Ixox/preenfm3/README.md

# preenfm3

Here are the sources for the preenfm3 bootloader and firmware.

Binaries can be found in the [Release section](https://github.com/Ixox/preenfm3/releases).

For the documentation, go to [the Wiki](https://github.com/Ixox/preenfm3/wiki).

Xavier
