Ixox/preenfm3/hardware/3DCase/pfm3Bottom.stl

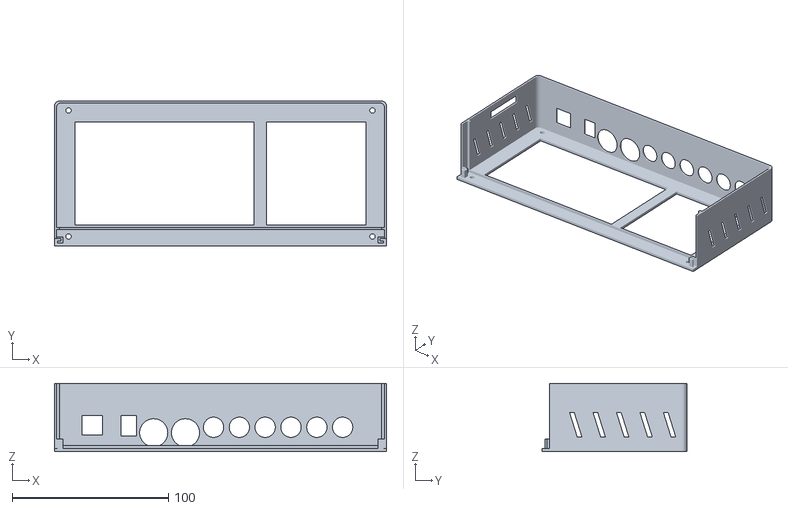
[picture p9: CAD file, 2020-09-30]
hardware/3DCase/pfm3Bottom.stl
212.3 x 92.6 x 43.5
