Ixox/preenfm3/hardware/3DCaseB/front_slim.stl

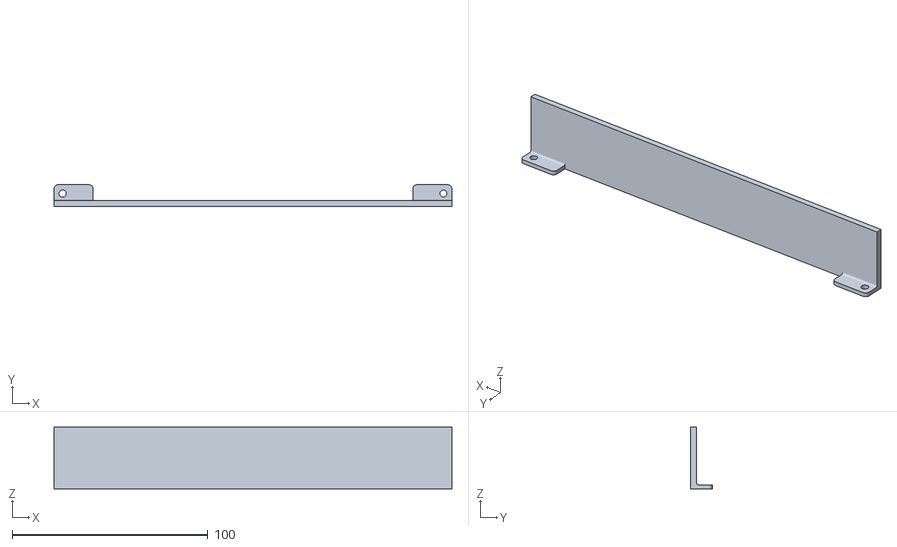
[picture p10: CAD file, 2021-01-17]
hardware/3DCaseB/front_slim.stl
203.1 x 11.0 x 31.4
