Ixox/preenfm3/hardware/3DCasePCB/3DPrint-Rear.stl

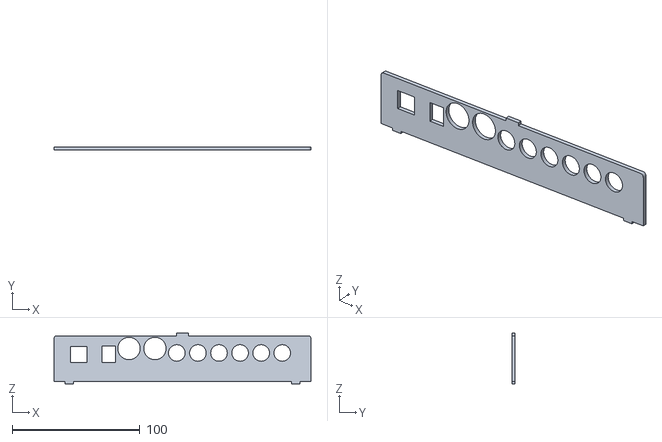
[picture p11: CAD file, 2021-04-17]
hardware/3DCasePCB/3DPrint-Rear.stl
201.2 x 2.70 x 39.6
