Ixox/preenfm3/hardware/3DCase/pfm3Top.stl

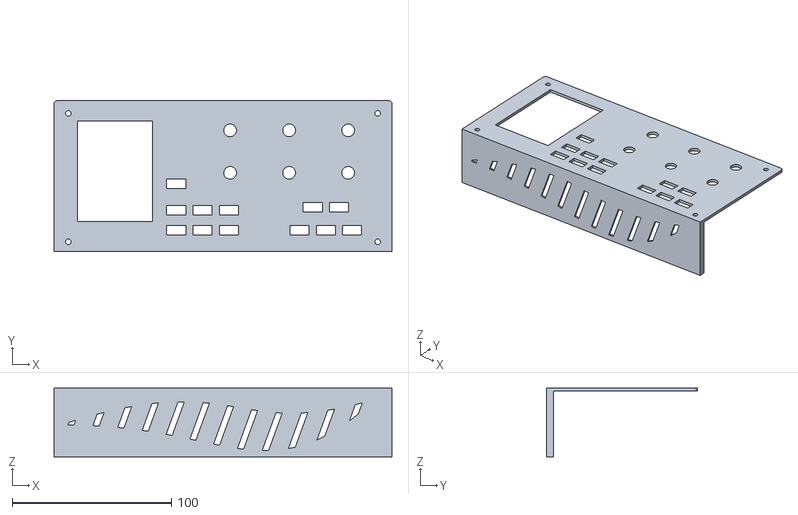
[picture p12: CAD file, 2020-09-30]
hardware/3DCase/pfm3Top.stl
212.3 x 94.6 x 43.3
