Ixox/preenfm3/hardware/3DCaseB/Rear_slim.stl

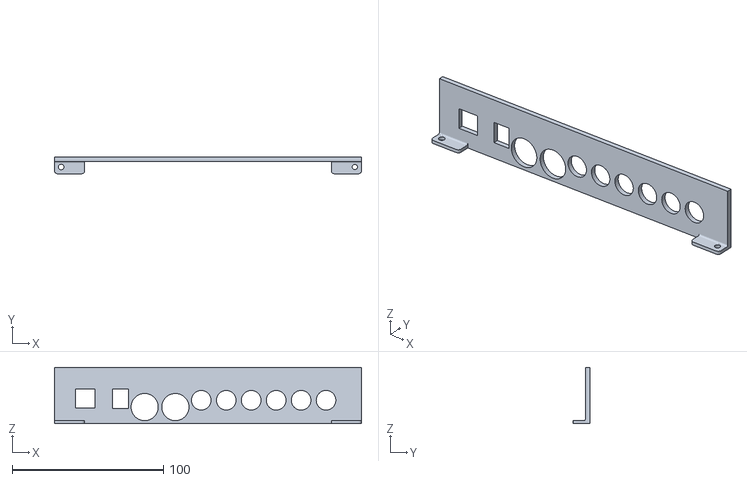
[picture p13: CAD file, 2021-01-17]
hardware/3DCaseB/Rear_slim.stl
203.1 x 11.0 x 37.3
