Ixox/preenfm3/hardware/3DCasePCB/3DPrint-Case.stl

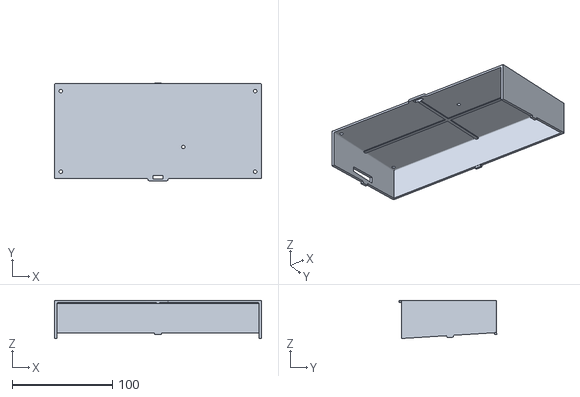
[picture p14: CAD file, 2021-04-17]
hardware/3DCasePCB/3DPrint-Case.stl
207.0 x 97.6 x 38.0
