Ixox/preenfm3/hardware/3DCaseB/bottom.stl

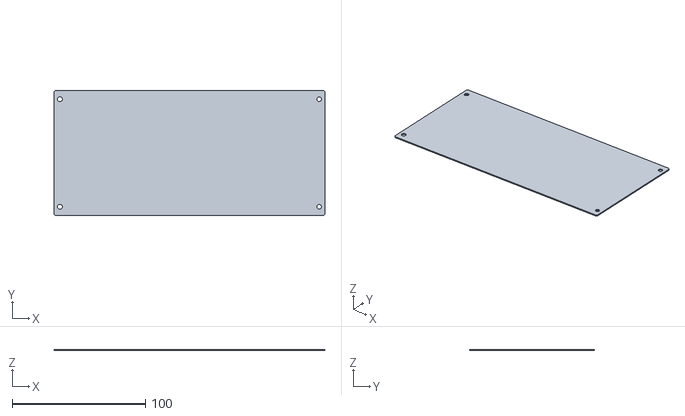
[picture p15: CAD file, 2020-10-13]
hardware/3DCaseB/bottom.stl
203.1 x 93.6 x 0.9
