Ixox/preenfm3/hardware/3DCaseB/front.stl

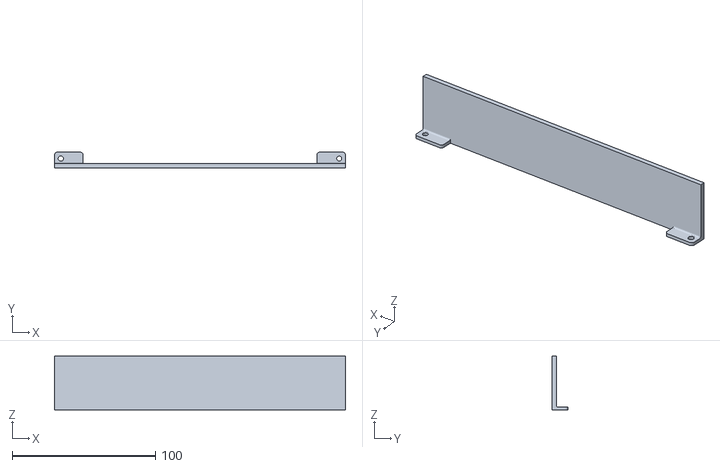
[picture p16: CAD file, 2020-10-13]
hardware/3DCaseB/front.stl
203.1 x 11.0 x 37.4
