Ixox/preenfm3/hardware/3DCaseB/Top.stl

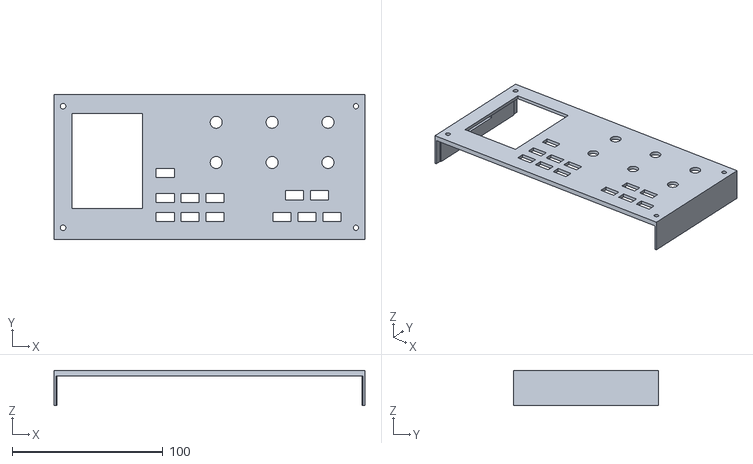
[picture p17: CAD file, 2020-10-13]
hardware/3DCaseB/Top.stl
206.3 x 96.1 x 23.4
