Ixox/preenfm3/hardware/3DCaseB/Rear.stl

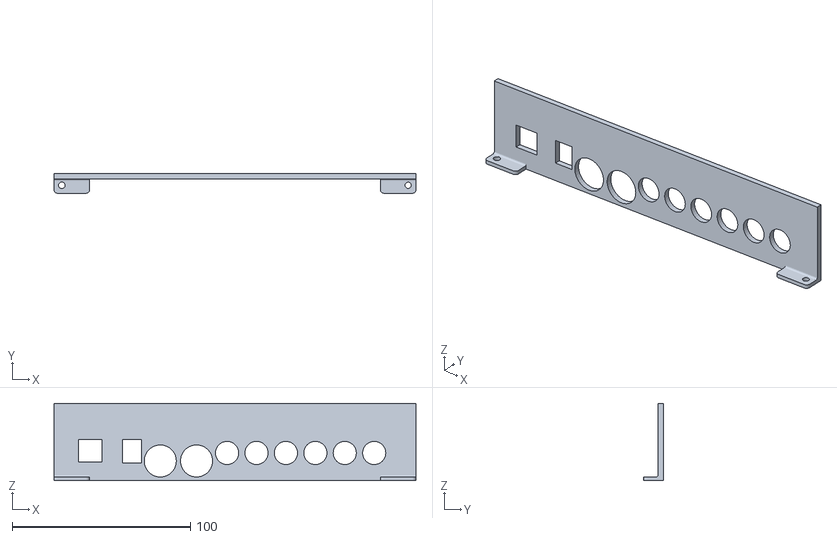
[picture p18: CAD file, 2020-10-13]
hardware/3DCaseB/Rear.stl
203.1 x 11.0 x 43.3
