Ixox/preenfm3/(list of files, cad)

Other CAD files:
hardware/3DCase/pfm3FrontPanel.f3d
hardware/3DCaseB/pfm3EnclosureV2.f3d
