Ixox/preenfm3/(threads)

Thread 3 (2020-10-16):

After flashin to 0.91 SD-Card is not readable

gritd, 2020-10-16:
I flash via dfuse, when I go back to 0.9 it all works again, but if i put .91 on it I get no read from the card. Also bootloader menu does not show valid filenames.

Ixox, 2020-10-26:
0.91 use DMA to send and receive data from the SD Card.
I don't know what it does not work with your SDCard.
What sdcard do you use ?

Ixox, 2021-01-03:
I assume it's working now.

gritd, 2021-01-03:
Not really 😬 I decided to wait in using the PreenFM3 until the enclosure
arrives - if I have problems with the SDcard later on I’ll post it, thanks!

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

Closed 2021-01-03.

Thread 4 (2020-11-05):

avoid wiki docs

axd1967, 2020-11-05:
This is a good step forward and please continue this way.

There is one issue that I would urge to change: avoid the wiki. Wikis look attractive (especially their menu system) but they have a major problem: they cannot be kept in sync with branches/code changes, because they are separate repositories. (And I'm more and more inclined to think that this is a fundamental issue with wikis on GitHub.)

Wiki-like pages can just as well be created in (e.g.) a `wiki/` folder under https://github.com/Ixox/preenfm3. this will allow to keep "wiki" pages and code in sync, because changes in firmware will sometimes impose changes in wiki pages, but because the commit/release cycles are different, there will be a need to keep wiki and code somehow in line during such transitions. branches are the natural way to deal with this: in a branch, code and wiki pages are updated at the same time, and this tight linking provides an additional bit of documentaiton. Also, this allows anyone that tracks the code to also detect changes in the wiki, and it bundles really all project information in one single repository that can easily be cloned.

Admitted, the wiki provides nice menus, that a normal page won't (but you can also benefit from markup in normal pages, e.g. by using `.rst` an an example).

See also https://github.com/Ixox/preenfm2/issues/1

Ixox, 2020-11-09:
Thanks that's interesting.
Will think about that.

axd1967, 2020-11-09:
If you think of it, `preenfm3` is just an evolution of `preenfm2` which is an evolution of `preenfm`. This is VCS parlance for "versions".

This can all be managed from a single repo.

Every new model starts off the latest branch of a previous model as a development branch (eg `model/3/idea`, `model/3/dev`) and is finally merged to a "master" (`model/3/maintenance`) and tagged (eg `v/2/2.08`, `v/2/2.20.b2`, `v/3/0.1`, `v/3/0.94`, ...)

Note the use of slashes to further increase the organisation of the tag namespace and avoid all tags ending up in a single tag namespace "soup" .  This can then also be admired from the CLI:

```
alex@xray:/tmp/preenfm3$ tree .git

.git
├── branches
├── config
├── description
├── FETCH_HEAD
├── gitk.cache
├── HEAD
├── hooks
│   ├── applypatch-msg.sample
│   ├── commit-msg.sample
│   ├── fsmonitor-watchman.sample
│   ├── post-update.sample
│   ├── pre-applypatch.sample
│   ├── pre-commit.sample
│   ├── pre-merge-commit.sample
│   ├── prepare-commit-msg.sample
│   ├── pre-push.sample
│   ├── pre-rebase.sample
│   ├── pre-receive.sample
│   └── update.sample
├── index
├── info
│   └── exclude
├── logs
│   ├── HEAD
│   └── refs
│       ├── heads
│       │   ├── master
│       │   └── model
│       │       ├── 3
│       │       │   └── maintenance
│       │       └── 4
│       │           └── dev
│       └── remotes
│           └── lxox
│               ├── Fdbk
│               ├── HEAD
│               ├── master
│               └── v094
├── objects

...
│   ├── info
│   └── pack
│       ├── pack-1fc59af7d14e7bfbe09e81c3f220f8514c556913.idx
│       └── pack-1fc59af7d14e7bfbe09e81c3f220f8514c556913.pack
├── ORIG_HEAD
├── packed-refs
└── refs
    ├── heads
    │   ├── master
    │   └── model
    │       ├── 3
    │       │   └── maintenance
    │       └── 4
    │           └── dev
    ├── remotes
    │   ├── lxox
    │   │   ├── Fdbk
    │   │   ├── HEAD
    │   │   ├── master
    │   │   └── v094
    │   └── origin
    └── tags
        └── v
            └── 3
                ├── 0.90
                ├── 0.93
                ├── 0.94
                ├── 1.0
                └── 1.0.1

55 directories, 73 files

```

`master` can become the development branch of the latest model but I would ditch `master` and use `model/N/dev` and `model/N/maintenance`; earlier, released models just receive maintenance branches (`model/N/maintenance`) to fix issues.

```
* c31668a (HEAD -> master, model/4/dev) release model 4
* 6356042 prepare for release
* e13683b continue R&D
*   4563fcf Merge branch 'model/3/dev'
|\
| * 382dbea more work
| * 273eb86 more work
| * 6a155e5 test
| | * 884ae7d (tag: v/3/1.0.1, model/3/maintenance) bugfix for model 3
| |/
|/|
* | 0fcdbf0 (tag: v/3/1.0) final!
* | c78e67f bugfix
* | f15655d (tag: v0.94, tag: v/3/0.94, lxox/master, lxox/HEAD) Remove Debug info from Release
* | af9ff15 Merge pull request #5 from Ixox/v094
|\|
| * ac59d07 (lxox/v094) Fix buton state bug (Crash)
| * c5db765 Multiple edition show up in green
| * 86f4438 Multiple param edition : EDIT + encoder turn
| * 49b342b v0.94 first commit
| * 2df6b30 Modification to use last lib
| * dff063d Small display optimization and stability
| * 4233930 Control board v1.1
|/
* c086304 (tag: v0.93, tag: v/3/0.93) Bootlader 1.03 TFT fixed
* 0621950 Slower and much more stable UI with some TFTs
* c496182 Fix quick start doc
* 7cb2100 doc/README added
* 1405230 Add quick start pdf doc
* 04bc544 (tag: v0.92) Tiny type fix
* 26a9d33 Limit SD SPI to 12.5Mhz (will use actually 7.5Mhz)
* c815cb4 Bootloader 1.02 : use button 1,2,3
* c0ab974 Create object use _ in bin names
* bb52e92 No more DEBUG preprocessing in Release
* 9d41875 Better Seq presentation
* 412e46b Fix seq cursor refresh bug
* 251d024 Sequencer has its own default file
* dc86de4 Sequence V2 bug fix
* 5276057 Sequencer V2 + many small fixes
* 8a0f6af update version.h
* eb0416d Add colors after reinit TFT
* b9349bf Faster encoder polling
* dce21d6 3DCaseB added
* eaef23f (tag: v0.91) Allow -O3 on preenfm3_lib
* 6850231 Bootloader fixed : SD access don't use DMA
*   4510205 Merge pull request #2 from Ixox/Fdbk

```

a bit simplified:

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

As you can see, I use `gitk`... The power of Git is in the concepts.

Some Git clients can represent tags and branches in a nice tree (which then allows to collapse unneeded sections), that's an additional reason to use slashes in those names.

Consider this approach for version 4 onwards? This will unify all future work of all preenFM knowledge in a single repo.

Ixox, 2020-11-21:
Thanks a lot for the detailed message.
If one day i have more free time, i'll change many things (better git management is one of those ;) ).

axd1967, 2020-11-21:
Don't worry - this is a slow but steady process, you are on the right track.

Thread 48 (2024-05-07):

Sequencer insert note after clearing

WouterSpekkink, 2024-05-07:
I was exploring the sequencer and I noticed one weird behavior. If you insert an empty space (button 1), then it is no longer possible to dial in a note in that space. You can only insert notes in the space again after clearing the whole pattern.

pvig, 2024-05-15:
I cannot reproduce the issue.
Do you have any clue about it ?

WouterSpekkink, 2024-05-16:
To be clear, the problem only occurs when I try to dial in notes (without the midi controller). Inserting notes with a midi controller still works after inserting a blank space.

I was trying to see if the sequencer could work as a standalone (without midi controller), but I have noticed that notes also don't play unless at least one of them was inserted with a midi controller.

pvig, 2024-05-16:
ok, i could reproduce the issue :
you can't edit notes with the "Note" key pressed and encoder B, on a cleared spaces ,
a workaround is to fill a whole row with one note, and then you can edit smaller notes inside it,
but yes, it would be nice to be able to add notes with this method.

I face another issue : new notes seems to be retriggered on each ticks for some reason.
Old sequences loaded at synth startup works well.

Thread 50 (2024-05-10):

Program Change reverts to preen presets even if dx7 preset is loaded.

abelnation, 2024-05-10:
(This is my current understanding) When I load a dx7 sysex file, I would expect program change messages to select patches from the same dx7 file; however, it appears that PC messages only select patches from whatever the current/last preen bank is currently selected.

Thread 57 (2025-09-03):

DX7 import loads saw instead of sin

gresade, 2025-09-03:
When importing patches, e.g. "PIANO 32" form "PIANO_01.SYX" using algo 18,
Operator 3 loads the saw waveform, which should be sin.
Changing the Operator to 3 adjusts the sound in the right direction, sounding more piano-ish.
It looks like many sounds are sounding different (modulated too much) than in the DX7 due to the saw loaded in Hexter.cpp into Oscs if fb>4.
As there is now a feedback setting available, this saw code fix is not needed anymore, I guess?

I think in any case sin should be loaded in all operators for DX7 patches?
