Ixox/preenfm3/(list of files, drawings)

Other design files:
hardware/controlboard_SMD/v1.x_for_v2.x/pfm3_ctrl.dsn
