Ixox/preenfm3/hardware/controlboard_SMD/v1.x_for_v2.x/pfm3_ctrl.kicad_pcb

## KiCad design hardware/controlboard_SMD/v1.x_for_v2.x/pfm3_ctrl.kicad_pcb (2023-05-15)

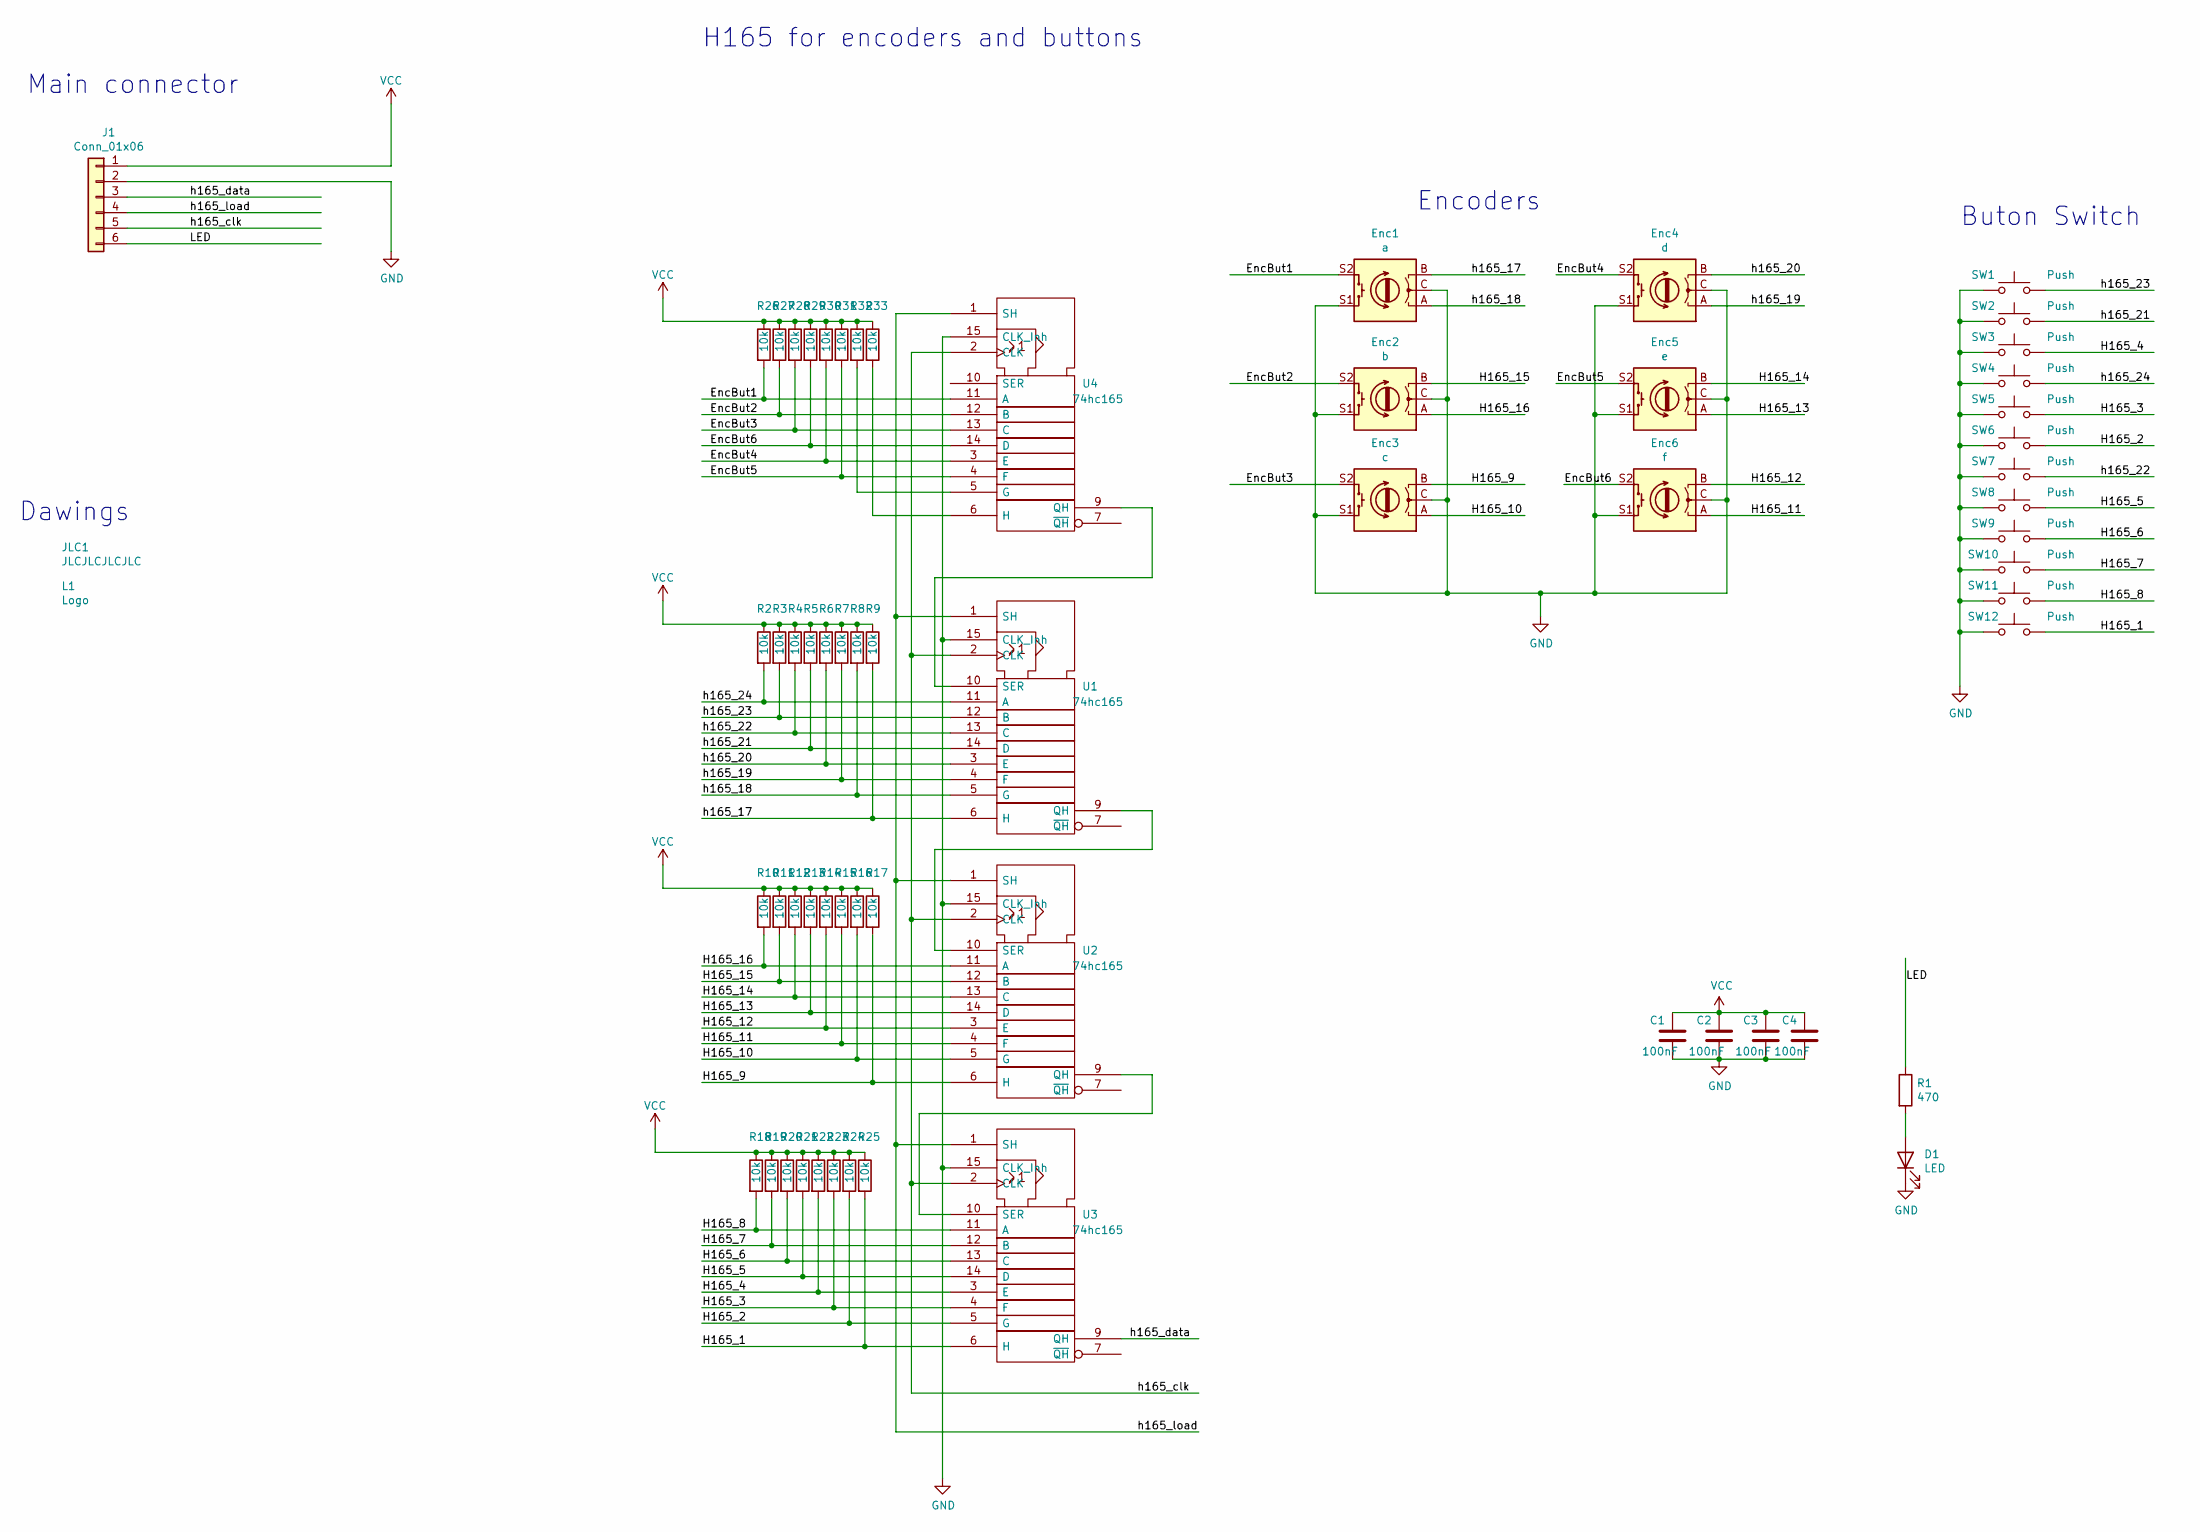
[picture p19: schematic pfm3_ctrl.sch, preenfm3]

Parts:
C1, C2, C3, C4: 100nF; C_0402_1005Metric
D1: LED; LED_0603_1608Metric
Enc1: a; FMEncoder2_pfm3
Enc2: b; FMEncoder2_pfm3
Enc3: c; FMEncoder2_pfm3
Enc4: d; FMEncoder2_pfm3
Enc5: e; FMEncoder2_pfm3
Enc6: f; FMEncoder2_pfm3
J1: Conn_01x06; ControlBoard_2
JLC1: JLCJLCJLCJLC; JLCJLC
L1: Logo; pfm2_logo
R1: 470; R_0603_1608Metric
R2, R3, R4, R5, R6, R7, R8, R9, R10, R11, R12, R13, R14, R15, R16, R17, R18, R19, R20, R21, R22, R23, R24, R25, R26, R27, R28, R29, R30, R31, R32, R33: 10k; R_0402_1005Metric
SW1, SW2, SW3, SW4, SW5, SW6, SW7, SW8, SW9, SW10, SW11, SW12: Push; FMButton2
U1, U2, U3, U4: 74hc165; SOIC-16_3.9x9.9mm_P1.27mm

Connections:
/EncBut1: Enc1.S2, R26.2, U4.11 (A)
/EncBut2: Enc2.S2, R27.2, U4.12 (B)
/EncBut3: Enc3.S2, R28.2, U4.13 (C)
/EncBut4: Enc4.S2, R30.2, U4.3 (E)
/EncBut5: Enc5.S2, R31.2, U4.4 (F)
/EncBut6: Enc6.S2, R29.2, U4.14 (D)
/H165_1: R25.2, SW12.2, U3.6 (H)
/H165_2: R24.2, SW6.2, U3.5 (G)
/H165_3: R23.2, SW5.2, U3.4 (F)
/H165_4: R22.2, SW3.2, U3.3 (E)
/H165_5: R21.2, SW8.2, U3.14 (D)
/H165_6: R20.2, SW9.2, U3.13 (C)
/H165_7: R19.2, SW10.2, U3.12 (B)
/H165_8: R18.2, SW11.2, U3.11 (A)
/H165_9: Enc3.B, R17.2, U2.6 (H)
/H165_10: Enc3.A, R16.2, U2.5 (G)
/H165_11: Enc6.A, R15.2, U2.4 (F)
/H165_12: Enc6.B, R14.2, U2.3 (E)
/H165_13: Enc5.A, R13.2, U2.14 (D)
/H165_14: Enc5.B, R12.2, U2.13 (C)
/H165_15: Enc2.B, R11.2, U2.12 (B)
/H165_16: Enc2.A, R10.2, U2.11 (A)
/LED: J1.6, R1.1
/h165_17: Enc1.B, R9.2, U1.6 (H)
/h165_18: Enc1.A, R8.2, U1.5 (G)
/h165_19: Enc4.A, R7.2, U1.4 (F)
/h165_20: Enc4.B, R6.2, U1.3 (E)
/h165_21: R5.2, SW2.2, U1.14 (D)
/h165_22: R4.2, SW7.2, U1.13 (C)
/h165_23: R3.2, SW1.2, U1.12 (B)
/h165_24: R2.2, SW4.2, U1.11 (A)
/h165_clk: J1.5, U1.2 (CLK), U2.2 (CLK), U3.2 (CLK), U4.2 (CLK)
/h165_data: J1.3, U3.9 (QH)
/h165_load: J1.4, U1.1 (SH), U2.1 (SH), U3.1 (SH), U4.1 (SH)
GND: C1.2, C2.2, C3.2, C4.2, D1.1 (K), Enc1.C, Enc1.S1, Enc2.C, Enc2.S1, Enc3.C, Enc3.S1, Enc4.C, Enc4.S1, Enc5.C, Enc5.S1, Enc6.C, Enc6.S1, J1.2, SW1.1, SW2.1, SW3.1, SW4.1, SW5.1, SW6.1, SW7.1, SW8.1, SW9.1, SW10.1, SW11.1, SW12.1, U1.8 (GND), U1.15 (CLK_Inh), U2.8 (GND), U2.15 (CLK_Inh), U3.8 (GND), U3.15 (CLK_Inh), U4.8 (GND), U4.15 (CLK_Inh)
unnamed: D1.2 (A), R1.2
unnamed: R32.2, U4.5 (G)
unnamed: R33.2, U4.6 (H)
unnamed: U1.9 (QH), U2.10 (SER)
unnamed: U1.10 (SER), U4.9 (QH)
unnamed: U2.9 (QH), U3.10 (SER)
VCC: C1.1, C2.1, C3.1, C4.1, J1.1, R2.1, R3.1, R4.1, R5.1, R6.1, R7.1, R8.1, R9.1, R10.1, R11.1, R12.1, R13.1, R14.1, R15.1, R16.1, R17.1, R18.1, R19.1, R20.1, R21.1, R22.1, R23.1, R24.1, R25.1, R26.1, R27.1, R28.1, R29.1, R30.1, R31.1, R32.1, R33.1, U1.16 (VCC), U2.16 (VCC), U3.16 (VCC), U4.16 (VCC)

Notes on the sheet:
Buton Switch
Encoders
H165 for encoders and buttons
Main connector
Dawings

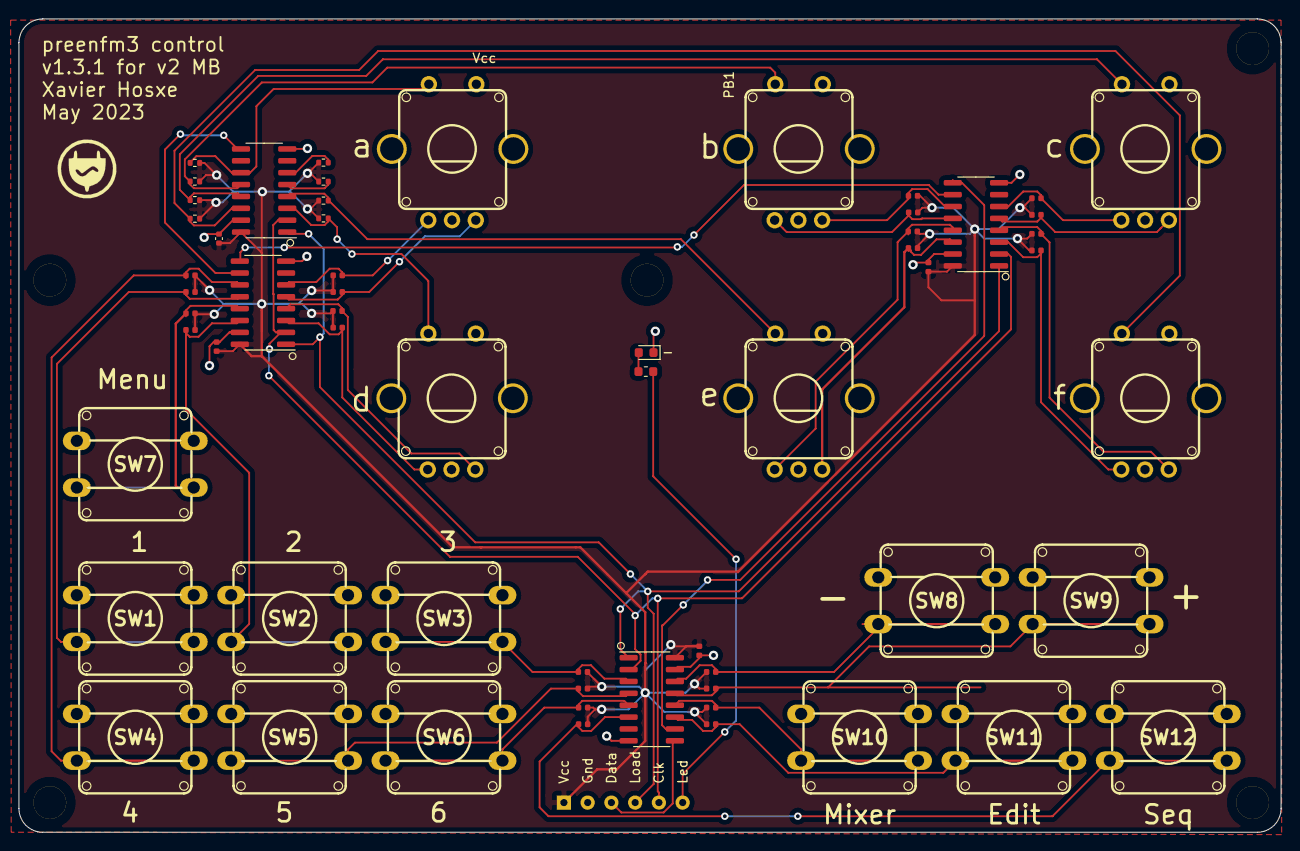
[picture p20: board hardware/controlboard_SMD/v1.x_for_v2.x/pfm3_ctrl.kicad_pcb from above]

Board: 2 copper layers, 135.0 x 87.0 mm, 63 parts (1 on the bottom side), 42 nets.
