Ixox/preenfm3/hardware/controlboard/pfm3_ctrl.kicad_pcb

## KiCad design hardware/controlboard/pfm3_ctrl.kicad_pcb (2020-09-22, an earlier design)

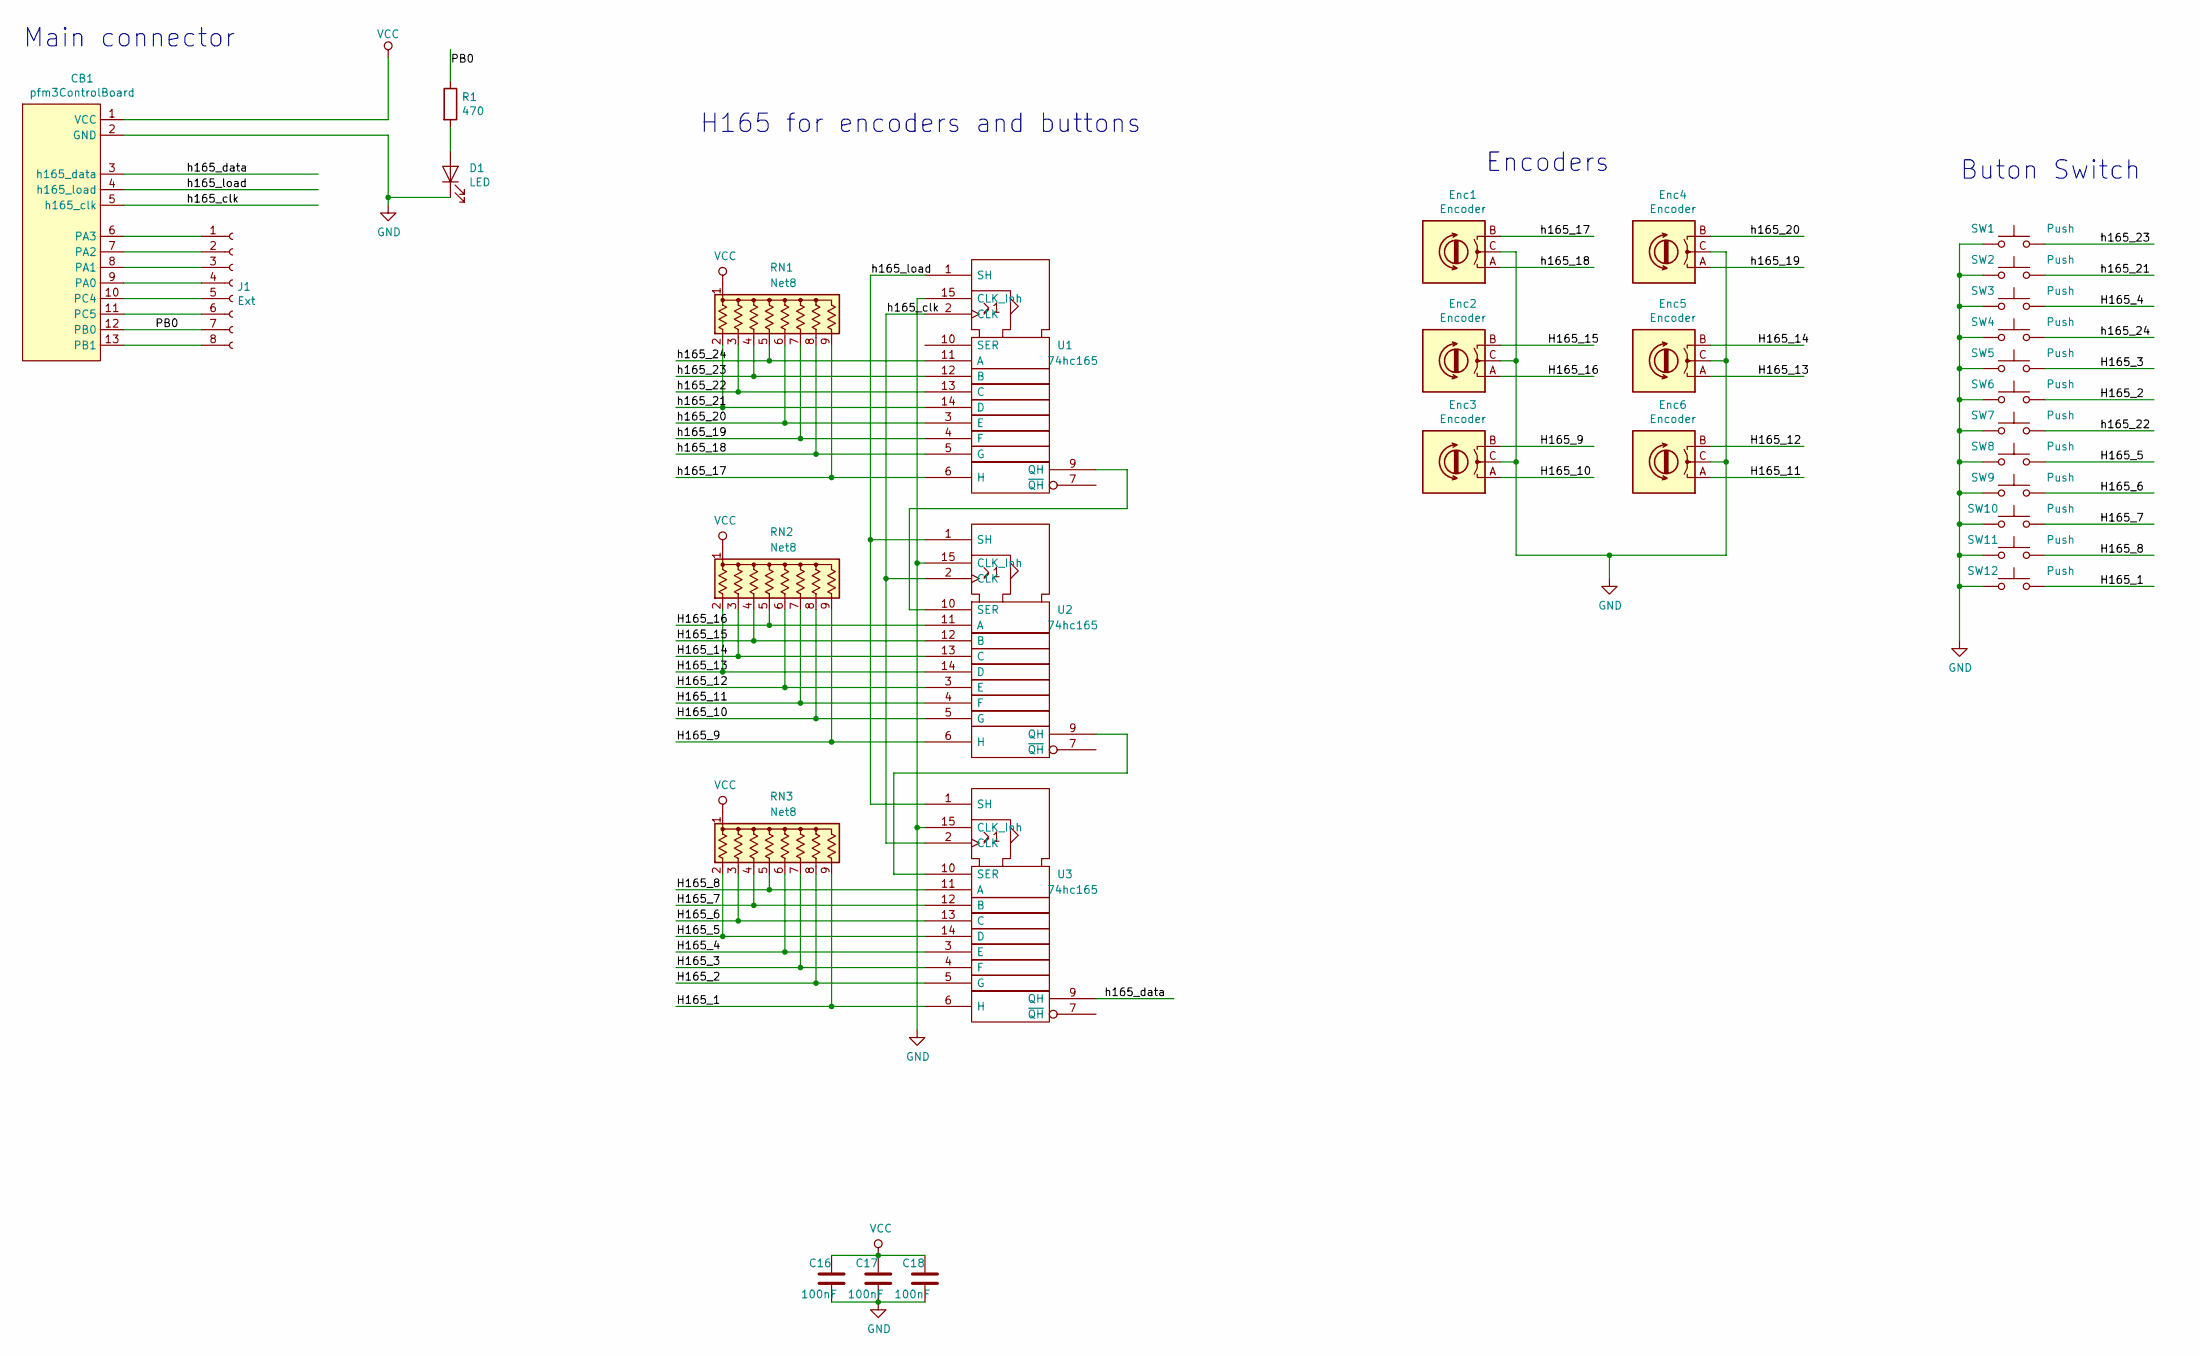
[picture p21: schematic pfm3_ctrl.sch, preenfm3]

Parts:
C16, C17, C18: 100nF; C_Disc_D3.0mm_W1.6mm_P2.50mm
CB1: pfm3ControlBoard; ControlBoard
D1: LED; FMLed_pfm3
Enc1, Enc2, Enc3, Enc4, Enc5, Enc6: Encoder; FMEncoder2_pfm3
J1: Ext; PinHeader_1x08_P2.54mm_Vertical
R1: 470; R_Axial_DIN0207_L6.3mm_D2.5mm_P7.62mm_Horizontal
RN1, RN2, RN3: Net8; R_Array_SIP9
SW1, SW2, SW3, SW4, SW5, SW6, SW7, SW8, SW9, SW10, SW11, SW12: Push; FMButton2
U1, U2, U3: 74hc165; 74HC165

Connections:
/H165_1: RN3.9 (R8), SW12.2, U3.6 (H)
/H165_2: RN3.8 (R7), SW6.2, U3.5 (G)
/H165_3: RN3.7 (R6), SW5.2, U3.4 (F)
/H165_4: RN3.6 (R5), SW3.2, U3.3 (E)
/H165_5: RN3.2 (R1), SW8.2, U3.14 (D)
/H165_6: RN3.3 (R2), SW9.2, U3.13 (C)
/H165_7: RN3.4 (R3), SW10.2, U3.12 (B)
/H165_8: RN3.5 (R4), SW11.2, U3.11 (A)
/H165_9: Enc3.B, RN2.9 (R8), U2.6 (H)
/H165_10: Enc3.A, RN2.8 (R7), U2.5 (G)
/H165_11: Enc6.A, RN2.7 (R6), U2.4 (F)
/H165_12: Enc6.B, RN2.6 (R5), U2.3 (E)
/H165_13: Enc5.A, RN2.2 (R1), U2.14 (D)
/H165_14: Enc5.B, RN2.3 (R2), U2.13 (C)
/H165_15: Enc2.B, RN2.4 (R3), U2.12 (B)
/H165_16: Enc2.A, RN2.5 (R4), U2.11 (A)
/PB0: CB1.12 (PB0), J1.7, R1.1
/h165_17: Enc1.B, RN1.9 (R8), U1.6 (H)
/h165_18: Enc1.A, RN1.8 (R7), U1.5 (G)
/h165_19: Enc4.A, RN1.7 (R6), U1.4 (F)
/h165_20: Enc4.B, RN1.6 (R5), U1.3 (E)
/h165_21: RN1.2 (R1), SW2.2, U1.14 (D)
/h165_22: RN1.3 (R2), SW7.2, U1.13 (C)
/h165_23: RN1.4 (R3), SW1.2, U1.12 (B)
/h165_24: RN1.5 (R4), SW4.2, U1.11 (A)
/h165_clk: CB1.5 (h165_clk), U1.2 (CLK), U2.2 (CLK), U3.2 (CLK)
/h165_data: CB1.3 (h165_data), U3.9 (QH)
/h165_load: CB1.4 (h165_load), U1.1 (SH), U2.1 (SH), U3.1 (SH)
GND: C16.2, C17.2, C18.2, CB1.2 (GND), D1.1 (K), Enc1.C, Enc2.C, Enc3.C, Enc4.C, Enc5.C, Enc6.C, SW1.1, SW2.1, SW3.1, SW4.1, SW5.1, SW6.1, SW7.1, SW8.1, SW9.1, SW10.1, SW11.1, SW12.1, U1.8 (GND), U1.15 (CLK_Inh), U2.8 (GND), U2.15 (CLK_Inh), U3.8 (GND), U3.15 (CLK_Inh)
unnamed: CB1.6 (PA3), J1.1
unnamed: CB1.7 (PA2), J1.2
unnamed: CB1.8 (PA1), J1.3
unnamed: CB1.9 (PA0), J1.4
unnamed: CB1.10 (PC4), J1.5
unnamed: CB1.11 (PC5), J1.6
unnamed: CB1.13 (PB1), J1.8
unnamed: D1.2 (A), R1.2
unnamed: U1.9 (QH), U2.10 (SER)
unnamed: U2.9 (QH), U3.10 (SER)
VCC: C16.1, C17.1, C18.1, CB1.1 (VCC), RN1.1 (common), RN2.1 (common), RN3.1 (common), U1.16 (VCC), U2.16 (VCC), U3.16 (VCC)

Notes on the sheet:
Buton Switch
Encoders
H165 for encoders and buttons
Main connector

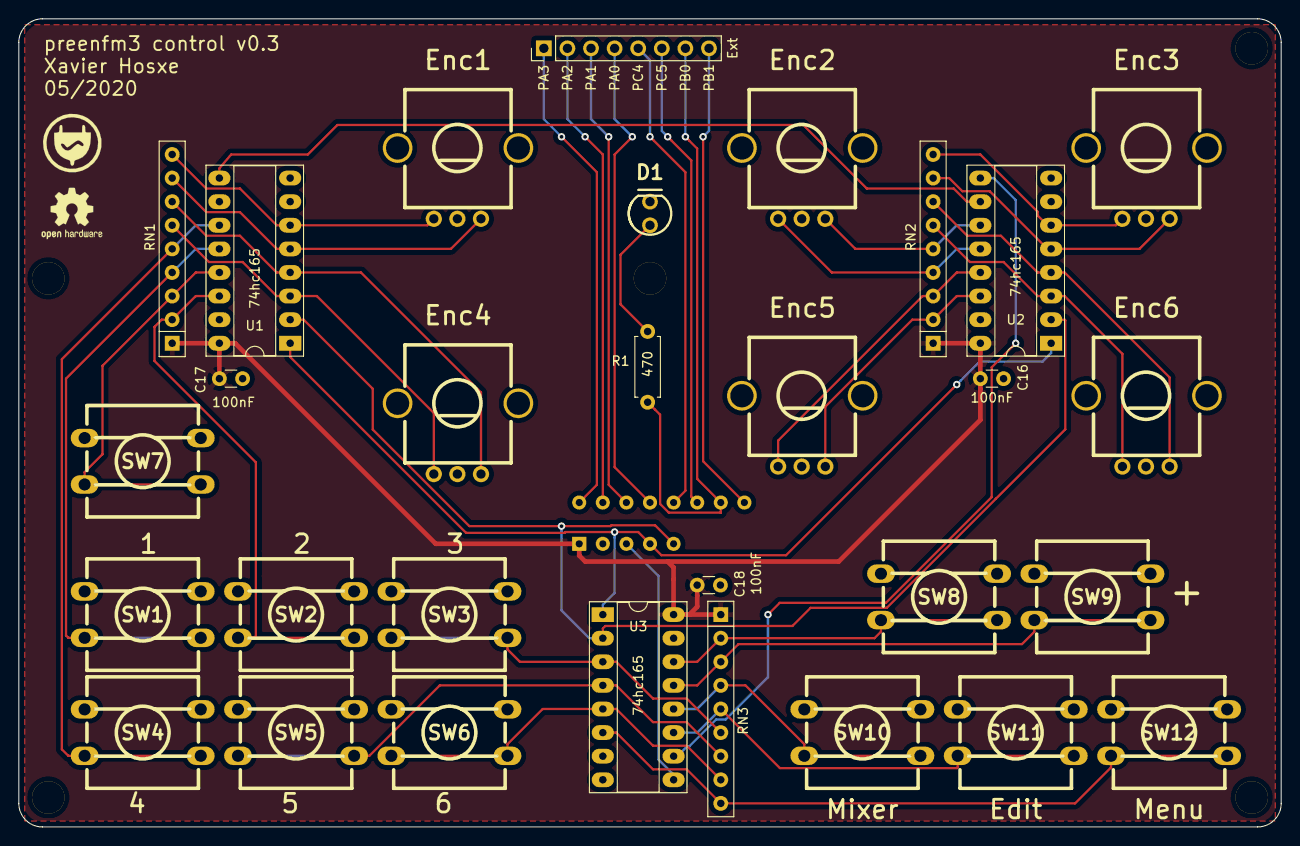
[picture p22: board hardware/controlboard/pfm3_ctrl.kicad_pcb from above]

Board: 2 copper layers, 135.9 x 87.0 mm, 31 parts (0 on the bottom side), 40 nets.
