Ixox/preenfm3/firmware/Src/main.c

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

/* Includes ------------------------------------------------------------------*/
#include "main.h"
#include "usb_device.h"

/* USER CODE BEGIN Includes */
#include <stdbool.h>
#include "stdlib.h"
#include "preenfm3.h"
#include "preenfm3lib.h"
/* USER CODE END Includes */


DMA2D_HandleTypeDef hdma2d;

RNG_HandleTypeDef hrng;

SAI_HandleTypeDef hsai_BlockA1;
SAI_HandleTypeDef hsai_BlockB1;
SAI_HandleTypeDef hsai_BlockA2;
DMA_HandleTypeDef hdma_sai1_a;
DMA_HandleTypeDef hdma_sai1_b;
DMA_HandleTypeDef hdma_sai2_a;

SPI_HandleTypeDef hspi1;
DMA_HandleTypeDef hdma_spi1_tx;
DMA_HandleTypeDef hdma_spi2_rx;
DMA_HandleTypeDef hdma_spi2_tx;

TIM_HandleTypeDef htim1;

UART_HandleTypeDef huart1;

MDMA_HandleTypeDef hmdma_mdma_channel40_sw_0;
/* USER CODE BEGIN PV */
volatile uint8_t midiControllerMode = 0;
/* USER CODE END PV */

void SystemClock_Config(void);
static void MX_DMA_Init(void);
static void MX_DMA2D_Init(void);
static void MX_RNG_Init(void);
static void MX_SAI1_Init(void);
static void MX_SAI2_Init(void);
static void MX_SPI1_Init(void);
static void MX_SPI2_Init(void);
static void MX_USART1_UART_Init(void);
static void MX_TIM3_Init(void);
/* USER CODE BEGIN PFP */
// PW for TFT backlight
static void MX_TIM1_Init(void);
void MPU_RegionConfig();

#define USE_DMA_FOR_SD_ACCESS true

/* USER CODE END PFP */

/* USER CODE BEGIN 0 */

void Reinit_SPI2(void)  {
	MX_SPI2_Init();
}

/* USER CODE END 0 */

/**
  * @brief  The application entry point.
  * @retval int
  */
int main(void)
{
  /* Enable I-Cache---------------------------------------------------------*/
  SCB_EnableICache();

  /* Enable D-Cache---------------------------------------------------------*/
  SCB_EnableDCache();

  /* MCU Configuration--------------------------------------------------------*/

  /* Reset of all peripherals, Initializes the Flash interface and the Systick. */
  HAL_Init();

  /* Configure the system clock */
  SystemClock_Config();

  /* USER CODE BEGIN SysInit */
#ifdef UNDEFINED_PREENFM3_NEEDS_CONTROL_ON_GPIO_INIT
  /* USER CODE END SysInit */

  /* Initialize all configured peripherals */
  MX_GPIO_Init();
  MX_DMA_Init();
  MX_DMA2D_Init();
  MX_RNG_Init();
  MX_SAI1_Init();
  MX_SAI2_Init();
  MX_SPI1_Init();
  MX_SPI2_Init();
  MX_USB_DEVICE_Init();
  MX_USART1_UART_Init();
  MX_TIM3_Init();
  /* USER CODE BEGIN 2 */
#endif
  preenfm3LibInitGpio();
  MX_DMA_Init();
  MX_DMA2D_Init();
  MX_RNG_Init();
  MX_SAI1_Init();
  MX_SAI2_Init();
  MX_SPI1_Init();
  MX_SPI2_Init();
  MX_FATFS_Init(USE_DMA_FOR_SD_ACCESS);
  MX_USB_DEVICE_Init();
  MX_USART1_UART_Init();
  MX_TIM1_Init();

  MPU_RegionConfig();

  // If button 1 is pressed => Midi controller mode
//  if (isButton1Pressed()) {
//      midiControllerMode = 1;
//      preenfm3MidiControllerInit();
//  } else {
      // main preenfm3 init
      preenfm3Init();
      // Also init Midi controller display and load state from SD card
      preenfm3MidiControllerInit();
//  }

  /* USER CODE END 2 */

  /* Infinite loop */
  /* USER CODE BEGIN WHILE */

  while (1)
  {
      switch (midiControllerMode) {
      case 0:
          preenfm3Loop();
          break;
      case 1:
          preenfm3MidiControllerLoop();
          break;
      case 2:
      // Do nothing
          break;
      }
    /* USER CODE END WHILE */

    /* USER CODE BEGIN 3 */
  }
  /* USER CODE END 3 */
}

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
/* USER CODE BEGIN 4 */



/**
  * @brief TIM1 Initialization Function
  * @param None
  * @retval None
  */
static void MX_TIM1_Init(void)
{

  TIM_MasterConfigTypeDef sMasterConfig = {0};
  TIM_OC_InitTypeDef sConfigOC = {0};

  htim1.Instance = TIM1;
  htim1.Init.Prescaler = 240;
  htim1.Init.CounterMode = TIM_COUNTERMODE_UP;
  htim1.Init.Period = 100;
  htim1.Init.ClockDivision = TIM_CLOCKDIVISION_DIV1;
  htim1.Init.AutoReloadPreload = TIM_AUTORELOAD_PRELOAD_DISABLE;
  if (HAL_TIM_PWM_Init(&htim1) != HAL_OK)
  {
    Error_Handler();
  }
  sMasterConfig.MasterOutputTrigger = TIM_TRGO_RESET;
  sMasterConfig.MasterSlaveMode = TIM_MASTERSLAVEMODE_DISABLE;
  if (HAL_TIMEx_MasterConfigSynchronization(&htim1, &sMasterConfig) != HAL_OK)
  {
    Error_Handler();
  }
  sConfigOC.OCMode = TIM_OCMODE_PWM1;
  sConfigOC.Pulse = 50;
  sConfigOC.OCPolarity = TIM_OCPOLARITY_HIGH;
  sConfigOC.OCFastMode = TIM_OCFAST_DISABLE;
  if (HAL_TIM_PWM_ConfigChannel(&htim1, &sConfigOC, TIM_CHANNEL_2) != HAL_OK)
  {
    Error_Handler();
  }
  HAL_TIM_MspPostInit(&htim1);

}

void MPU_RegionConfig(void) {
    MPU_Region_InitTypeDef MPU_InitStruct;

    /* Disable the MPU */
    HAL_MPU_Disable();

    /* Configure the MPU attributes as WT for RADM_D1 */

    MPU_InitStruct.Number = MPU_REGION_NUMBER1;
    MPU_InitStruct.Enable = MPU_REGION_ENABLE;
    MPU_InitStruct.BaseAddress = 0x24000000;
    MPU_InitStruct.Size = MPU_REGION_SIZE_512KB;
    MPU_InitStruct.AccessPermission = MPU_REGION_FULL_ACCESS;
    MPU_InitStruct.IsBufferable = MPU_ACCESS_NOT_BUFFERABLE;
    MPU_InitStruct.IsCacheable = MPU_ACCESS_CACHEABLE;
    MPU_InitStruct.IsShareable = MPU_ACCESS_NOT_SHAREABLE;
    MPU_InitStruct.TypeExtField = MPU_TEX_LEVEL0;
    MPU_InitStruct.SubRegionDisable = 0x00;
    MPU_InitStruct.DisableExec = MPU_INSTRUCTION_ACCESS_DISABLE;

    HAL_MPU_ConfigRegion(&MPU_InitStruct);

    /* Configure the MPU attributes as WT for RADM_D2 (first 128ko) */
    // waveforms sent to DAC through SAI
    MPU_InitStruct.Number = MPU_REGION_NUMBER2;
    MPU_InitStruct.Enable = MPU_REGION_ENABLE;
    MPU_InitStruct.BaseAddress = 0x30000000;
    MPU_InitStruct.Size = MPU_REGION_SIZE_128KB;
    MPU_InitStruct.AccessPermission = MPU_REGION_FULL_ACCESS;
    MPU_InitStruct.IsBufferable = MPU_ACCESS_NOT_BUFFERABLE;
    MPU_InitStruct.IsCacheable = MPU_ACCESS_CACHEABLE;
    MPU_InitStruct.IsShareable = MPU_ACCESS_NOT_SHAREABLE;
    MPU_InitStruct.TypeExtField = MPU_TEX_LEVEL0;
    MPU_InitStruct.SubRegionDisable = 0x00;
    MPU_InitStruct.DisableExec = MPU_INSTRUCTION_ACCESS_DISABLE;

    HAL_MPU_ConfigRegion(&MPU_InitStruct);

    /* Configure the MPU attributes as WT for RADM_D2B */
    // Some variables are here
    MPU_InitStruct.Number = MPU_REGION_NUMBER3;
    MPU_InitStruct.Enable = MPU_REGION_ENABLE;
    MPU_InitStruct.BaseAddress = 0x30020000;
    MPU_InitStruct.Size = MPU_REGION_SIZE_128KB;
    MPU_InitStruct.AccessPermission = MPU_REGION_FULL_ACCESS;
    MPU_InitStruct.IsBufferable = MPU_ACCESS_BUFFERABLE;
    MPU_InitStruct.IsCacheable = MPU_ACCESS_CACHEABLE;
    MPU_InitStruct.IsShareable = MPU_ACCESS_SHAREABLE;
    MPU_InitStruct.TypeExtField = MPU_TEX_LEVEL0;
    MPU_InitStruct.SubRegionDisable = 0x00;
    MPU_InitStruct.DisableExec = MPU_INSTRUCTION_ACCESS_DISABLE;

    HAL_MPU_ConfigRegion(&MPU_InitStruct);

    /* Configure the MPU attributes as WT for RADM_D3 */
    MPU_InitStruct.Number = MPU_REGION_NUMBER4;
    MPU_InitStruct.Enable = MPU_REGION_ENABLE;
    MPU_InitStruct.BaseAddress = 0x38000000;
    MPU_InitStruct.Size = MPU_REGION_SIZE_64KB;
    MPU_InitStruct.AccessPermission = MPU_REGION_FULL_ACCESS;
    MPU_InitStruct.IsBufferable = MPU_ACCESS_BUFFERABLE;
    MPU_InitStruct.IsCacheable = MPU_ACCESS_CACHEABLE;
    MPU_InitStruct.IsShareable = MPU_ACCESS_SHAREABLE;
    MPU_InitStruct.TypeExtField = MPU_TEX_LEVEL0;
    MPU_InitStruct.SubRegionDisable = 0x00;
    MPU_InitStruct.DisableExec = MPU_INSTRUCTION_ACCESS_DISABLE;

    HAL_MPU_ConfigRegion(&MPU_InitStruct);

    /* Enable the MPU */
    HAL_MPU_Enable(MPU_PRIVILEGED_DEFAULT);
}



/* USER CODE END 4 */
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
