Ixox/preenfm3/firmware/preenfm3.ioc

Mcu.UserName=STM32H753VITx
PA11.Signal=USB_OTG_FS_DM
PA12.Signal=USB_OTG_FS_DP
PA5.Signal=SPI1_SCK
PA6.Signal=SPI1_MISO
PA7.Signal=SPI1_MOSI
PB1.Signal=S_TIM3_CH4
PB13.Signal=SPI2_SCK
PB14.Signal=SPI2_MISO
PB15.Signal=SPI2_MOSI
PB6.Signal=USART1_TX
PB7.Signal=USART1_RX
PD11.Signal=SAI2_SD_A
PE10.GPIO_Label=SD_CS
PE10.Signal=GPIO_Output
PE11.GPIO_Label=TFT_CS
PE11.Signal=GPIO_Output
PE12.GPIO_Label=TFT_DC
PE12.Signal=GPIO_Output
PE13.GPIO_Label=TFT_RESET
PE13.Signal=GPIO_Output
PE2.Signal=SAI1_MCLK_A
PE3.Signal=SAI1_SD_B
PE4.Signal=SAI1_FS_A
PE5.Signal=SAI1_SCK_A
PE6.Signal=SAI1_SD_A
PE7.GPIO_Label=HC165_CLK
PE7.Signal=GPIO_Output
PE8.GPIO_Label=HC165_LOAD
PE8.Signal=GPIO_Output
PE9.GPIO_Label=HC165_DATA
PE9.Signal=GPIO_Input
