Ixox/preenfm3/firmware/Src/hardware/FMDisplayMixer.cpp

/*
 *
 * Author: Xavier Hosxe (xavier . hosxe (at) gmail . com)
 *
 * This program is free software: you can redistribute it and/or modify
 * it under the terms of the GNU General Public License as published by
 * the Free Software Foundation, either version 3 of the License, or
 * (at your option) any later version.
 * This program is distributed in the hope that it will be useful,
 * but WITHOUT ANY WARRANTY; without even the implied warranty of
 * MERCHANTABILITY or FITNESS FOR A PARTICULAR PURPOSE.  See the
 * GNU General Public License for more details.
 * You should have received a copy of the GNU General Public License
 * along with this program.  If not, see <http://www.gnu.org/licenses/>.
 */

#include "FMDisplayMixer.h"
#include "SynthState.h"
#include "TftDisplay.h"
#include "TftAlgo.h"

// To access comp values
#include "preenfm3.h"


// Mixer first Y line and HEIGHT
#define Y_MIXER           80
#define HEIGHT_MIXER_LINE 28


const char* outDisplay[] = { "1", "1-2", "  2", "3", "3-4", "  4", "5", "5-6", "  6" };
const char* compDisplay[]= { "Off", "Slow", "Medium", "Fast"};
const char* enableNames[] = { "Off", "On" };
const char* levelMeterWhere[] = { "Off", "Mix", "All" };
const char* scalaMapNames[] = { "Keybrd", "Continu" };
const char* mpeOptions[] = { "No", "MPE48", "MPE36", "MPE24", "MPE12", "MPE0"};
const char *reverbPresets[] = {
    "XSmal1",
    "XSmal2",
    "XSmal3",
    "SmlDrk",
    "SmlWrm",
    "SmlBrt",
    "MedDrk",
    "MedWrm",
    "MedBrt",
    "LrgDrk",
    "LrgWrm",
    "LrgBrt",
    "XLgDrk",
    "XLgWrm",
    "XLgBrt",
    "Glue",
    "Hall",
    "Cave",
    "Aptmnt"
};
const char* reverbOutput[] = {"1-2", "3-4", "5-6" } ;
static const char* nullNames[] = { };

const char* midiWithNone [] = { "None", "1", "2", "3", "4", "5", "6", "7", "8", "9", "10", "11", "12", "13", "14", "15", "16"};
const char* midiWithAll [] = { "All", "1", "2", "3", "4", "5", "6", "7", "8", "9", "10", "11", "12", "13", "14", "15", "16"};

// ======================================== MIXER ================================


const struct Pfm3MixerButtonState volumeButtonState = {
      "Volume", MIXER_VALUE_VOLUME,
        {0, 4, 401, DISPLAY_TYPE_FLOAT, nullNames},
};

const struct Pfm3MixerButtonState panButtonState = {
      "Stereo pan", MIXER_VALUE_PAN,
      {-63, 63, 127, DISPLAY_TYPE_INT, nullNames }
};

const struct Pfm3MixerButtonState fxButtonState = {
      "Reverb dry/wet", MIXER_VALUE_SEND,
      {0, 1, 101, DISPLAY_TYPE_FLOAT, nullNames }
};

const struct Pfm3MixerButton volumeButton = {
  "Mix",
  3,
  { &volumeButtonState, &panButtonState, &fxButtonState }
};

const struct Pfm3MixerButtonState compButtonState = {
      "Compressor", MIXER_VALUE_COMPRESSOR,
        {0, 3, 4, DISPLAY_TYPE_STRINGS, compDisplay }
};


const struct Pfm3MixerButtonState outButtonState = {
      "Jack output", MIXER_VALUE_OUT,
        {0, 8, 9, DISPLAY_TYPE_STRINGS, outDisplay }
};


const struct Pfm3MixerButton outButton = {
  "Out",
  1,
  { &outButtonState  }
};

const struct Pfm3MixerButtonState voiceButtonState = {
      "Number of voices", MIXER_VALUE_NUMBER_OF_VOICES,
        {0, 16, 17, DISPLAY_TYPE_INT, nullNames}
};

const struct Pfm3MixerButton voiceButton = {
  "Voices",
  2,
  { &voiceButtonState, &compButtonState }
};





// ==

const struct Pfm3MixerButtonState midiButtonState = {
      "Channel", MIXER_VALUE_MIDI_CHANNEL,
        {0, 16, 17, DISPLAY_TYPE_STRINGS, midiWithAll }
};

const struct Pfm3MixerButtonState rangeStartButtonState = {
      "First Note", MIXER_VALUE_MIDI_FIRST_NOTE,
        {0, 127, 128, DISPLAY_TYPE_INT, nullNames }
};

const struct Pfm3MixerButtonState rangeEndButtonState = {
      "Last Note", MIXER_VALUE_MIDI_LAST_NOTE,
        {0, 127, 128, DISPLAY_TYPE_INT, nullNames }
};

const struct Pfm3MixerButtonState rangeShiftButtonState = {
      "Note Shift", MIXER_VALUE_MIDI_SHIFT_NOTE,
        {-63, 64, 128, DISPLAY_TYPE_INT, nullNames }
};




const struct Pfm3MixerButton midiButton = {
  "Midi",
  4,
  { &midiButtonState, &rangeStartButtonState, &rangeEndButtonState, &rangeShiftButtonState  }
};


const struct Pfm3MixerButtonState scalaEnable = {
      "Enable", MIXER_VALUE_SCALA_ENABLE,
        {0, 1, 2, DISPLAY_TYPE_STRINGS, enableNames }
};


const struct Pfm3MixerButtonState scalaMap = {
      "Mapping", MIXER_VALUE_SCALA_MAPPING,
        {0, SCALA_MAPPING_NUMBER_OF_OPTIONS - 1, SCALA_MAPPING_NUMBER_OF_OPTIONS, DISPLAY_TYPE_STRINGS, scalaMapNames }
};

const struct Pfm3MixerButtonState scalaScale = {
      "Scale", MIXER_VALUE_SCALA_SCALE,
        {0, NUMBEROFSCALASCALEFILES-1, NUMBEROFSCALASCALEFILES, DISPLAY_TYPE_SCALA_SCALE, nullNames }
};

const struct Pfm3MixerButton scalaButton = {
  "Scala",
  3,
  { &scalaEnable, &scalaMap, &scalaScale }
};

// ==


uint8_t numberOfGlobalSettings[5] = { 6, 4, 3, 0, 0 };
const struct Pfm3MixerButtonStateParam globalSettings[5][6] = {
    {
        { 0, 5, 6, DISPLAY_TYPE_STRINGS, mpeOptions },
        { 0, 16, 17, DISPLAY_TYPE_STRINGS, midiWithNone },
        { 0, 16, 17, DISPLAY_TYPE_STRINGS, midiWithNone },
        { 0, 1, 2, DISPLAY_TYPE_STRINGS, enableNames },
        { 420, 460, 401, DISPLAY_TYPE_FLOAT, nullNames },
        { 0, 2, 3, DISPLAY_TYPE_STRINGS, levelMeterWhere },
    },
    {
        { 0, 127, 128, DISPLAY_TYPE_INT, nullNames },
        { 0, 127, 128, DISPLAY_TYPE_INT, nullNames },
        { 0, 127, 128, DISPLAY_TYPE_INT, nullNames },
        { 0, 127, 128, DISPLAY_TYPE_INT, nullNames },
        { 0, 0, 0, DISPLAY_TYPE_FLOAT, nullNames },
        { 0, 0, 0, DISPLAY_TYPE_FLOAT, nullNames }
    },
    {
        { 0, 18, 19, DISPLAY_TYPE_STRINGS, reverbPresets },
        { 0, 1, 101, DISPLAY_TYPE_FLOAT,  nullNames},
        { 0, 2, 3, DISPLAY_TYPE_STRINGS, reverbOutput },
        { 0, 1, 101, DISPLAY_TYPE_FLOAT, nullNames },
        { 0, 1, 101, DISPLAY_TYPE_FLOAT, nullNames },
        { 0, 1, 101, DISPLAY_TYPE_FLOAT, nullNames },
    },
    {
        { 0, 1, 101, DISPLAY_TYPE_FLOAT, nullNames },
        { 0, 1, 101, DISPLAY_TYPE_FLOAT, nullNames },
        { 0, 1, 101, DISPLAY_TYPE_FLOAT, nullNames },
        { 0, 1, 101, DISPLAY_TYPE_FLOAT, nullNames },
        { 0, 1, 101, DISPLAY_TYPE_FLOAT, nullNames },
        { 0, 1, 101, DISPLAY_TYPE_FLOAT, nullNames },
    },
    {
        { 0, 1, 101, DISPLAY_TYPE_FLOAT, nullNames },
        { 0, 1, 101, DISPLAY_TYPE_FLOAT, nullNames },
        { 0, 1, 101, DISPLAY_TYPE_FLOAT, nullNames },
        { 0, 1, 101, DISPLAY_TYPE_FLOAT, nullNames },
        { 0, 1, 101, DISPLAY_TYPE_FLOAT, nullNames },
        { 0, 1, 101, DISPLAY_TYPE_FLOAT, nullNames },
    }
};


const struct Pfm3MixerButtonState globalSettingsDetect = {
      "Options",
      MIXER_VALUE_GLOBAL_SETTINGS_1,
};

const struct Pfm3MixerButtonState globalSettingsUserCC = {
      "User CC",
      MIXER_VALUE_GLOBAL_SETTINGS_2
};

const struct Pfm3MixerButtonState globalSettingsMasterFx = {
      "Reverb",
      MIXER_VALUE_GLOBAL_SETTINGS_3
};

const struct Pfm3MixerButtonState globalSettingsMasterFx2 = {
      "Reverb 2",
      MIXER_VALUE_GLOBAL_SETTINGS_4
};

const struct Pfm3MixerButtonState globalSettingsMasterFx3 = {
      "Reverb 3",
      MIXER_VALUE_GLOBAL_SETTINGS_5
};

struct Pfm3MixerButton globalButton = {
  "Global",
  5,
  { &globalSettingsDetect, &globalSettingsUserCC, &globalSettingsMasterFx, &globalSettingsMasterFx2 , &globalSettingsMasterFx3 }
};


const struct PfmMixerMenu mixerMenu = {
      { &volumeButton, &voiceButton, &outButton, &midiButton, &scalaButton, &globalButton }
};


/*
 * Class methods
 */

FMDisplayMixer::FMDisplayMixer() {
    for (int k = 0; k < NUMBER_OF_TIMBRES; k++) {
        valueChangedCounter_[k] = 0;
    }
}

void FMDisplayMixer::setReverbParamVisible(bool visible) {
    reverbParamVisible_ = visible;
    globalButton.numberOfStates = visible ? 5 : 3;
    numberOfGlobalSettings[2] = visible ? 6 : 3;
    numberOfGlobalSettings[3] = visible ? 6 : 0;
    numberOfGlobalSettings[4] = visible ? 4 : 0;
}

void* FMDisplayMixer::getValuePointer(int valueType, int encoder) {
    void *valueP = 0;
    switch (valueType) {
        case MIXER_VALUE_OUT:
            valueP = (void*) &synthState_->mixerState.instrumentState_[encoder].out;
            break;
        case MIXER_VALUE_COMPRESSOR:
            valueP = (void*) &synthState_->mixerState.instrumentState_[encoder].compressorType;
            break;
        case MIXER_VALUE_PAN:
            valueP = (void*) &synthState_->mixerState.instrumentState_[encoder].pan;
            break;
        case MIXER_VALUE_SEND:
            valueP = (void*) &synthState_->mixerState.instrumentState_[encoder].send;
            break;
        case MIXER_VALUE_VOLUME:
            valueP = (void*) &synthState_->mixerState.instrumentState_[encoder].volume;
            break;
        case MIXER_VALUE_NUMBER_OF_VOICES:
            valueP = (void*) &synthState_->mixerState.instrumentState_[encoder].numberOfVoices;
            break;
        case MIXER_VALUE_MIDI_CHANNEL:
            valueP = (void*) &synthState_->mixerState.instrumentState_[encoder].midiChannel;
            break;
        case MIXER_VALUE_MIDI_FIRST_NOTE:
            valueP = (void*) &synthState_->mixerState.instrumentState_[encoder].firstNote;
            break;
        case MIXER_VALUE_MIDI_LAST_NOTE:
            valueP = (void*) &synthState_->mixerState.instrumentState_[encoder].lastNote;
            break;
        case MIXER_VALUE_MIDI_SHIFT_NOTE:
            valueP = (void*) &synthState_->mixerState.instrumentState_[encoder].shiftNote;
            break;
        case MIXER_VALUE_SCALA_ENABLE:
            valueP = (void*) &synthState_->mixerState.instrumentState_[encoder].scalaEnable;
            break;
        case MIXER_VALUE_SCALA_MAPPING:
            valueP = (void*) &synthState_->mixerState.instrumentState_[encoder].scalaMapping;
            break;
        case MIXER_VALUE_SCALA_SCALE:
            valueP = (void*) &synthState_->mixerState.instrumentState_[encoder].scaleScaleNumber;
            break;
        case MIXER_VALUE_GLOBAL_SETTINGS_1:
            switch (encoder) {
                case 0:
                    valueP = (void*) &synthState_->mixerState.MPE_inst1_;
                    break;
                case 1:
                    valueP = (void*) &synthState_->mixerState.globalChannel_;
                    break;
                case 2:
                    valueP = (void*) &synthState_->mixerState.currentChannel_;
                    break;
                case 3:
                    valueP = (void*) &synthState_->mixerState.midiThru_;
                    break;
                case 4:
                    valueP = (void*) &synthState_->mixerState.tuning_;
                    break;
                case 5:
                    valueP = (void*) &synthState_->mixerState.levelMeterWhere_;
                    break;
                case 6:
                    break;
            }
            break;
        case MIXER_VALUE_GLOBAL_SETTINGS_2:
            switch (encoder) {
                case 0:
                case 1:
                case 2:
                case 3:
                    valueP = (void*) &synthState_->mixerState.userCC_[encoder];
                    break;
                case 4:
                case 5:
                    break;
            }
            break;
        case MIXER_VALUE_GLOBAL_SETTINGS_3:
            switch (encoder) {
                case 0:
                    valueP = (void*) &synthState_->mixerState.reverbPreset_;
                    break;
                case 1:
                    valueP = (void*) &synthState_->mixerState.reverbLevel_;
                    break;
                case 2:
                    valueP = (void*) &synthState_->mixerState.reverbOutput_;
                    break;
                case 3:
                     valueP = (void*) &synthState_->mixerState.fxBus_.masterfxConfig[GLOBALFX_PREDELAYTIME];
                     break;
                 case 4:
                     valueP = (void*) &synthState_->mixerState.fxBus_.masterfxConfig[GLOBALFX_PREDELAYMIX];
                     break;
                 case 5:
                     valueP = (void*) &synthState_->mixerState.fxBus_.masterfxConfig[GLOBALFX_NOTCHSPREAD];
                     break;
             }
             break;
         case MIXER_VALUE_GLOBAL_SETTINGS_4:
             switch (encoder) {
                 case 0:
                     valueP = (void*) &synthState_->mixerState.fxBus_.masterfxConfig[GLOBALFX_INPUTBASE];
                     break;
                 case 1:
                     valueP = (void*) &synthState_->mixerState.fxBus_.masterfxConfig[GLOBALFX_INPUTWIDTH];
                     break;
                 case 2:
                     valueP = (void*) &synthState_->mixerState.fxBus_.masterfxConfig[GLOBALFX_LOOPHP];
                     break;
                 case 3:
                     valueP = (void*) &synthState_->mixerState.fxBus_.masterfxConfig[GLOBALFX_LFODEPTH];
                     break;
                 case 4:
                     valueP = (void*) &synthState_->mixerState.fxBus_.masterfxConfig[GLOBALFX_LFOSPEED];
                     break;
                 case 5:
                     valueP = (void*) &synthState_->mixerState.fxBus_.masterfxConfig[GLOBALFX_DIFFUSION];
                     break;
             }
             break;
         case MIXER_VALUE_GLOBAL_SETTINGS_5:
             switch (encoder) {
                 case 0:
                     valueP = (void*) &synthState_->mixerState.fxBus_.masterfxConfig[GLOBALFX_NOTCHBASE];
                     break;
                 case 1:
                     valueP = (void*) &synthState_->mixerState.fxBus_.masterfxConfig[GLOBALFX_DAMPING];
                     break;
                 case 2:
                     valueP = (void*) &synthState_->mixerState.fxBus_.masterfxConfig[GLOBALFX_SIZE];
                     break;
                 case 3:
                     valueP = (void*) &synthState_->mixerState.fxBus_.masterfxConfig[GLOBALFX_DECAY];
                     break;
            }
            break;
    }
    return valueP;
}

void FMDisplayMixer::displayMixerValueInteger(int timbre, int x, int value) {
    tft_->setCursorInPixel(18 * TFT_BIG_CHAR_WIDTH, Y_MIXER + timbre * HEIGHT_MIXER_LINE);
    if (value >= 0 && value < 100 && timbre < 18) {
        tft_->print(' ');
    }
    if (value > -10 && value < 10) {
        tft_->print(' ');
    }
    tft_->print(value);
}

void FMDisplayMixer::displayMixerValue(int timbre) {
    tft_->setCharBackgroundColor(COLOR_BLACK);

    const Pfm3MixerButton *currentButton = mixerMenu.mixerButton[synthState_->fullState.mixerCurrentEdit];
    bool isGlobalSettings = currentButton->state[0]->mixerValueType == MIXER_VALUE_GLOBAL_SETTINGS_1;

    const Pfm3MixerButtonStateParam *buttonStateParam;
    void *valueP;
    uint8_t mixerValueType;

    if (!isGlobalSettings) {
        int buttonState = synthState_->fullState.buttonState[BUTTONID_MIXER_FIRST_BUTTON + synthState_->fullState.mixerCurrentEdit];
        buttonStateParam = &currentButton->state[buttonState]->buttonState;
        mixerValueType = currentButton->state[buttonState]->mixerValueType;

        // Instrument 1 / MIDI MPE special case
        if (unlikely(synthState_->mixerState.MPE_inst1_ > 0 && timbre == 0 && mixerValueType == MIXER_VALUE_MIDI_CHANNEL)) {
            int numberOfVoice = 1 + synthState_->mixerState.instrumentState_[0].numberOfVoices;
            tft_->setCursorInPixel(238 - (numberOfVoice >= 10 ? 4 : 3)  * 11 , Y_MIXER);

            // RED if not poly play mode
            if (synthState_->getTimbrePlayMode(timbre) == 1) {
                tft_->setCharColor(COLOR_GRAY);
            } else {
                tft_->setCharColor(COLOR_RED);
            }
            tft_->print("1-");
            tft_->print(numberOfVoice > 16 ? 16 : numberOfVoice);
            return;
        }
    } else {
        int globalSettingPage = synthState_->fullState.buttonState[BUTTONID_MIXER_GLOBAL];
        if (timbre >= numberOfGlobalSettings[globalSettingPage]) {
            return;
        }
        mixerValueType = currentButton->state[globalSettingPage]->mixerValueType;
        buttonStateParam = &globalSettings[globalSettingPage][timbre];
    }
    valueP = getValuePointer(mixerValueType, timbre);

    // Scale particular case
    if (!synthState_->mixerState.instrumentState_[timbre].scalaEnable
        && (mixerValueType == MIXER_VALUE_SCALA_MAPPING || mixerValueType == MIXER_VALUE_SCALA_SCALE)) {
        tft_->setCharColor(COLOR_GRAY);
        tft_->setCursorInPixel(18 * TFT_BIG_CHAR_WIDTH, Y_MIXER + timbre * HEIGHT_MIXER_LINE);
        tft_->print("N/A");
        return;
    }

    switch (buttonStateParam->displayType) {
        case DISPLAY_TYPE_SCALA_SCALE: {
            // displayMixerValueInteger(timbre, 18, (*((uint8_t*)valueP)));
            const char *scalaName = synthState_->getStorage()->getScalaFile()->getFile((*((uint8_t*) valueP)))->name;
            // memorize scala name
            // memcpy(synthState->mixerState.instrumentState[timbre].scalaScale, scalaName, 12); ??
            int dotIndex = 0;
            for (dotIndex = 0; dotIndex < 7 && scalaName[dotIndex] != '.'; dotIndex++);
            tft_->fillArea(160, Y_MIXER + timbre * HEIGHT_MIXER_LINE, 235-160, 20, COLOR_BLACK);
            tft_->setCursorInPixel(238 - dotIndex * TFT_SMALL_CHAR_WIDTH, Y_MIXER + timbre * HEIGHT_MIXER_LINE + 4);
            tft_->printSmallChars(scalaName, dotIndex);
            break;
        }
        case DISPLAY_TYPE_INT:

            if (unlikely(mixerValueType == MIXER_VALUE_PAN)) {
                // Stereo is 1,4,7
                int out = synthState_->mixerState.instrumentState_[timbre].out;
                out--;
                if ((out % 3) != 0) {
                    // Mono, no panning
                    tft_->setCharColor(COLOR_GRAY);
                    tft_->setCursorInPixel(20 * TFT_BIG_CHAR_WIDTH, Y_MIXER + timbre * HEIGHT_MIXER_LINE);
                    tft_->print('-');
                    return;
                }
            } else if (unlikely(mixerValueType == MIXER_VALUE_NUMBER_OF_VOICES)) {
                uint8_t numberOfVoice = *((int8_t*) valueP);
                uint8_t polyMono = synthState_->getTimbrePlayMode(timbre);
                if (numberOfVoice == 0) {
                    tft_->setCharColor(COLOR_DARK_GRAY);
                } else if (numberOfVoice == 1) {
                    if (polyMono == 2.0f) {
                        tft_->setCharColor(COLOR_RED);
                    }
                } else {
                    // More than 1 voice and mono mode
                    if (polyMono == 0.0f) {
                        tft_->setCharColor(COLOR_RED);
                    }
                }
            }

            displayMixerValueInteger(timbre, 18, (*((int8_t*) valueP)));
            break;
        case DISPLAY_TYPE_STRINGS: {
            const char *label = buttonStateParam->valueName[(int) (*((uint8_t*) valueP))];
            int len = getLength(label);
            tft_->fillArea(160, Y_MIXER + timbre * HEIGHT_MIXER_LINE, 235-160, 20, COLOR_BLACK);
            tft_->setCursorInPixel(238 - len * 11 , Y_MIXER + timbre * HEIGHT_MIXER_LINE);
            tft_->print(label, 7);
            break;
        }
        case DISPLAY_TYPE_FLOAT: {
            float toDisplay = *((float*) valueP);
            tft_->setCursorInPixel((toDisplay >= 100.0f ? 15 : 16) * TFT_BIG_CHAR_WIDTH, Y_MIXER + timbre * HEIGHT_MIXER_LINE);
            tft_->print(toDisplay);
            break;
        }
        default:
            break;
    }

}

void FMDisplayMixer::refreshMixerByStep(int currentTimbre, int &refreshStatus, int &endRefreshStatus) {
    const Pfm3MixerButton *currentButton = mixerMenu.mixerButton[synthState_->fullState.mixerCurrentEdit];
    bool isGlobalSettings = currentButton->state[0]->mixerValueType == MIXER_VALUE_GLOBAL_SETTINGS_1;

    switch (refreshStatus) {
        case 20:
            tft_->pauseRefresh();
            tft_->clear();
            tft_->fillArea(0, 0, 240, 21, COLOR_DARK_GREEN);
            tft_->setCursorInPixel(2, 2);
            tft_->print("MIX ", COLOR_YELLOW, COLOR_DARK_GREEN);
            tft_->print(synthState_->mixerState.mixName_, COLOR_WHITE, COLOR_DARK_GREEN);
            break;
        case 19:
        case 18:
        case 17:
        case 16:
        case 15:
        case 14: {
            int timbre = 19 - refreshStatus;
            // Display row : timbre number + preset name
            tft_->setCharBackgroundColor(COLOR_BLACK);
            tft_->setCursorInPixel(2, Y_MIXER + (timbre) * HEIGHT_MIXER_LINE);
            if (currentTimbre != (timbre)) {
                if (synthState_->mixerState.instrumentState_[timbre].numberOfVoices == 0) {
                    tft_->setCharColor(COLOR_DARK_GRAY);
                } else {
                    tft_->setCharColor(COLOR_LIGHT_GRAY);
                }
            } else {
                if (synthState_->mixerState.instrumentState_[timbre].numberOfVoices == 0) {
                    tft_->setCharColor(COLOR_DARK_YELLOW);
                } else {
                    tft_->setCharColor(COLOR_YELLOW);
                }
            }
            tft_->print(20 - refreshStatus);

            tft_->setCursorInPixel(22, Y_MIXER + (timbre) * HEIGHT_MIXER_LINE);
            if (!isGlobalSettings) {
                if (unlikely(timbre == 0 && synthState_->mixerState.MPE_inst1_ > 0)) {
                    // If MPE instrument 1, limit chars to 10
                    tft_->print(synthState_->getTimbreName(timbre), 10);
                    tft_->setCursoraddXY(4, 4);
                    tft_->setCharColor(COLOR_LIGHT_GRAY);
                    tft_->printSmallChars("MPE");
                } else {
                    tft_->print(synthState_->getTimbreName(timbre));
                }
            } else {
                int globalSettingPage = synthState_->fullState.buttonState[BUTTONID_MIXER_GLOBAL];

                if (timbre < numberOfGlobalSettings[globalSettingPage]) {
                    refreshMixerRowGlobalOptions(globalSettingPage, timbre);
                }
            }
            break;
        }
        case 12:
        case 11:
        case 10:
        case 9:
        case 8:
        case 7: {
            tft_->setCharColor(COLOR_WHITE);
            displayMixerValue(12 - refreshStatus);
            break;
        }
        case 6: {
            uint8_t buttonState = synthState_->fullState.buttonState[BUTTONID_MIXER_FIRST_BUTTON + synthState_->fullState.mixerCurrentEdit];
            const char *valueTitle = mixerMenu.mixerButton[synthState_->fullState.mixerCurrentEdit]->state[buttonState]->stateLabel;
            int len = getLength(valueTitle);
            tft_->setCursorInPixel(240 - len * TFT_BIG_CHAR_WIDTH, 50);
            tft_->setCharBackgroundColor(COLOR_BLACK);
            tft_->setCharColor(COLOR_GREEN);
            tft_->print(valueTitle);
            // NO BREAK ....
        }
        case 5:
        case 4:
        case 3:
        case 2:
        case 1: {
            uint8_t button = 6 - refreshStatus;

            const Pfm3MixerButton *currentButton = mixerMenu.mixerButton[button];

            tft_->drawButton(currentButton->buttonLabel, 270, 29, button, currentButton->numberOfStates,
                synthState_->fullState.mixerCurrentEdit == button ? synthState_->fullState.buttonState[BUTTONID_MIXER_FIRST_BUTTON + button] + 1 : 0,
                COLOR_DARK_GREEN);

            break;
        }
    }

    if (refreshStatus == endRefreshStatus) {
        endRefreshStatus = 0;
        refreshStatus = 0;
    }
}

void FMDisplayMixer::refreshMixerRowGlobalOptions(int page, int row) {
    tft_->setCharColor(COLOR_LIGHT_GRAY);

    switch (page) {
        case 0:
        switch (row) {
            case 0:
                tft_->print("MPE Inst1");
                break;
            case 1:
                tft_->print("Global midi");
                break;
            case 2:
                tft_->print("Current midi");
                break;
            case 3:
                tft_->print("Midi thru");
                break;
            case 4:
                tft_->print("Tuning");
                break;
            case 5:
                tft_->print("Level meter");
                break;
            case 6:
                break;
        }
        break;
        case 1:
            switch (row) {
                case 0:
                    tft_->print("User CC 1");
                    break;
                case 1:
                    tft_->print("User CC 2");
                    break;
                case 2:
                    tft_->print("User CC 3");
                    break;
                case 3:
                    tft_->print("User CC 4");
                    break;
                case 4:
                case 5:
                    break;
            }
            break;
        case 2:
            switch (row) {
                case 0:
                    tft_->print("Preset");
                    break;
                case 1:
                    tft_->print("Volume");
                    break;
                case 2:
                    tft_->print("Output");
                    break;
                case 3:
                    tft_->print("Pre delay");
                    break;
                case 4:
                    tft_->print("Pre delay Mix");
                    break;
                case 5:
                    tft_->print("Notch Spread");
                    break;
            }
            break;
        case 3:
            switch (row) {
                case 0:
                    tft_->print("Filter base");
                    break;
                case 1:
                    tft_->print("Filter width");
                    break;
                case 2:
                    tft_->print("Tank hp");
                    break;
                case 3:
                    tft_->print("Mod Depth");
                    break;
                case 4:
                    tft_->print("Mod Speed");
                    break;
                case 5:
                    tft_->print("Diffusion");
                    break;
            }
            break;
        case 4:
            switch (row) {
                case 0:
                    tft_->print("Notch Base");
                    break;
                case 1:
                    tft_->print("Damping");
                    break;
                case 2:
                    tft_->print("Size");
                    break;
                case 3:
                    tft_->print("Decay");
                    break;
            }
            break;
    }
}





void FMDisplayMixer::newMixerValue(uint8_t mixerValue, uint8_t timbre, float oldValue, float newValue, int &refreshStatus) {
    tft_->setCharBackgroundColor(COLOR_BLACK);
    if (oldValue != newValue) {
        tft_->setCharColor(COLOR_YELLOW);
    } else {
        tft_->setCharColor(COLOR_RED);
    }
    displayMixerValue(timbre);
    valueChangedCounter_[timbre] = 4;

    // Did we change the Reverb Preset
    if (reverbParamVisible_) {
        const Pfm3MixerButton *currentButton = mixerMenu.mixerButton[synthState_->fullState.mixerCurrentEdit];
        int buttonState = synthState_->fullState.buttonState[BUTTONID_MIXER_FIRST_BUTTON + synthState_->fullState.mixerCurrentEdit];
        if (currentButton->state[buttonState]->mixerValueType == MIXER_VALUE_GLOBAL_SETTINGS_3 && timbre == 0) {
            refreshStatus = 9;
        }
    }

}

void FMDisplayMixer::newMixerValueFromExternal(uint8_t valueType, uint8_t timbre, float oldValue, float newValue) {
    const Pfm3MixerButton *currentButton = mixerMenu.mixerButton[synthState_->fullState.mixerCurrentEdit];
    int buttonState = synthState_->fullState.buttonState[BUTTONID_MIXER_FIRST_BUTTON + synthState_->fullState.mixerCurrentEdit];

    if (currentButton->state[buttonState]->mixerValueType == valueType) {
        int dummyRefreshState;
        newMixerValue(valueType, timbre, oldValue, newValue, dummyRefreshState);
    }
}

void FMDisplayMixer::tempoClick() {
    static float lastVolume[NUMBER_OF_TIMBRES];
    static float lastGainReduction[NUMBER_OF_TIMBRES];

    for (int timbre = 0; timbre < NUMBER_OF_TIMBRES; timbre++) {
        if (valueChangedCounter_[timbre] > 0) {
            valueChangedCounter_[timbre]--;
            if (valueChangedCounter_[timbre] == 0) {
                tft_->setCharBackgroundColor(COLOR_BLACK);
                tft_->setCharColor(COLOR_WHITE);
                displayMixerValue(timbre);
            }
        }
    }

    if (synthState_->mixerState.levelMeterWhere_ >= 1) {
        for (int timbre = 0; timbre < NUMBER_OF_TIMBRES; timbre++) {
            if (synthState_->mixerState.instrumentState_[timbre].numberOfVoices > 0) {
                float volume = getCompInstrumentVolume(timbre);
                float gr = getCompInstrumentGainReduction(timbre);
                // gr tend to slower reach 0
                // Let'as accelerate when we don't want to draw the metter anymore
                if (gr > -.1f) {
                    gr = 0;
                }
                if ((volume != lastVolume[timbre] || gr != lastGainReduction[timbre])) {

                    lastVolume[timbre] = volume;
                    lastGainReduction[timbre] = gr;

                    bool isCompressed = synthState_->mixerState.instrumentState_[timbre].compressorType > 0;
                    tft_->drawLevelMetter(22, Y_MIXER + timbre * HEIGHT_MIXER_LINE + 21,
                        218, 3, 5, volume, isCompressed, gr);
                }
            }
        }
    }
}

void FMDisplayMixer::encoderTurned(int encoder, int ticks) {

    const Pfm3MixerButton *currentButton = mixerMenu.mixerButton[synthState_->fullState.mixerCurrentEdit];
    bool isGlobalSettings = currentButton->state[0]->mixerValueType == MIXER_VALUE_GLOBAL_SETTINGS_1;
    bool isScalaButton = currentButton->state[0]->mixerValueType == MIXER_VALUE_SCALA_ENABLE;

    const Pfm3MixerButtonStateParam *buttonStateParam;
    void *valueP;
    uint8_t mixerValueType;

    if (!isGlobalSettings) {
        int buttonState = synthState_->fullState.buttonState[BUTTONID_MIXER_FIRST_BUTTON + synthState_->fullState.mixerCurrentEdit];
        buttonStateParam = &currentButton->state[buttonState]->buttonState;
        mixerValueType = currentButton->state[buttonState]->mixerValueType;

        // Instrument 1 / MIDI MPE special case
        if (unlikely(synthState_->mixerState.MPE_inst1_ > 0 && encoder == 0 && mixerValueType == MIXER_VALUE_MIDI_CHANNEL)) {
            return;
        }
    } else {
        int globalSettingPage = synthState_->fullState.buttonState[BUTTONID_MIXER_GLOBAL];
        if (encoder >= numberOfGlobalSettings[globalSettingPage]) {
            return;
        }
        mixerValueType = currentButton->state[globalSettingPage]->mixerValueType;
        buttonStateParam = &globalSettings[globalSettingPage][encoder];
    }
    valueP = getValuePointer(mixerValueType, encoder);

    switch (buttonStateParam->displayType) {
        case DISPLAY_TYPE_INT:
        case DISPLAY_TYPE_STRINGS:
        case DISPLAY_TYPE_SCALA_SCALE: {
            int8_t oldValue = *((int8_t*) valueP);
            int newValue = oldValue + ticks;

            float maxValue;
            if (mixerValueType == MIXER_VALUE_NUMBER_OF_VOICES) {
                maxValue = MAX_NUMBER_OF_VOICES;
                for (int t = 0; t < NUMBER_OF_TIMBRES; t++) {
                    if (t != encoder) {
                        maxValue -= synthState_->mixerState.instrumentState_[t].numberOfVoices;
                    }
                }
            } else {
                maxValue = buttonStateParam->maxValue;
            }

            if (unlikely(newValue > maxValue)) {
                newValue = maxValue;
            } else if (unlikely(newValue < buttonStateParam->minValue)) {
                newValue = buttonStateParam->minValue;
            }

            if (oldValue != newValue) {
                if (isScalaButton) {
                    *((uint8_t*) valueP) = (uint8_t) newValue;
                    if (!synthState_->scalaSettingsChanged(encoder)) {
                        *((uint8_t*) valueP) = (uint8_t) oldValue;
                        newValue = oldValue;
                    }
                } else {
                    *((int8_t*) valueP) = (int8_t) newValue;
                }

                // If we arrive to 0 voice or leave 0 voice, let's redraw the timbre names
                if (unlikely(mixerValueType == MIXER_VALUE_NUMBER_OF_VOICES)) {
                    if (oldValue == 0.0f || newValue == 0.0f) {
                        refresh(19, 14);
                    }
                }

            }
            synthState_->propagateNewMixerValue(mixerValueType, encoder, oldValue, newValue);

            break;
        }
        case DISPLAY_TYPE_FLOAT: {
            float oldValue = *((float*) valueP);
            float inc = (buttonStateParam->maxValue - buttonStateParam->minValue) / (buttonStateParam->numberOfValues - 1);
            float newValue = oldValue + ticks * inc;

            // Round to next hundredth
            int newValueInt =  newValue * 1000 + 3;
            newValueInt /= 10;
            newValue = (float)newValueInt / 100.0f;

            if (unlikely(newValue > buttonStateParam->maxValue)) {
                newValue = buttonStateParam->maxValue;
            } else if (unlikely(newValue < buttonStateParam->minValue)) {
                newValue = buttonStateParam->minValue;
            }

            if (oldValue != newValue) {
                *((float*) valueP) = (float) newValue;
            }
            synthState_->propagateNewMixerValue(mixerValueType, encoder, oldValue, newValue);
            break;
        }
        default:
            break;
    }
}


/**
 * Mixer volume : ENCODER + MENU => modify volumes of all instruments on same DAC
 */
void FMDisplayMixer::encoderTurnedWhileButtonPressed(int encoder6, int ticks, int button) {

    switch (button) {
    case BUTTON_PFM3_MENU: {
        const Pfm3MixerButton *currentButton = mixerMenu.mixerButton[synthState_->fullState.mixerCurrentEdit];
        if (currentButton->state[0]->mixerValueType == MIXER_VALUE_VOLUME) {
            if (synthState_->fullState.buttonState[BUTTONID_MIXER_MIX] == 0) {
                // We're modifying volume
                // We verify output/3 because each DAC can have 3 values (DAC 1 : 1, 1-2, 2)
                int output = synthState_->mixerState.instrumentState_[encoder6].out / 3;
                for (int i = 0; i < NUMBER_OF_TIMBRES; i++) {
                    if ((synthState_->mixerState.instrumentState_[i].out / 3) == output) {
                        this->encoderTurned(i, ticks);
                    }
                }

            }
        }
    }
    }
}


void FMDisplayMixer::buttonPressed(int button) {
    struct FullState *fullState = &synthState_->fullState;

    if (button >= BUTTON_PFM3_1 && button <= BUTTON_PFM3_6) {
        if (fullState->mixerCurrentEdit != button) {
            synthState_->propagateNewMixerEdit(fullState->mixerCurrentEdit, button);
            fullState->mixerCurrentEdit = button;
        } else {
            int numberOfStates = mixerMenu.mixerButton[synthState_->fullState.mixerCurrentEdit]->numberOfStates;

            if (numberOfStates > 1) {
                fullState->buttonState[BUTTONID_MIXER_FIRST_BUTTON + button]++;
                if (fullState->buttonState[BUTTONID_MIXER_FIRST_BUTTON + button] >= numberOfStates) {
                    fullState->buttonState[BUTTONID_MIXER_FIRST_BUTTON + button] = 0;
                }
                synthState_->propagateNewMixerEdit(button, button);
            }
        }
    }
}
