Ixox/preenfm3/firmware/Src/hardware/FMDisplayEditor.cpp

/*
 * Copyright 2020 Xavier Hosxe
 *
 * Author: Xavier Hosxe (xavier <dot> hosxe (at) g m a i l <dot> com)
 *
 * This program is free software: you can redistribute it and/or modify
 * it under the terms of the GNU General Public License as published by
 * the Free Software Foundation, either version 3 of the License, or
 * (at your option) any later version.
 * This program is distributed in the hope that it will be useful,
 * but WITHOUT ANY WARRANTY; without even the implied warranty of
 * MERCHANTABILITY or FITNESS FOR A PARTICULAR PURPOSE.  See the
 * GNU General Public License for more details.
 * You should have received a copy of the GNU General Public License
 * along with this program.  If not, see <http://www.gnu.org/licenses/>.
 */


#include <FirmwareTftDisplay.h>
#include "FMDisplayEditor.h"
#include "FMDisplay.h"
#include "SynthState.h"
#include "preenfm3.h"

extern bool carrierOperator[28][6];

static const char *nullNames[] = { };
static const unsigned char *nullNamesOrder = 0;

const char *algoNames[] = {
    "alg1",
    "alg2",
    "alg3",
    "alg4",
    "alg5",
    "alg6",
    "alg7",
    "alg8",
    "alg9",
    "al10",
    "al11",
    "al12",
    "al13",
    "al14",
    "al15",
    "al16",
    "al17",
    "al18",
    "al19",
    "al20",
    "al21",
    "al22",
    "al23",
    "al24",
    "al25",
    "al26",
    "al27",
    "al28",
    "al29",
    "al30",
    "al31",
    "al32"
     };

const char *polyMonoNames[] = {
    "Mono",
    "Poly",
    "Unis"};


struct ParameterRowDisplay engine1ParameterRow = {
    "Engine",
    {
        "Algo",
        "Velo",
        "Mode",
        "Speed" },
    {
        {
            ALGO1,
            ALGO_END - 1,
            ALGO_END,
            DISPLAY_TYPE_STRINGS,
            algoNames,
            nullNamesOrder,
            nullNamesOrder },
        {
            0,
            16,
            17,
            DISPLAY_TYPE_INT,
            nullNames,
            nullNamesOrder,
            nullNamesOrder },
        {
            0,
            2,
            3,
            DISPLAY_TYPE_STRINGS,
            polyMonoNames,
            nullNamesOrder,
            nullNamesOrder },
        {
            0,
            12,
            13,
            DISPLAY_TYPE_INT,
            nullNames,
            nullNamesOrder,
            nullNamesOrder } } };

const char *glideTypeNames[] = {
    "Off    ",
    "Overlap",
    "Always ",
};

struct ParameterRowDisplay engine2ParameterRow = {
    "NewPfm3",
    {
        "Glide",
        "Spread",
        "Detune",
        "" },
    {
        {
            0,
            2,
            3,
            DISPLAY_TYPE_STRINGS,
            glideTypeNames,
            nullNamesOrder,
            nullNamesOrder },
        {
            0,
            1,
            101,
            DISPLAY_TYPE_FLOAT,
            nullNames,
            nullNamesOrder,
            nullNamesOrder },
        {
            -1,
            1,
            201,
            DISPLAY_TYPE_FLOAT,
            nullNames,
            nullNamesOrder,
            nullNamesOrder },
        {
            0,
            1,
            101,
            DISPLAY_TYPE_FLOAT,
            nullNames,
            nullNamesOrder,
            nullNamesOrder } } };


const char *syncNames[] = {
    "Int",
    "Ext"
};


struct ParameterRowDisplay lfoSyncParameterRow = {
    "",
    {
        "Sync",
        "",
        "",
        "" },
    {
        {
            0,
            1,
            2,
            DISPLAY_TYPE_STRINGS,
            syncNames,
            nullNamesOrder,
            nullNamesOrder },
        {
            0,
            1,
            101,
            DISPLAY_TYPE_FLOAT,
            nullNames,
            nullNamesOrder,
            nullNamesOrder },
        {
            0,
            1,
            101,
            DISPLAY_TYPE_FLOAT,
            nullNames,
            nullNamesOrder,
            nullNamesOrder },
        {
            0,
            1,
            101,
            DISPLAY_TYPE_FLOAT,
            nullNames,
            nullNamesOrder,
            nullNamesOrder } } };





const char *clockName[] = {
    "Off ",
    "Int ",
    "Ext " };
const char *dirName[] = {
    "Up  ",
    "Down",
    "U&D ",
    "Play",
    "Rand",
    "Chrd",
    "RtUp",
    "RtDn",
    "RtUD",
    "ShUp",
    "ShDn",
    "ShUD" };

struct ParameterRowDisplay engineArp1ParameterRow = {
    "Arpeggiator",
    {
        "Clock ",
        "BPM ",
        "Dire",
        "Octav" },
    {
        {
            0,
            2,
            3,
            DISPLAY_TYPE_STRINGS,
            clockName,
            nullNamesOrder,
            nullNamesOrder },
        {
            10,
            240,
            231,
            DISPLAY_TYPE_INT,
            nullNames,
            nullNamesOrder,
            nullNamesOrder },
        {
            0,
            11,
            12,
            DISPLAY_TYPE_STRINGS,
            dirName,
            nullNamesOrder,
            nullNamesOrder },
        {
            1,
            3,
            3,
            DISPLAY_TYPE_INT,
            nullNames,
            nullNamesOrder,
            nullNamesOrder } } };

//   192, 144, 96, 72, 64, 48, 36, 32, 24, 16, 12, 8, 6, 4, 3, 2, 1

const char *divNames[] = {
    "2/1 ",
    "3/2 ",
    "1/1 ",
    "3/4 ",
    "2/3 ",
    "1/2 ",
    "3/8 ",
    "1/3 ",
    "1/4 ",
    "1/6 ",
    "1/8 ",
    "1/12",
    "1/16",
    "1/24",
    "1/32",
    "1/48",
    "1/96" };
const char *activeName[] = {
    "Off ",
    "On  " };

const char *patternName[] = {
    "1   ",
    "2   ",
    "3   ",
    "4   ",
    "5   ",
    "6   ",
    "7   ",
    "8   ",
    "9   ",
    "10   ",
    "11  ",
    "12  ",
    "13  ",
    "14  ",
    "15  ",
    "16  ",
    "17  ",
    "18  ",
    "19  ",
    "20   ",
    "21  ",
    "22  ",
    "Usr1",
    "Usr2",
    "Usr3",
    "Usr4" };

struct ParameterRowDisplay engineArp2ParameterRow = {
    "Arpeggiator",
    {
        "Ptrn",
        "Divi",
        "Dura",
        "Latc" },
    {
        {
            0,
            ARPEGGIATOR_PATTERN_COUNT - 1,
            ARPEGGIATOR_PATTERN_COUNT,
            DISPLAY_TYPE_STRINGS,
            patternName,
            nullNamesOrder,
            nullNamesOrder },
        {
            0,
            16,
            17,
            DISPLAY_TYPE_STRINGS,
            divNames,
            nullNamesOrder,
            nullNamesOrder },
        {
            0,
            16,
            17,
            DISPLAY_TYPE_STRINGS,
            divNames,
            nullNamesOrder,
            nullNamesOrder },
        {
            0,
            1,
            2,
            DISPLAY_TYPE_STRINGS,
            activeName,
            nullNamesOrder,
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
        {
            -1,
            1,
            201,
            DISPLAY_TYPE_FLOAT,
            nullNames,
            nullNamesOrder,
            nullNamesOrder } } };

const char *envCurveNames[] = { "Exp ", "Lin ", "Log ", "Usr1", "Usr2", "Usr3",
        "Usr4" };

struct ParameterRowDisplay engineCurveParameterRow = {
    "Curve",
    {
        "Attk",
        "Dec ",
        "Sust",
        "Rel " },
    {
        {
            CURVE_TYPE_EXP,
            CURVE_TYPE_MAX - 1,
            CURVE_TYPE_MAX,
            DISPLAY_TYPE_STRINGS,
			envCurveNames,
            nullNamesOrder,
            nullNamesOrder },
        {
            CURVE_TYPE_EXP,
            CURVE_TYPE_MAX - 1,
            CURVE_TYPE_MAX,
            DISPLAY_TYPE_STRINGS,
			envCurveNames,
            nullNamesOrder,
            nullNamesOrder },
        {
            CURVE_TYPE_EXP,
            CURVE_TYPE_MAX - 1,
            CURVE_TYPE_MAX,
            DISPLAY_TYPE_STRINGS,
			envCurveNames,
            nullNamesOrder,
            nullNamesOrder },
        {
            CURVE_TYPE_EXP,
            CURVE_TYPE_MAX - 1,
            CURVE_TYPE_MAX,
            DISPLAY_TYPE_STRINGS,
			envCurveNames,
            nullNamesOrder,
            nullNamesOrder }
    } };


/* FILTER ORDER

 0   Off , -0-
 1   Mix , -1-
 2   LP  , -2-
 3   HP  , -3-
 4   Bass, -4-
 5   BP  , -5-
 6   Crsh, -6-
 7   Oryx, -38-
 8   Orx2, -39-
 9   Orx3, -40-
 10  h3o+, -46-
 11  Svh3, -47-
 12  Pann, -22-
 13  LP2 , -7-
 14  HP2 , -8-
 15  Lp3 , -10-
 16  Hp3 , -11-
 17  Bp3 , -12-
 18  Peak, -13-
 19  Notc, -14-
 20  Bell, -15-
 21  LowS, -16-
 22  HigS, -17-
 23  LpHp, -18-
 24  BpDs, -19-
 25  LPws, -20-
 26  Tilt, -21-
 27  Sat , -23-
 28  Sigm, -24-
 29  Fold, -25-
 30  Wrap, -26-
 31  LpSn, -32-
 32  HpSn, -33-
 33  Not4, -34-
 34  Ap4 , -35-
 35  Ap4b, -36-
 36  Ap4D, -37-
 37  18db, -41-
 38  La+d, -42-
 39  BP2 , -9-
 40  Lad+, -43-
 41  Diod, -44-
 42  L+d+, -45-
 43  Xor , -27-
 44  Txr1, -28-
 45  Txr2, -29-
 46  LPx1, -30-
 47  LPx2, -31-
 48  Alkx, -48-
 49  Flng, -49-
 50  Chor, -50-
 51  Dim , -51-
 52  Dblr, -52-
 53  Harm, -53-
 54  Bode, -54-
 55  Wide, -55-
 56  DelC, -56-
 57  Ping, -57-
 58  Diff, -58-
 */

const unsigned char filtersOrder[] = { 0, 1, 2, 3, 4, 5, 6, 38, 39, 40, 46, 47,
        22, 7, 8, 10, 11, 12, 13, 14, 15, 16, 17, 18, 19, 20, 21, 23, 24, 25,
        26, 32, 33, 34, 35, 36, 37, 41, 42, 9, 43, 44, 45, 27, 28, 29, 30, 31,
        48, 49, 50, 51, 52, 53, 54, 55, 56, 57, 58 };

const unsigned char filtersPosition[] = { 0, 1, 2, 3, 4, 5, 6, 13, 14, 39, 15,
        16, 17, 18, 19, 20, 21, 22, 23, 24, 25, 26, 12, 27, 28, 29, 30, 43, 44,
        45, 46, 47, 31, 32, 33, 34, 35, 36, 7, 8, 9, 37, 38, 40, 41, 42, 10, 11,
        48, 49,  50, 51, 52, 53, 54, 55, 56, 57, 58 };

const char *fxName[] = {
    "Off ", /*  0   */
    "Mix ", /*  1   */
    "LP  ", /*  2   */
    "HP  ", /*  3   */
    "Bass", /*  4   */
    "BP  ", /*  5   */
    "Crsh", /*  6   */
    "LP2 ", /*  7   */
    "HP2 ", /*  8   */
    "BP2 ", /*  9   */
    "Lp3 ", /*  10  */
    "Hp3 ", /*  11  */
    "Bp3 ", /*  12  */
    "Peak", /*  13  */
    "Notc", /*  14  */
    "Bell", /*  15  */
    "LowS", /*  16  */
    "HigS", /*  17  */
    "LpHp", /*  18  */
    "BpDs", /*  19  */
    "LPws", /*  20  */
    "Tilt", /*  21  */
    "Pann", /*  22  */
    "Sat ", /*  23  */
    "Sigm", /*  24  */
    "Fold", /*  25  */
    "Wrap", /*  26  */
    "Xor ", /*  27  */
    "Txr1", /*  28  */
    "Txr2", /*  29  */
    "LPx1", /*  30  */
    "LPx2", /*  31  */
    "LpSn", /*  32  */
    "HpSn", /*  33  */
    "Not4", /*  34  */
    "Ap4 ", /*  35  */
    "Ap4b", /*  36  */
    "Ap4D", /*  37  */
    "Oryx", /*  38  */
    "Orx2", /*  39  */
    "Orx3", /*  40  */
    "18db", /*  41  */
    "La+d", /*  42  */
    "Lad+", /*  43  */
    "Diod", /*  44  */
    "L+d+", /*  45  */
    "h3o+", /*  46  */
    "Svh3", /*  47  */
    "Alkx", /*  48  */
};



struct ParameterRowDisplay fx1ParameterRow = {
    "FX1",
    {
        "Type",
        "    ",
        "    ",
        "Gain" },
    {
        {
            0,
            FILTER_LAST - 1,
            FILTER_LAST,
            DISPLAY_TYPE_STRINGS,
            fxName,
            filtersOrder,
            filtersPosition },
        {
            0,
            1,
            101,
            DISPLAY_TYPE_FLOAT,
            nullNames,
            nullNamesOrder,
            nullNamesOrder },
        {
            0,
            1,
            101,
            DISPLAY_TYPE_FLOAT,
            nullNames,
            nullNamesOrder,
            nullNamesOrder },
        {
            0,
            2,
            201,
            DISPLAY_TYPE_FLOAT,
            nullNames,
            nullNamesOrder,
            nullNamesOrder } } };

struct FilterRowDisplay fx1RowDisplay[FILTER_LAST] = {
    {
        NULL,
        NULL,
        "Gain" },
    {
        "Pan ",
        NULL,
        "Gain" },
    {
        "Freq",
        "Res ",
        "Gain" },
    {
        "Freq",
        "Res ",
        "Gain" },
    {
        "LoFr",
        "Boos",
        "Gain" },
    {
        "Freq",
        "Q   ",
        "Gain" },
    {
        "Samp",
        "Bits",
        "Gain" },
    {
        "Freq",
        "Res ",
        "Gain" },
    {
        "Freq",
        "Res ",
        "Gain" },
    {
        "Freq",
        "Q   ",
        "Gain" },
    {
        "Freq",
        "Res ",
        "Gain" },
    {
        "Freq",
        "Res ",
        "Gain" },
    {
        "Freq",
        "Res ",
        "Gain" },
    {
        "Freq",
        "Res ",
        "Gain" },
    {
        "Freq",
        "Res ",
        "Gain" },
    {
        "Freq",
        "Amp ",
        "Gain" },
    {
        "Freq",
        "Amp ",
        "Gain" },
    {
        "Freq",
        "Amp ",
        "Gain" },
    {
        "Freq",
        "Res ",
        "Gain" },
    {
        "Freq",
        "Res ",
        "Gain" },
    {
        "Freq",
        "Mix ",
        "Gain" },
    {
        "Freq",
        "Mod ",
        "Gain" },
    {
        "Pos ",
        "Sprd",
        "Gain" },
    {
        "Thrs",
        "Tone",
        "Gain" },
    {
        "Driv",
        "Tone",
        "Gain" },
    {
        "Driv",
        "Tone",
        "Gain" },
    {
        "Driv",
        "Tone",
        "Gain" },
    {
        "Thrs",
        "Tone",
        "Gain" },
    {
        "Freq",
        "Res ",
        "Gain" },
    {
        "Freq",
        "Res ",
        "Gain" },
    {
        "Freq",
        "Fold",
        "Gain" },
    {
        "Freq",
        "Fold",
        "Gain" },
    {
        "Pos ",
        "Freq",
        "Gain" },
    {
        "Pos ",
        "Freq",
        "Gain" },
    {
        "Freq",
        "Sprd",
        "Gain" },
    {
        "Freq",
        "Sprd",
        "Gain" },
    {
        "Freq",
        "Sprd",
        "Gain" },
    {
        "Freq",
        "Sprd",
        "Gain" },
    {
        "Vowl",
        "Tone",
        "Gain" },
    {
        "Vowl",
        "Tone",
        "Gain" },
    {
        "Vowl",
        "Tone",
        "Gain" },
    {
        "Freq",
        "Res ",
        "Gain" },
    {
        "Freq",
        "Res ",
        "Gain" },
    {
        "Freq",
        "Res ",
        "Gain" },
    {
        "Freq",
        "Res ",
        "Gain" },
    {
        "Freq",
        "Res ",
        "Gain" },
    {
        "Freq",
        "Res ",
        "Gain" },
    {
        "Freq",
        "Res ",
        "Gain" },
    {
        "Smp1",
        "Smp2",
        "Gain"
    }

};


const char *fx2Name[] = {
    "Off ",  /* 0 */
    "Flng", /* 1  */
    "Dim ", /* 2  */
    "Chor", /* 3  */
    "Wide", /* 4  */
    "Dblr", /* 5  */
    "3Voi", /* 6  */
    "Bode", /* 7  */
    "Delc", /* 8  */
    "Ping", /* 9  */
    "Diff", /* 10 */
    "Gra1", /* 11 */
    "Gra2", /* 12 */
};




struct ParameterRowDisplay fx2ParameterRow = {
    "FX2",
    {
        "Type",
        "    ",
        "    ",
        "Gain" },
    {
        {
            0,
            FILTER2_LAST - 1,
            FILTER2_LAST,
            DISPLAY_TYPE_STRINGS,
            fx2Name,
            nullNamesOrder,
            nullNamesOrder },
        {
            0,
            1,
            101,
            DISPLAY_TYPE_FLOAT,
            nullNames,
            nullNamesOrder,
            nullNamesOrder },
        {
            0,
            1,
            101,
            DISPLAY_TYPE_FLOAT,
            nullNames,
            nullNamesOrder,
            nullNamesOrder },
        {
            0,
            2,
            201,
            DISPLAY_TYPE_FLOAT,
            nullNames,
            nullNamesOrder,
            nullNamesOrder } } };

struct FilterRowDisplay fx2RowDisplay[FILTER2_LAST] = {
    {
        NULL,
        NULL,
        "Gain" },
    {
        "Rate",
        "Feed",
        "Mix " },
    {
        "Rate",
        "M/S ",
        "Mix " },
    {
        "Rate",
        "Vibr",
        "Mix " },
    {
        "Detu",
        "Freq",
        "Mix " },
    {
        "Ptch",
        "Feed",
        "Mix " },
    {
        "Ptc1",
        "Ptc2",
        "Mix " },
    {
        "Freq",
        "Feed",
        "Mix " },
    {
        "Time",
        "Feed",
        "Mix " },
    {
        "Time",
        "Feed",
        "Mix " },
    {
        "Time",
        "Feed",
        "Mix " },
    {
        "Size",
        "Sprd",
        "Mix " },
    {
        "Tune",
        "Sprd",
        "Mix " }
};




const char *oscShapeNames[] = {
    "sin ",
    "saw ",
    "squa",
    "s^2 ",
    "szer",
    "spos",
    "rand",
    "off ",
    "Usr1",
    "Usr2",
    "Usr3",
    "Usr4",
    "Usr5",
    "Usr6" };
const unsigned char oscShapeNamesOrder[] = {
    7,
    0,
    1,
    2,
    3,
    4,
    5,
    6,
    8,
    9,
    10,
    11,
    12,
    13 };
//                                                 { 0, 1, 2, 3, 4, 5, 6, 7, 8, 9, 10, 11, 12, 13};
const unsigned char oscShapeNamesPosition[] = {
    1,
    2,
    3,
    4,
    5,
    6,
    7,
    0,
    8,
    9,
    10,
    11,
    12,
    13 };

const char *oscTypeNames[] = {
    "keyb",
    "fixe",
    "kehz" };
const unsigned char oscTypeNamesOrder[] = {
    0,
    2,
    1 };
const unsigned char oscTypeNamesPosition[] = {
    0,
    2,
    1 };

struct ParameterRowDisplay oscParameterRow = {
    "Oscillator",
    {
        "Shap",
        "FTyp",
        "Freq",
        "FTun" },
    {
        {
            OSC_SHAPE_SIN,
            OSC_SHAPE_LAST - 1,
            OSC_SHAPE_LAST,
            DISPLAY_TYPE_STRINGS,
            oscShapeNames,
            oscShapeNamesOrder,
            oscShapeNamesPosition },
        {
            OSC_FT_KEYBOARD,
            OSC_FT_KEYHZ,
            3,
            DISPLAY_TYPE_STRINGS,
            oscTypeNames,
            oscTypeNamesOrder,
            oscTypeNamesPosition },
        {
            0,
            16,
            193,
            DISPLAY_TYPE_FLOAT_OSC_FREQUENCY,
            nullNames,
            nullNamesOrder,
            nullNamesOrder },
        {
            -9,
            9,
            1801,
            DISPLAY_TYPE_FLOAT_OSC_FREQUENCY,
            nullNames,
            nullNamesOrder,
            nullNamesOrder } } };

struct ParameterRowDisplay envParameterTime = {
    "Env T",
    {
        "Attk",
        "Deca",
        "Sust",
        "Rel" },
    {
        {
            0,
            16,
            1601,
            DISPLAY_TYPE_FLOAT,
            nullNames,
            nullNamesOrder,
            nullNamesOrder },
        {
            0,
            16,
            1601,
            DISPLAY_TYPE_FLOAT,
            nullNames,
            nullNamesOrder,
            nullNamesOrder },
        {
            0,
            16,
            1601,
            DISPLAY_TYPE_FLOAT,
            nullNames,
            nullNamesOrder,
            nullNamesOrder },
        {
            0,
            16,
            1601,
            DISPLAY_TYPE_FLOAT,
            nullNames,
            nullNamesOrder,
            nullNamesOrder } } };

struct ParameterRowDisplay envParameterLevel = {
    "Env L",
    {
        "Attk",
        "Deca",
        "Sust",
        "Rel" },
    {
        {
            0,
            1,
            101,
            DISPLAY_TYPE_FLOAT,
            nullNames,
            nullNamesOrder,
            nullNamesOrder },
        {
            0,
            1,
            101,
            DISPLAY_TYPE_FLOAT,
            nullNames,
            nullNamesOrder,
            nullNamesOrder },
        {
            0,
            1,
            101,
            DISPLAY_TYPE_FLOAT,
            nullNames,
            nullNamesOrder,
            nullNamesOrder },
        {
            0,
            1,
            101,
            DISPLAY_TYPE_FLOAT,
            nullNames,
            nullNamesOrder,
            nullNamesOrder } } };

struct ParameterRowDisplay lfoEnvParameterRow = {
    "Free Env",
    {
        "Attk",
        "Deca",
        "Sust",
        "Rele" },
    {
        {
            0,
            16,
            1601,
            DISPLAY_TYPE_FLOAT,
            nullNames,
            nullNamesOrder,
            nullNamesOrder },
        {
            0,
            16,
            1601,
            DISPLAY_TYPE_FLOAT,
            nullNames,
            nullNamesOrder,
            nullNamesOrder },
        {
            0,
            1,
            101,
            DISPLAY_TYPE_FLOAT,
            nullNames,
            nullNamesOrder,
            nullNamesOrder },
        {
            0,
            16,
            1601,
            DISPLAY_TYPE_FLOAT,
            nullNames,
            nullNamesOrder,
            nullNamesOrder } } };

const char *lofEnv2Loop[] = {
    "No  ",
    "Sile",
    "Attk" };
struct ParameterRowDisplay lfoEnv2ParameterRow = {
    "Free Env",
    {
        "Sile",
        "Attk",
        "Deca",
        "Loop" },
    {
        {
            0,
            16,
            1601,
            DISPLAY_TYPE_FLOAT,
            nullNames,
            nullNamesOrder,
            nullNamesOrder },
        {
            0,
            16,
            1601,
            DISPLAY_TYPE_FLOAT,
            nullNames,
            nullNamesOrder,
            nullNamesOrder },
        {
            0,
            16,
            1601,
            DISPLAY_TYPE_FLOAT,
            nullNames,
            nullNamesOrder,
            nullNamesOrder },
        {
            LFO_ENV2_NOLOOP,
            LFO_ENV2_LOOP_ATTACK,
            3,
            DISPLAY_TYPE_STRINGS,
            lofEnv2Loop,
            nullNamesOrder,
            nullNamesOrder } } };



const char *matrixSourceNames[MATRIX_SOURCE_MAX] = { /* 0 */ "none  ", "Lfo 1 ", "Lfo 2 ", "Lfo 3 ", "Env 1 ", "Env 2 ", "Seq 1 ", "Seq 2 ",
    /* 8 */  "ModWel", "PitBen", "AftTou", "Veloc ", "Note1 ", "Perf1 ", "Perf2 ",
    /* 15 */  "Perf3 ", "Perf4 ", "Note2 ", "Breath", "74 MPE", "RndKey", "PolyAT",
    /* 22 */ "UsrCC1", "UsrCC2", "UsrCC3", "UsrCC4",
    /* 26 */  "PB MPE", "AT MPE"};

const unsigned char matrixSourceOrder[MATRIX_SOURCE_MAX] = { 0, 1, 2, 3, 4, 5, 6, 7, 12, 17, 8, 9, 10, 21, 11, 18, 13, 14, 15, 16, 20, 26, 27, 19, 22, 23, 24, 25 };
unsigned char matrixSourcePosition[MATRIX_SOURCE_MAX];

const char *matrixDestNames[DESTINATION_MAX] = { "None ", "Gate ", "IM 1 ", "IM 2 ", "IM 3 ", "IM 4 ", "IMAll", "Mix 1", "Pan 1", "Mix 2", "Pan 2", "Mix 3", "Pan 3", "Mix 4", "Pan 4",
    "Mix *", "Pan *", "o1 Fq", "o2 Fq", "o3 Fq", "o4 Fq", "o5 Fq", "o6 Fq", "o* Fq",
    /*24*/"Atk 1", "Atk 2", "Atk 3", "Atk 4", "Atk 5", "Atk 6",
    /*30*/"Atk C", "Rel C",
    /*32*/"mtx 1" , "mtx 2", "mtx 3", "mtx 4",
    /*36*/"lfo1F", "lfo2F", "lfo3F", "env2S", "stp1G", "stp2G",
    /*42*/"Fx1 1",
    /*43*/"o* Fh", "Dec C",
    /*45*/"Atk M", "Dec M", "Rel M",
    /* 48 pfm3 feedback */ "FdBck",
    /*filter param 2*/  "Fx1 2",
    /*filter amp 2*/  "fx1Am",
    /*filter2 param 1*/  "Fx2 1",
    /*filter2 param 1*/  "Fx2 2",
    /*filter2 amp*/  "Fx2Am",
    };
const unsigned char matrixTargetOrder[DESTINATION_MAX] = { 0, 1, 2, 3, 4, 5, 48, 6, 7, 8, 9, 10, 11, 12, 13, 14, 15, 16, 17, 18, 19, 20, 21, 22, 23, 43, 24, 25, 26, 27, 28, 29,
    30, 45, 44, 46, 31, 47, 32, 33, 34, 35, 36, 37, 38, 39, 40, 41, 42, 49, 50, 51, 52, 53 };

unsigned char matrixTargetPosition[DESTINATION_MAX];

struct ParameterRowDisplay matrixParameterRow = {
    "Matrix",
    {
        "Srce",
        "Mult",
        "Dest1",
        "Dest2" },
    {
        {
            MATRIX_SOURCE_NONE,
            MATRIX_SOURCE_MAX - 1,
            MATRIX_SOURCE_MAX,
            DISPLAY_TYPE_STRINGS,
            matrixSourceNames,
            matrixSourceOrder,
            matrixSourcePosition },
        {
            -10,
            24,
            3401,
            DISPLAY_TYPE_FLOAT,
            nullNames,
            nullNamesOrder,
            nullNamesOrder },
        {
            DESTINATION_NONE,
            DESTINATION_MAX - 1,
            DESTINATION_MAX,
            DISPLAY_TYPE_STRINGS,
            matrixDestNames,
            matrixTargetOrder,
            matrixTargetPosition },
        {
            DESTINATION_NONE,
            DESTINATION_MAX - 1,
            DESTINATION_MAX,
            DISPLAY_TYPE_STRINGS,
            matrixDestNames,
            matrixTargetOrder,
            matrixTargetPosition } } };

const char *lfoOscMidiClock[] = {
    "C/16",
    "Ck/8",
    "Ck/4",
    "Ck/2",
    "Ck  ",
    "Ck*2",
    "Ck*3",
    "Ck*4",
    "Ck*8" };
const char *lfoShapeNames[] = {
    "Sin ",
    "Saw ",
    "Tria",
    "Squa",
    "Rand",
    "Brwn",
    "Wndr",
    "Flow"
     };

struct ParameterRowDisplay lfoParameterRow = {
    "LFO",
    {
        "Shap",
        "Freq",
        "Bias",
        "KSyn" },
    {
        {
            LFO_SIN,
            LFO_TYPE_MAX - 1,
            LFO_TYPE_MAX,
            DISPLAY_TYPE_STRINGS,
            lfoShapeNames,
            nullNamesOrder,
            nullNamesOrder },
        {
            0,
            LFO_FREQ_MAX + .9f,
            LFO_FREQ_MAX_TIMES_10 + 1 + 9,
            DISPLAY_TYPE_FLOAT_LFO_FREQUENCY,
            nullNames,
            nullNamesOrder,
            nullNamesOrder },
        {
            -1,
            1,
            201,
            DISPLAY_TYPE_FLOAT,
            nullNames,
            nullNamesOrder,
            nullNamesOrder },
        {
            -0.01f,
            16.0f,
            1602,
            DISPLAY_TYPE_LFO_KSYN,
            nullNames,
            nullNamesOrder,
            nullNamesOrder } } };

const char *lfoSeqMidiClock[] = {
    "Ck/4",
    "Ck/2",
    "Ck  ",
    "Ck*2",
    "Ck*4" };

struct ParameterRowDisplay lfoStepParameterRow = {
    "Step Seq",
    {
        "Bpm ",
        "Gate",
        "Steps",
        "" },
    {
        {
            10,
            245,
            236,
            DISPLAY_TYPE_STEP_SEQ_BPM,
            nullNames,
            nullNamesOrder,
            nullNamesOrder },
        {
            0,
            1,
            101,
            DISPLAY_TYPE_FLOAT,
            nullNames,
            nullNamesOrder,
            nullNamesOrder },
        {
            0,
            0,
            0,
            DISPLAY_TYPE_STEP_SEQ1,
            nullNames,
            nullNamesOrder,
            nullNamesOrder },
        {
            0,
            0,
            0,
            DISPLAY_TYPE_STEP_SEQ2,
            nullNames,
            nullNamesOrder,
            nullNamesOrder } } };

struct ParameterRowDisplay performanceParameterRow1 = {
    "   -Performance-",
    {
        " p1 ",
        " p2 ",
        " p3 ",
        " p4 " },
    {
        {
            -1,
            1,
            201,
            DISPLAY_TYPE_FLOAT,
            nullNames,
            nullNamesOrder,
            nullNamesOrder },
        {
            -1,
            1,
            201,
            DISPLAY_TYPE_FLOAT,
            nullNames,
            nullNamesOrder,
            nullNamesOrder },
        {
            -1,
            1,
            201,
            DISPLAY_TYPE_FLOAT,
            nullNames,
            nullNamesOrder,
            nullNamesOrder },
        {
            -1,
            1,
            201,
            DISPLAY_TYPE_FLOAT,
            nullNames,
            nullNamesOrder,
            nullNamesOrder } } };

struct ParameterRowDisplay lfoPhaseParameterRow = {
    "LFO Phase",
    {
        "Phase",
        "Phase",
        "Phase",
        "    " },
    {
        {
            0,
            1,
            101,
            DISPLAY_TYPE_FLOAT,
            nullNames,
            nullNamesOrder,
            nullNamesOrder },
        {
            0,
            1,
            101,
            DISPLAY_TYPE_FLOAT,
            nullNames,
            nullNamesOrder,
            nullNamesOrder },
        {
            0,
            1,
            101,
            DISPLAY_TYPE_FLOAT,
            nullNames,
            nullNamesOrder,
            nullNamesOrder },
        {
            0,
            0,
            0,
            DISPLAY_TYPE_NONE,
            nullNames,
            nullNamesOrder,
            nullNamesOrder } } };

const char *midiNoteCurves[] = {
    "Flat",
    "+Lin",
    "+Ln8",
    "+Exp",
    "-Lin",
    "-Ln8",
    "-Exp" };


struct ParameterRowDisplay midiNote1ParameterRow = {
    "Note1 Midi Scaling",
    {
        "Befo",
        "Brk ",
        "Afte",
        "    " },
    {
        {
            MIDI_NOTE_CURVE_FLAT,
            MIDI_NOTE_CURVE_MAX - 1,
            MIDI_NOTE_CURVE_MAX,
            DISPLAY_TYPE_STRINGS,
            midiNoteCurves,
            nullNamesOrder,
            nullNamesOrder },
        {
            0,
            127,
            128,
            DISPLAY_TYPE_INT,
            nullNames,
            nullNamesOrder,
            nullNamesOrder },
        {
            MIDI_NOTE_CURVE_FLAT,
            MIDI_NOTE_CURVE_MAX - 1,
            MIDI_NOTE_CURVE_MAX,
            DISPLAY_TYPE_STRINGS,
            midiNoteCurves,
            nullNamesOrder,
            nullNamesOrder },
        {
            0,
            0,
            0,
            DISPLAY_TYPE_NONE,
            nullNames,
            nullNamesOrder,
            nullNamesOrder } } };

struct ParameterRowDisplay midiNote2ParameterRow = {
    "Note2 Midi Scaling",
    {
        "Befo",
        "Brk ",
        "Afte",
        "    " },
    {
        {
            MIDI_NOTE_CURVE_FLAT,
            MIDI_NOTE_CURVE_MAX - 1,
            MIDI_NOTE_CURVE_MAX,
            DISPLAY_TYPE_STRINGS,
            midiNoteCurves,
            nullNamesOrder,
            nullNamesOrder },
        {
            0,
            127,
            128,
            DISPLAY_TYPE_INT,
            nullNames,
            nullNamesOrder,
            nullNamesOrder },
        {
            MIDI_NOTE_CURVE_FLAT,
            MIDI_NOTE_CURVE_MAX - 1,
            MIDI_NOTE_CURVE_MAX,
            DISPLAY_TYPE_STRINGS,
            midiNoteCurves,
            nullNamesOrder,
            nullNamesOrder },
        {
            0,
            0,
            0,
            DISPLAY_TYPE_NONE,
            nullNames,
            nullNamesOrder,
            nullNamesOrder } } };

struct ParameterRowDisplay dummyParameterRow = {
    "",
    {
        "",
        "",
        "",
        "" },
    {
        {
            0,
            0,
            0,
            DISPLAY_TYPE_NONE,
            nullNames,
            nullNamesOrder,
            nullNamesOrder  },
        {
            0,
            0,
            0,
            DISPLAY_TYPE_NONE,
            nullNames,
            nullNamesOrder,
            nullNamesOrder  },
        {
            0,
            0,
            0,
            DISPLAY_TYPE_NONE,
            nullNames,
            nullNamesOrder,
            nullNamesOrder  },
        {
            0,
            0,
            0,
            DISPLAY_TYPE_NONE,
            nullNames,
            nullNamesOrder,
            nullNamesOrder } } };


struct AllParameterRowsDisplay allParameterRows = {
    {
        &engine1ParameterRow,
        &engineIM1ParameterRow,
        &engineIM2ParameterRow,
        &engineIM3ParameterRow,
        &engineMix1ParameterRow,
        &engineMix2ParameterRow,
        &engineMix3ParameterRow,
        &engineArp1ParameterRow,
        &engineArp2ParameterRow,
        &engineArpPatternRow,
        &fx1ParameterRow,
        &oscParameterRow,
        &oscParameterRow,
        &oscParameterRow,
        &oscParameterRow,
        &oscParameterRow,
        &oscParameterRow,
        &envParameterTime,
        &envParameterTime,
        &envParameterTime,
        &envParameterTime,
        &envParameterTime,
        &envParameterTime,
        &envParameterLevel,
        &envParameterLevel,
        &envParameterLevel,
        &envParameterLevel,
        &envParameterLevel,
        &envParameterLevel,
        &matrixParameterRow,
        &matrixParameterRow,
        &matrixParameterRow,
        &matrixParameterRow,
        &matrixParameterRow,
        &matrixParameterRow,
        &matrixParameterRow,
        &matrixParameterRow,
        &matrixParameterRow,
        &matrixParameterRow,
        &matrixParameterRow,
        &matrixParameterRow,
        &performanceParameterRow1,
        &lfoParameterRow,
        &lfoParameterRow,
        &lfoParameterRow,
        &lfoPhaseParameterRow,
        &lfoEnvParameterRow,
        &lfoEnv2ParameterRow,
        &lfoStepParameterRow,
        &lfoStepParameterRow,
        &midiNote1ParameterRow,
        &midiNote2ParameterRow,
        &dummyParameterRow,
        &dummyParameterRow,
        &engine2ParameterRow,
        &engineCurveParameterRow,
        &engineCurveParameterRow,
        &engineCurveParameterRow,
        &engineCurveParameterRow,
        &engineCurveParameterRow,
        &engineCurveParameterRow,
        &fx2ParameterRow

} };

// =================================================
// constant for pfm3 editor
// =================================================

const struct Pfm3OneButtonState pfm3ButtonEngineState = {
    "Engine",
    {
        {
            ROW_ENGINE,
            ENCODER_ENGINE_ALGO },
        {
            ROW_NONE,
            ENCODER_NONE },
        {
            ROW_NONE,
            ENCODER_NONE },
        {
            ROW_ENGINE,
            ENCODER_ENGINE_VELOCITY },
        {
            ROW_ENGINE,
            ENCODER_ENGINE_PLAY_MODE },
        {
            ROW_NONE,
            ENCODER_NONE },
} };

const struct Pfm3OneButtonState pfm3ButtonMonoState = {
    "Mono",
    {
        {
            ROW_ENGINE2,
            ENCODER_ENGINE2_GLIDE_TYPE },
        {
            ROW_ENGINE,
            ENCODER_ENGINE_GLIDE_SPEED },
        {
            ROW_NONE,
            ENCODER_NONE },
        {
            ROW_ENGINE2,
            ENCODER_ENGINE2_UNISON_SPREAD },
        {
            ROW_ENGINE2,
            ENCODER_ENGINE2_UNISON_DETUNE },
        {
            ROW_NONE,
            ENCODER_NONE }
} };


const struct Pfm3OneButton pfm3ButtonEngine = {
    "Engine",
    BUTTONID_EDIT_ENGINE,
    2,
    {
        &pfm3ButtonEngineState,
        &pfm3ButtonMonoState } };

const struct Pfm3OneButtonState pfm3ButtonIMState = {
    "Modulation Index",
    {
        {
            ROW_MODULATION1,
            ENCODER_ENGINE_IM1 },
        {
            ROW_MODULATION1,
            ENCODER_ENGINE_IM2 },
        {
            ROW_MODULATION2,
            ENCODER_ENGINE_IM3 },
        {
            ROW_MODULATION2,
            ENCODER_ENGINE_IM4 },
        {
            ROW_MODULATION3,
            ENCODER_ENGINE_IM5 },
        {
            ROW_MODULATION3,
            ENCODER_ENGINE_IM6 } } };

const struct Pfm3OneButtonState pfm3ButtonIMVelocityState = {
    "Velocity",
    {
        {
            ROW_MODULATION1,
            ENCODER_ENGINE_IM1_VELOCITY },
        {
            ROW_MODULATION1,
            ENCODER_ENGINE_IM2_VELOCITY },
        {
            ROW_MODULATION2,
            ENCODER_ENGINE_IM3_VELOCITY },
        {
            ROW_MODULATION2,
            ENCODER_ENGINE_IM4_VELOCITY },
        {
            ROW_MODULATION3,
            ENCODER_ENGINE_IM5_VELOCITY },
        {
            ROW_MODULATION3,
            ENCODER_ENGINE_IM6_VELOCITY } } };

const struct Pfm3OneButton pfm3ButtonIM = {
    "MI",
    BUTTONID_EDIT_IM,
    2,
    {
        &pfm3ButtonIMState,
        &pfm3ButtonIMVelocityState } };

const struct Pfm3OneButtonState pfm3ButtonMixer123State = {
    "Op Mixer",
    {
        {
            ROW_OSC_MIX1,
            ENCODER_ENGINE_MIX1 },
        {
            ROW_OSC_MIX1,
            ENCODER_ENGINE_MIX2 },
        {
            ROW_OSC_MIX2,
            ENCODER_ENGINE_MIX3 },
        {
            ROW_OSC_MIX1,
            ENCODER_ENGINE_PAN1 },
        {
            ROW_OSC_MIX1,
            ENCODER_ENGINE_PAN2 },
        {
            ROW_OSC_MIX2,
            ENCODER_ENGINE_PAN3 } } };

const struct Pfm3OneButtonState pfm3ButtonMixer456State = {
    "Op Mixer",
    {
        {
            ROW_OSC_MIX2,
            ENCODER_ENGINE_MIX4 },
        {
            ROW_OSC_MIX3,
            ENCODER_ENGINE_MIX5 },
        {
            ROW_OSC_MIX3,
            ENCODER_ENGINE_MIX6 },
        {
            ROW_OSC_MIX2,
            ENCODER_ENGINE_PAN4 },
        {
            ROW_OSC_MIX3,
            ENCODER_ENGINE_PAN5 },
        {
            ROW_OSC_MIX3,
            ENCODER_ENGINE_PAN6 } } };

const struct Pfm3OneButton pfm3ButtonMixer = {
    "Mix",
    BUTTONID_EDIT_FILTER,
    2,
    {
        &pfm3ButtonMixer123State,
        &pfm3ButtonMixer456State } };

const struct Pfm3OneButtonState pfm3ButtonArpeggiator1State = {
    "Arpeggiator",
    {
        {
            ROW_ARPEGGIATOR1,
            ENCODER_ARPEGGIATOR_CLOCK },
        {
            ROW_ARPEGGIATOR1,
            ENCODER_ARPEGGIATOR_BPM },
        {
            ROW_ARPEGGIATOR1,
            ENCODER_ARPEGGIATOR_DIRECTION },
        {
            ROW_ARPEGGIATOR1,
            ENCODER_ARPEGGIATOR_OCTAVE },
        {
            ROW_ARPEGGIATOR2,
            ENCODER_ARPEGGIATOR_DIVISION },
        {
            ROW_ARPEGGIATOR2,
            ENCODER_ARPEGGIATOR_DURATION } } };

const struct Pfm3OneButtonState pfm3ButtonArpeggiator2State = {
    "Arpeggiator",
    {
        {
            ROW_ARPEGGIATOR2,
            ENCODER_ARPEGGIATOR_PATTERN },
        {
            ROW_ARPEGGIATOR2,
            ENCODER_ARPEGGIATOR_LATCH },
        {
            ROW_NONE,
            ENCODER_NONE },
        {
            ROW_ARPEGGIATOR3,
            0 },
        {
            ROW_ARPEGGIATOR3,
            1 },
        {
            ROW_ARPEGGIATOR3,
            2 } } };

const struct Pfm3OneButton pfm3ButtonArpeggiator = {
    "Arp",
    BUTTONID_EDIT_ARPEGIATOR,
    2,
    {
        &pfm3ButtonArpeggiator1State,
        &pfm3ButtonArpeggiator2State } };

const struct Pfm3OneButtonState pfm3ButtonFx1State = {
    "Voice FX",
    {
        {
            ROW_EFFECT1,
            ENCODER_EFFECT_TYPE },
        {
            ROW_EFFECT1,
            ENCODER_EFFECT_PARAM1 },
        {
            ROW_EFFECT1,
            ENCODER_EFFECT_PARAM2 },
        {
            ROW_EFFECT1,
            ENCODER_EFFECT_PARAM3 },
        {
            ROW_NONE,
            ENCODER_NONE },
        {
            ROW_NONE,
            ENCODER_NONE } } };

const struct Pfm3OneButtonState pfm3ButtonFx2State = {
    "Paraphonic FX",
    {
        {
            ROW_EFFECT2,
            ENCODER_EFFECT_TYPE },
        {
            ROW_EFFECT2,
            ENCODER_EFFECT_PARAM1 },
        {
            ROW_EFFECT2,
            ENCODER_EFFECT_PARAM2 },
        {
            ROW_EFFECT2,
            ENCODER_EFFECT_PARAM3 },
        {
            ROW_NONE,
            ENCODER_NONE },
        {
            ROW_NONE,
            ENCODER_NONE } } };


const struct Pfm3OneButton pfm3ButtonFx1 = {
    "Fx1",
    BUTTONID_ONLY_ONE_STATE,
    1,
    {
        &pfm3ButtonFx1State } };

const struct Pfm3OneButton pfm3ButtonFx2 = {
    "Fx2",
    BUTTONID_ONLY_ONE_STATE,
    1,
    {
        &pfm3ButtonFx2State } };


// ======================= OPERATOR ====================================

const struct Pfm3OneButtonState pfm3ButtonOPEnvLevel = {
    "Env Level",
    {
        {
            ROW_ENV1_LEVEL,
            ENCODER_ENV_A },
        {
            ROW_ENV1_LEVEL,
            ENCODER_ENV_D },
        {
            ROW_ENV1_LEVEL,
            ENCODER_ENV_S },
        {
            ROW_NONE,
            ENCODER_NONE },
        {
            ROW_NONE,
            ENCODER_NONE },
        {
            ROW_ENV1_LEVEL,
            ENCODER_ENV_R }
    } };

const struct Pfm3OneButton pfm3ButtonOPEnv2 = {
    "Level",
    BUTTONID_ONLY_ONE_STATE,
    1,
    {
        &pfm3ButtonOPEnvLevel } };


const struct Pfm3OneButtonState pfm3ButtonOPEnvTime = {
    "Env Time",
    {
        {
            ROW_ENV1_TIME,
            ENCODER_ENV_A },
        {
            ROW_ENV1_TIME,
            ENCODER_ENV_D },
        {
            ROW_ENV1_TIME,
            ENCODER_ENV_S },
        {
            ROW_NONE,
            ENCODER_NONE },
        {
            ROW_NONE,
            ENCODER_NONE },
        {
            ROW_ENV1_TIME,
            ENCODER_ENV_R }
    } };

const struct Pfm3OneButtonState pfm3ButtonEnvCurve = {
    "Env Curve",
    {
        {
            ROW_ENV1_CURVE,
            ENCODER_ENV_A_CURVE },
        {
            ROW_ENV1_CURVE,
            ENCODER_ENV_D_CURVE },
        {
            ROW_ENV1_CURVE,
            ENCODER_ENV_S_CURVE },
        {
            ROW_NONE,
            ENCODER_NONE },
        {
            ROW_NONE,
            ENCODER_NONE },
        {
            ROW_ENV1_CURVE,
            ENCODER_ENV_R_CURVE }
    } };

const struct Pfm3OneButton pfm3ButtonOPEnv1 = {
    "Env",
    BUTTONID_ENV_1,
    2,
    {
        &pfm3ButtonOPEnvTime,
        &pfm3ButtonEnvCurve } };

const struct Pfm3OneButtonState pfm3ButtonOPShapeState = {
    "Oscillator",
    {
        {
            ROW_OSC1,
            ENCODER_OSC_SHAP },
        {
            ROW_OSC1,
            ENCODER_OSC_FTYPE },
        {
            ROW_OSC1,
            ENCODER_OSC_FREQ },
        {
            ROW_OSC1,
            ENCODER_OSC_FTUNE },
        {
            ROW_NONE,
            ENCODER_NONE },
        {
            ROW_NONE,
            ENCODER_NONE } } };

const struct Pfm3OneButton pfm3ButtonOPShape = {
    "Osc",
    BUTTONID_ONLY_ONE_STATE,
    1,
    {
        &pfm3ButtonOPShapeState } };

const struct Pfm3OneButtonState pfm3ButtonNoPage = {
    "",
    {
        {
            ROW_NONE,
            ENCODER_NONE },
        {
            ROW_NONE,
            ENCODER_NONE },
        {
            ROW_NONE,
            ENCODER_NONE },
        {
            ROW_NONE,
            ENCODER_NONE },
        {
            ROW_NONE,
            ENCODER_NONE },
        {
            ROW_NONE,
            ENCODER_NONE } } };



const struct Pfm3OneButton pfm3ButtonOPMinus = {
    "1-2",
    BUTTONID_OPERATOR_1_2,
    2,
    {
        &pfm3ButtonNoPage } };

const struct Pfm3OneButton pfm3ButtonOPNothing = {
    "3-4",
    BUTTONID_OPERATOR_3_4,
    2,
    {
        &pfm3ButtonNoPage } };

const struct Pfm3OneButton pfm3ButtonOPPlus = {
    "5-6",
    BUTTONID_OPERATOR_5_6,
    2,
    {
        &pfm3ButtonNoPage } };

// ======================= MATRIX ====================================

const struct Pfm3OneButtonState pfm3ButtonMatrix1State = {
    "Matrix 1",
    {
        {
            ROW_MATRIX1,
            ENCODER_MATRIX_SOURCE },
        {
            ROW_MATRIX1,
            ENCODER_MATRIX_MUL },
        {
            ROW_MATRIX1,
            ENCODER_MATRIX_DEST1 },
        {
            ROW_NONE,
            ENCODER_NONE },
        {
            ROW_NONE,
            ENCODER_NONE },
        {
            ROW_MATRIX1,
            ENCODER_MATRIX_DEST2 } } };

const struct Pfm3OneButtonState pfm3ButtonMatrix2State = {
    "Matrix 2",
    {
        {
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
        {
            ROW_LFOOSC1,
            ENCODER_LFO_FREQ },
        {
            ROW_LFOOSC1,
            ENCODER_LFO_KSYNC },
        {
            ROW_LFOOSC1,
            ENCODER_LFO_BIAS },
        {
            ROW_LFOPHASES,
            ENCODER_LFO_PHASE1 }
    }
};

const struct Pfm3OneButtonState pfm3ButtonLfoState2 = {
    "LFO 2",
    {
        {
            ROW_LFOOSC2,
            ENCODER_LFO_SHAPE },
        {
            ROW_NONE,
            ENCODER_MODULATOR_SYNC_LFO },
        {
            ROW_LFOOSC2,
            ENCODER_LFO_FREQ },
        {
            ROW_LFOOSC2,
            ENCODER_LFO_KSYNC },
        {
            ROW_LFOOSC2,
            ENCODER_LFO_BIAS },
        {
            ROW_LFOPHASES,
            ENCODER_LFO_PHASE2 } } };
const struct Pfm3OneButtonState pfm3ButtonLfoState3 = {
    "LFO 3",
    {
        {
            ROW_LFOOSC3,
            ENCODER_LFO_SHAPE },
        {
            ROW_NONE,
            ENCODER_MODULATOR_SYNC_LFO },
        {
            ROW_LFOOSC3,
            ENCODER_LFO_FREQ },
        {
            ROW_LFOOSC3,
            ENCODER_LFO_KSYNC },
        {
            ROW_LFOOSC3,
            ENCODER_LFO_BIAS },
        {
            ROW_LFOPHASES,
            ENCODER_LFO_PHASE3 } } };

const struct Pfm3OneButton pfm3ButtonLfos = {
    "Lfos",
    BUTTONID_EDIT_LFOS,
    3,
    {
        &pfm3ButtonLfoState1,
        &pfm3ButtonLfoState2,
        &pfm3ButtonLfoState3 } };

const struct Pfm3OneButtonState pfm3ButtonEnvState1 = {
    "Free Env 1",
    {
        {
            ROW_LFOENV1,
            0 },
        {
            ROW_LFOENV1,
            1 },
        {
            ROW_LFOENV1,
            2 },
        {
            ROW_LFOENV1,
            3 },
        {
            ROW_NONE,
            ENCODER_NONE },
        {
            ROW_NONE,
            ENCODER_NONE } } };

const struct Pfm3OneButtonState pfm3ButtonEnvState2 = {
    "Free Env 2",
    {
        {
            ROW_LFOENV2,
            0 },
        {
            ROW_LFOENV2,
            1 },
        {
            ROW_LFOENV2,
            2 },
        {
            ROW_LFOENV2,
            3 },
        {
            ROW_NONE,
            ENCODER_NONE },
        {
            ROW_NONE,
            ENCODER_NONE } } };

const struct Pfm3OneButton pfm3ButtonEnvs = {
    "Envs",
    BUTTONID_EDIT_ENVS,
    2,
    {
        &pfm3ButtonEnvState1,
        &pfm3ButtonEnvState2 } };

const struct Pfm3OneButtonState pfm3ButtonStepSeqStep1 = {
    "Step Sequencer 1",
    {
        {
            ROW_NONE,
            ENCODER_MODULATOR_SYNC_STEPS },
        {
            ROW_LFOSEQ1,
            ENCODER_STEPSEQ_BPM },
        {
            ROW_LFOSEQ1,
            ENCODER_STEPSEQ_GATE },
        {
            ROW_LFOSEQ1,
            2 },
        {
            ROW_LFOSEQ1,
            3 },
        {
            ROW_NONE,
            ENCODER_INVISIBLE } } };

const struct Pfm3OneButtonState pfm3ButtonStepSeqStep2 = {
    "Step Sequencer 2",
    {
        {
            ROW_NONE,
            ENCODER_MODULATOR_SYNC_STEPS },
        {
            ROW_LFOSEQ2,
            ENCODER_STEPSEQ_BPM },
        {
            ROW_LFOSEQ2,
            ENCODER_STEPSEQ_GATE },
        {
            ROW_LFOSEQ2,
            2 },
        {
            ROW_LFOSEQ2,
            3 },
        {
            ROW_NONE,
            ENCODER_INVISIBLE } } };

const struct Pfm3OneButton pfm3ButtonSteps = {
    "Steps",
    BUTTONID_EDIT_STEPS,
    2,
    {
        &pfm3ButtonStepSeqStep1,
        &pfm3ButtonStepSeqStep2 } };

const struct Pfm3OneButtonState pfm3ButtonMidiState1 = {
    "Midi note 1",
    {
        {
            ROW_MIDINOTE1CURVE,
            ENCODER_NOTECURVE_BEFORE },
        {
            ROW_MIDINOTE1CURVE,
            ENCODER_NOTECURVE_BREAK_NOTE },
        {
            ROW_MIDINOTE1CURVE,
            ENCODER_NOTECURVE_AFTER },
        {
            ROW_NONE,
            ENCODER_NONE },
        {
            ROW_NONE,
            ENCODER_NONE },
        {
            ROW_NONE,
            ENCODER_NONE } } };

const struct Pfm3OneButtonState pfm3ButtonMidiState2 = {
    "Midi note 2",
    {
        {
            ROW_MIDINOTE2CURVE,
            ENCODER_NOTECURVE_BEFORE },
        {
            ROW_MIDINOTE2CURVE,
            ENCODER_NOTECURVE_BREAK_NOTE },
        {
            ROW_MIDINOTE2CURVE,
            ENCODER_NOTECURVE_AFTER },
        {
            ROW_NONE,
            ENCODER_NONE },
        {
            ROW_NONE,
            ENCODER_NONE },
        {
            ROW_NONE,
            ENCODER_NONE } } };

const struct Pfm3OneButton pfm3ButtonMidiNotes = {
    "Midi",
    BUTTONID_EDIT_NOTES,
    2,
    {
        &pfm3ButtonMidiState1,
        &pfm3ButtonMidiState2 } };

//{ ROW_NONE, ENCODER_NONE }

const struct Pfm3EditMenu operatorEditMenu = {
    "Oper",
    6,
    {
        &pfm3ButtonOPShape,
        &pfm3ButtonOPEnv1,
        &pfm3ButtonOPEnv2,
        &pfm3ButtonOPMinus,
        &pfm3ButtonOPNothing,
        &pfm3ButtonOPPlus } };

const struct Pfm3EditMenu modulatorEditorMenu = {
    "Modul",
    4,
    {
        &pfm3ButtonLfos,
        &pfm3ButtonEnvs,
        &pfm3ButtonSteps,
        &pfm3ButtonMidiNotes } };

const struct Pfm3EditMenu pfm3EngineMenu = {
    "FM",
    3,
    {
        &pfm3ButtonEngine,
        &pfm3ButtonIM,
        &pfm3ButtonMixer,
 } };

const struct Pfm3EditMenu pfm3MatrixMenu = {
    "Matrix",
    6,
    {
        &pfm3ButtonMatrix1,
        &pfm3ButtonMatrix2,
        &pfm3ButtonMatrix3,
        &pfm3ButtonMatrix4,
        &pfm3ButtonMatrix5,
        &pfm3ButtonMatrix6, } };

// Performance

const struct Pfm3OneButtonState perfEditorState = {
    "Performance",
    {
        {
            ROW_PERFORMANCE1,
            ENCODER_PERFORMANCE_CC1 },
        {
            ROW_PERFORMANCE1,
            ENCODER_PERFORMANCE_CC2 },
        {
            ROW_PERFORMANCE1,
            ENCODER_PERFORMANCE_CC3 },
        {
            ROW_PERFORMANCE1,
            ENCODER_PERFORMANCE_CC4 },
        {
            ROW_EFFECT1,
            ENCODER_EFFECT_PARAM1 },
        {
            ROW_EFFECT1,
            ENCODER_EFFECT_PARAM2 } } };

const struct Pfm3OneButton perfEditorPage = {
    "Perf",
    BUTTONID_PERFORMANCE,
    1,
    {
        &perfEditorState } };

const struct Pfm3EditMenu pfm3PerfMenu = {
    "Perf",
    1,
    {
        &perfEditorPage } };

const struct Pfm3EditMenu pfm3ArpFilterMenu = {
    "Arp/Fx",
    3,
    {
        &pfm3ButtonArpeggiator,
        &pfm3ButtonFx1,
        &pfm3ButtonFx2
    } };


struct PfmMainMenu mainMenu = {
    &pfm3EngineMenu,
    &operatorEditMenu,
    &pfm3MatrixMenu,
    &modulatorEditorMenu,
    &pfm3ArpFilterMenu,
    &pfm3PerfMenu,
};

FMDisplayEditor::FMDisplayEditor() {
    for (int k = 0; k < NUMBER_OF_TIMBRES; k++) {
        valueChangedCounter_[k] = 0;
        presetModifed_[k] = false;
    }
    multipleEdition_ = false;

    // Computer matrixTargetPosition position
    int position = 0;
    for (int i = 0; i < DESTINATION_MAX; i++) {
        matrixTargetPosition[matrixTargetOrder[i]] = position++;
    }
    position = 0;
    for (int i = 0; i < MATRIX_SOURCE_MAX; i++) {
        matrixSourcePosition[matrixSourceOrder[i]] = position++;
    }

    // Init frequency to reach when changing Int/Ext
    for (int l = 0; l < 5; l++) {
        lfoFreqPreviousValue[l] = -1.0f;
    }
}

void FMDisplayEditor::newTimbre(int timbre) {
    checkOperatorNumber();
    currentTimbre_ = timbre;
}

uint8_t FMDisplayEditor::getX(int encoder) {
    uint8_t x = (encoder) * 8;
    if (x >= 24) {
        x -= 24;
    }
    return x;
}

void FMDisplayEditor::newParamValue(int &refreshStatus, int timbre, int currentRow, int encoder,
    ParameterDisplay *param, float oldValue, float newValue) {

    const struct Pfm3EditMenu *editMenu = mainMenu.editMenu[synthState_->fullState.mainPage];
    const struct Pfm3OneButton *page = editMenu->pages[synthState_->fullState.editPage];
    uint8_t buttonState = synthState_->fullState.buttonState[page->buttonId];

    int encoder6 = -1;
    for (int enc = 0; (enc < 6) && (encoder6 == -1); enc++) {
        const struct RowEncoder rowEncoder = page->states[buttonState]->rowEncoder[enc];
        int rowToTest = currentRow;
        if (unlikely(synthState_->fullState.mainPage == 1)) {
            switch (currentRow) {
            case ROW_OSC2:
            case ROW_OSC3:
            case ROW_OSC4:
            case ROW_OSC5:
            case ROW_OSC6:
                rowToTest = ROW_OSC1;
                break;
            case ROW_ENV1_TIME:
            case ROW_ENV2_TIME:
            case ROW_ENV3_TIME:
            case ROW_ENV4_TIME:
            case ROW_ENV5_TIME:
            case ROW_ENV6_TIME: {
                int op = currentRow - ROW_ENV1_TIME;
                // This mean we used MENU + encoder, so some new value must not be displayed
                if (op != synthState_->fullState.operatorNumber) {
                    return;
                }
                refreshOscillatorOperatorEnvelope();
                rowToTest = ROW_ENV1_TIME;
                break;
            }
            case ROW_ENV1_LEVEL:
            case ROW_ENV2_LEVEL:
            case ROW_ENV3_LEVEL:
            case ROW_ENV4_LEVEL:
            case ROW_ENV5_LEVEL:
            case ROW_ENV6_LEVEL: {
                int op = currentRow - ROW_ENV1_LEVEL;
                // This mean we used MENU + encoder, so some new value must not be displayed
                if (op != synthState_->fullState.operatorNumber) {
                    return;
                }
                refreshOscillatorOperatorEnvelope();
                rowToTest = ROW_ENV1_LEVEL;
                break;
            }
            case ROW_ENV1_CURVE:
            case ROW_ENV2_CURVE:
            case ROW_ENV3_CURVE:
            case ROW_ENV4_CURVE:
            case ROW_ENV5_CURVE:
            case ROW_ENV6_CURVE: {
                int op = currentRow - ROW_ENV1_CURVE;
                if (op != synthState_->fullState.operatorNumber) {
                    return;
                }
                refreshOscillatorOperatorEnvelope();
                rowToTest = ROW_ENV1_CURVE;
            }
            }
        }
        if (rowToTest == rowEncoder.row && encoder == rowEncoder.encoder) {
            encoder6 = enc;
        }
    }
    // Can be called when new param value is received on Midi
    // So encoder6 can often be -1
    if (encoder6 != -1) {
        uint8_t x = getX(encoder6);

        tft_->setCursor(x, encoder6 > 2 ? LINE_PARAM_VALUE2 : LINE_PARAM_VALUE1);

        struct ParameterDisplay *param = &allParameterRows.row[currentRow]->params[encoder];

        // Special cases
        switch (currentRow) {
        case ROW_ENGINE:
            if (encoder == ENCODER_ENGINE_ALGO) {
                checkOperatorNumber();
                tft_->drawAlgo(newValue);
            }
            break;
        case ROW_LFOSEQ1:
        case ROW_LFOSEQ2:
            if (encoder > ENCODER_STEPSEQ_GATE) {
                updateStepSequencer(currentRow, encoder, oldValue, newValue);
                return;
            }
            break;
        case ROW_ARPEGGIATOR3:
            // special case arpegiattor user pattern
            updateArpPattern(currentRow, encoder, oldValue, newValue);
            return;
        case ROW_ARPEGGIATOR2:
            if (encoder == ENCODER_ARPEGGIATOR_PATTERN) {
                // Refresh pattern
                refreshStatus = 3;
            }
            break;
        case ROW_EFFECT1:
        case ROW_EFFECT2:
            if (encoder == ENCODER_EFFECT_TYPE) {
                resetHideParams();
                refreshStatus = 11;
            }
            break;
        case ROW_MODULATION1:
        case ROW_MODULATION3:
        case ROW_MODULATION2: {
            if (hideParam_[encoder6]) {
                return;
            }
            struct ModulationIndex im = modulationIndex[(int) synthState_->params->engine1.algo][encoder6];
            tft_->highlightIM(encoder6, im.source, im.destination);
            imChangedCounter_[encoder6] = 4;
            break;
        }
        case ROW_OSC_MIX1:
        case ROW_OSC_MIX3:
        case ROW_OSC_MIX2: {
            if (hideParam_[encoder6]) {
                return;
            }
            int mixNumber = (currentRow - ROW_OSC_MIX1) * 2 + ((encoder & 0x2) >> 1);
            int currentAlgo = (int) synthState_->params->engine1.algo;
            int operatorNumber = allAlgos[currentAlgo][mixNumber * 2 + 1] - 1;

            tft_->highlightOperator(operatorNumber);
            mixChangedCounter_[encoder6] = 4;
            mixChangeOperatorNumber_[encoder6] = operatorNumber;
            break;
        }
        case ROW_OSC1:
        case ROW_OSC2:
        case ROW_OSC3:
        case ROW_OSC4:
        case ROW_OSC5:
        case ROW_OSC6: {
            switch (encoder) {
            case ENCODER_OSC_SHAP:
                refreshOscillatorOperatorShape();
                break;
            case ENCODER_OSC_FTYPE:
                // Refresh Freq and Fine Tune
                refreshStatus = 10;
                break;
            case ENCODER_OSC_FREQ: {
                // Refresh Fine Tune
                struct OscillatorParams *opParams = &synthState_->params->osc1;
                if (opParams[synthState_->fullState.operatorNumber].frequencyType == OSC_FT_FIXE) {
                    refreshStatus = 9;
                }
                break;
            }
            case ENCODER_OSC_FTUNE: {
                // Refresh Fine Tune
                struct OscillatorParams *opParams = &synthState_->params->osc1;
                if (opParams[synthState_->fullState.operatorNumber].frequencyType == OSC_FT_FIXE) {
                    refreshStatus = 10;
                }
                break;
            }
            }
            break;
        }
        case ROW_LFOPHASES:
        case ROW_LFOOSC1:
        case ROW_LFOOSC2:
        case ROW_LFOOSC3: {
            refreshLfoOscillator();
            break;
        }
        case ROW_LFOENV1:
        case ROW_LFOENV2:
            refreshLfoEnv();
            break;
        }

        tft_->setCharBackgroundColor(COLOR_BLACK);
        if (!multipleEdition_) {
            tft_->setCharColor(COLOR_YELLOW);
        } else {
            tft_->setCharColor(COLOR_GREEN);
        }
        valueChangedCounter_[encoder6] = 4;
        updateEncoderValueWithoutCursor(currentRow, encoder, param, oldValue, newValue);
    }

}

void FMDisplayEditor::displayParamValue(int encoder, TFT_COLOR color) {
    const struct Pfm3EditMenu *editMenu = mainMenu.editMenu[synthState_->fullState.mainPage];
    const struct Pfm3OneButton *page = editMenu->pages[synthState_->fullState.editPage];
    uint8_t buttonState = synthState_->fullState.buttonState[page->buttonId];
    const struct RowEncoder rowEncoder = page->states[buttonState]->rowEncoder[encoder];

    uint8_t x = getX(encoder);

    tft_->setCursor(x, encoder > 2 ? LINE_PARAM_VALUE2 : LINE_PARAM_VALUE1);

    if (rowEncoder.encoder < ENCODER_INVISIBLE && !hideParam_[encoder]) {
        int row = rowEncoder.row;
        // Operator page
        if (synthState_->fullState.mainPage == 1) {
            row += synthState_->fullState.operatorNumber;
        }

        struct ParameterDisplay *param = &allParameterRows.row[row]->params[rowEncoder.encoder];
        float newValue = ((float*) synthState_->params)[row * NUMBER_OF_ENCODERS_PFM2 + rowEncoder.encoder];

        tft_->setCharBackgroundColor(COLOR_BLACK);
        tft_->setCharColor(color);
        updateEncoderValueWithoutCursor(row, rowEncoder.encoder, param, newValue, newValue);
    } else {
        if (hideParam_[encoder]) {
            tft_->print("     ");
        } else if (rowEncoder.encoder == ENCODER_MODULATOR_SYNC_LFO) {
            tft_->setCharBackgroundColor(COLOR_BLACK);
            tft_->setCharColor(color);
            struct LfoParams * lfoParams = &synthState_->params->lfoOsc1;
            int lfoButtonState = synthState_->fullState.buttonState[BUTTONID_EDIT_LFOS];
            tft_->print(lfoSyncParameterRow.params[0].valueName[lfoParams[lfoButtonState].freq < 100.0f ? 0 : 1]);
        } else if (rowEncoder.encoder == ENCODER_MODULATOR_SYNC_STEPS) {
            tft_->setCharBackgroundColor(COLOR_BLACK);
            tft_->setCharColor(color);
            struct StepSequencerParams * stepParams = &synthState_->params->lfoSeq1;
            int stepButtonState = synthState_->fullState.buttonState[BUTTONID_EDIT_STEPS];
            tft_->print(lfoSyncParameterRow.params[0].valueName[stepParams[stepButtonState].bpm < 240.5f ? 0 : 1]);
        }
    }
}

void FMDisplayEditor::refreshEditorByStep(int &refreshStatus, int &endRefreshStatus) {

    if (synthState_->fullState.mainPage == -1) {
        switch (refreshStatus) {
        case 20:
            tft_->pauseRefresh();
            tft_->clear();
            displayPreset();
            tft_->oscilloForceNextDisplay();
            break;
        case 19:
        case 18:
        case 17:
        case 16:
        case 15:
        case 14: {
            int button = 19 - refreshStatus;
            tft_->drawButton(mainMenu.editMenu[button]->mainMenuName, 270, 29, button, 0, 1);
            break;
        }
        case 13:
            tft_->setCursorInPixel(54, 60);
            tft_->print("E d i t o r", COLOR_CYAN, COLOR_BLACK);
            break;

        case 11:
//          tft->setCursorInPixel(5, 100);
//          tft->print("Choose button bellow", COLOR_DARK_BLUE, COLOR_BLACK);
            break;
        case 10:
            tft_->drawAlgo(synthState_->params->engine1.algo);
            break;
        }
    } else {
        const struct Pfm3EditMenu *editMenu = mainMenu.editMenu[synthState_->fullState.mainPage];
        const struct Pfm3OneButton *page = editMenu->pages[synthState_->fullState.editPage];

        switch (refreshStatus) {
        case 21:
            // 21 only when comming from newSynthMode...
            tft_->pauseRefresh();
            tft_->clear();
            displayPreset();
            tft_->oscilloForceNextDisplay();
            tft_->drawAlgo(synthState_->params->engine1.algo);
            break;
        case 20:
            tft_->pauseRefresh();
            tft_->fillArea(0, 40, 240, 120, COLOR_BLACK);
            tft_->fillArea(0, 270, 240, 30, COLOR_BLACK);
            tft_->setCursor(0, 2);
            tft_->setCharBackgroundColor(COLOR_BLACK);
            tft_->setCharColor(COLOR_CYAN);
            // OPerator page
            if (synthState_->fullState.mainPage == 1) {
                tft_->print("Op ");
                tft_->print(synthState_->fullState.operatorNumber + 1);
                tft_->print(" ");
                // Highlight operator in the algo schema
                tft_->clearAlgoFG();
                tft_->highlightOperator(synthState_->fullState.operatorNumber);
            }
            tft_->print(page->states[synthState_->fullState.buttonState[page->buttonId]]->stateLabel);
            resetHideParams();
            break;
        case 18:
        case 17:
        case 16:
        case 15:
        case 14:
        case 13: {
            int button = 18 - refreshStatus;

            if (unlikely(isInOperatorPage(synthState_->fullState.mainPage) && button >= 3 && button <= 5)) {
                tft_->drawButtonBiState(270, 29, button, synthState_->fullState.operatorNumber,
                    algoInformation[(int)synthState_->params->engine1.algo].osc - 1, synthState_->fullState.buttonState[BUTTONID_OPERATOR_1_2 + button - 3],
                    (button -3) * 2);
            } else if (isInMatrixPage(synthState_->fullState.mainPage)) {
                uint8_t currentSelection = synthState_->fullState.editPage * 2 + synthState_->fullState.buttonState[page->buttonId];
                tft_->drawButtonBiState(270, 29, button, currentSelection,
                    12, synthState_->fullState.buttonState[BUTTONID_MATRIX_1_2 + button],
                    button * 2);
            } else if (button < editMenu->numberOfButtons) {
                const struct Pfm3OneButton *buttonPage = editMenu->pages[button];
                tft_->drawButton(editMenu->pages[button]->buttonLabel, 270, 29, button, buttonPage->numberOfStates,
                    synthState_->fullState.editPage == button ?
                        synthState_->fullState.buttonState[page->buttonId] + 1 : 0);
            } else {
                tft_->drawButton("", 270, 29, button, 0, 0);
            }
            break;
        }
        case 12:
        case 11:
        case 10:
        case 9:
        case 8:
        case 7: {
            int button = 12 - refreshStatus;
            const struct RowEncoder rowEncoder =
                page->states[synthState_->fullState.buttonState[page->buttonId]]->rowEncoder[button];
            uint8_t x = getX(button);

            tft_->setCharBackgroundColor(COLOR_BLACK);
            tft_->setCharColor(COLOR_MEDIUM_GRAY);
            tft_->setCursor(x, button > 2 ? LINE_PARAM_NAME2 : LINE_PARAM_NAME1);

            if (rowEncoder.row != ROW_NONE) {
                const struct ParameterRowDisplay *paramRow = allParameterRows.row[rowEncoder.row];
                switch (rowEncoder.row) {
                case ROW_MODULATION1:
                case ROW_MODULATION2:
                case ROW_MODULATION3: {
                    struct ModulationIndex im = modulationIndex[(int) synthState_->params->engine1.algo][button];
                    if (im.source == 0) {
                        hideParam_[button] = true;
                    } else {
                        if (button < 5) {
                            tft_->print((int) im.source);
                            tft_->print('-');
                            tft_->print((int) im.destination);
                        } else {
                            tft_->print("Fdbk");
                        }
                    }
                }
                break;
                case ROW_OSC_MIX1:
                case ROW_OSC_MIX2:
                case ROW_OSC_MIX3: {
                    int mixNumber = (rowEncoder.row - ROW_OSC_MIX1) * 2 + ((rowEncoder.encoder & 0x2) >> 1);
                    int currentAlgo = (int) synthState_->params->engine1.algo;
                    int numberOfMix = algoInformation[currentAlgo].mix;

                    if (mixNumber < numberOfMix) {
                        // Let's display the operator number associated to the mix number
                        tft_->print(paramRow->paramName[rowEncoder.encoder]);

                        tft_->printSmallChar('(');
                        tft_->printSmallChar(allAlgos[currentAlgo][mixNumber * 2 + 1]);
                        tft_->printSmallChar(')');
                    } else {
                        tft_->setCharColor(COLOR_DARK_GRAY);
                        tft_->print(paramRow->paramName[rowEncoder.encoder]);
                        hideParam_[button] = true;    hideParam_[button] = true;
                    }
                }
                break;
                case ROW_EFFECT1:
                    if (rowEncoder.encoder > 0) {
                        int effect = synthState_->params->effect1.type;
                        if (fx1RowDisplay[effect].paramName[rowEncoder.encoder - 1] != NULL) {
                            tft_->print(fx1RowDisplay[effect].paramName[rowEncoder.encoder - 1]);
                        } else {
                            hideParam_[button] = true;
                            tft_->setCharColor(COLOR_DARK_GRAY);
                            tft_->print("None");
                        }
                    } else {
                        goto displayDefault;
                    }
                break;
                case ROW_EFFECT2:
                    if (rowEncoder.encoder > 0) {
                        int effect = synthState_->params->effect2.type;
                        if (fx2RowDisplay[effect].paramName[rowEncoder.encoder - 1] != NULL) {
                            tft_->print(fx2RowDisplay[effect].paramName[rowEncoder.encoder - 1]);
                        } else {
                            hideParam_[button] = true;
                            tft_->setCharColor(COLOR_DARK_GRAY);
                            tft_->print("None");
                        }
                    } else {
                        goto displayDefault;
                    }
                break;
                case ROW_ENGINE2:
                    if ((synthState_->params->engine1.playMode == PLAY_MODE_POLY && rowEncoder.encoder == ENCODER_ENGINE2_GLIDE_TYPE)
                        || (synthState_->params->engine1.playMode != PLAY_MODE_UNISON && rowEncoder.encoder >= ENCODER_ENGINE2_UNISON_SPREAD)) {
                        // Hide Engine2 GlideType if play mode poly
                        // and Engine2 Spread and Detune if play mode is not uison
                        hideParam_[button] = true;
                        tft_->setCharColor(COLOR_DARK_GRAY);
                        tft_->print(paramRow->paramName[rowEncoder.encoder]);
                    } else if (rowEncoder.row == ROW_ENGINE
                         && (synthState_->params->engine1.playMode == PLAY_MODE_POLY && rowEncoder.encoder == ENCODER_ENGINE_GLIDE_SPEED)) {
                        // Hide Ending1 GlideSpeed if play mode poly
                        hideParam_[button] = true;
                        tft_->setCharColor(COLOR_DARK_GRAY);
                        tft_->print(paramRow->paramName[rowEncoder.encoder]);
                    } else {
                        goto displayDefault;
                    }
                break;
                default:
                    displayDefault:
                    tft_->print(paramRow->paramName[rowEncoder.encoder]);
                }
            } else {
                // Special case
                if (rowEncoder.encoder >= ENCODER_MODULATOR_SYNC_LFO) {
                    tft_->print(lfoSyncParameterRow.paramName[0]);
                }
            }
            break;
        }
        case 6:
        case 5:
        case 4:
        case 3:
        case 2:
        case 1: {
            displayParamValue(6 - refreshStatus, COLOR_WHITE);
            break;
        }
        }
    }
    if (refreshStatus == endRefreshStatus) {
        endRefreshStatus = 0;
        refreshStatus = 0;
    }

}

void FMDisplayEditor::resetHideParams() {
    for (int h = 0; h < 6; h++) {
        hideParam_[h] = false;
    }
}

void FMDisplayEditor::tempoClick() {
    static float lastVolume, lastGainReduction;

    for (int e = 0; e < NUMBER_OF_ENCODERS; e++) {
        if (valueChangedCounter_[e] > 0) {
            valueChangedCounter_[e]--;
            if (valueChangedCounter_[e] == 0) {
                if (synthState_->fullState.mainPage != -1) {
                    tft_->setCharBackgroundColor(COLOR_BLACK);
                    displayParamValue(e, COLOR_WHITE);
                }
            }
        }
        if (imChangedCounter_[e] > 0) {
            imChangedCounter_[e]--;
            if (imChangedCounter_[e] == 0) {
                struct ModulationIndex im = modulationIndex[(int) synthState_->params->engine1.algo][e];
                tft_->eraseHighlightIM(e, im.source, im.destination);
            }
        }
        if (mixChangedCounter_[e] > 0) {
            mixChangedCounter_[e]--;
            if (mixChangedCounter_[e] == 0) {
                tft_->eraseHighlightOperator(mixChangeOperatorNumber_[e]);
            }
        }
    }

    if (synthState_->mixerState.levelMeterWhere_ == 2) {
        float volume = getCompInstrumentVolume(currentTimbre_);
        float gr = getCompInstrumentGainReduction(currentTimbre_);
        // gr tend to slower reach 0
        // Let'as accelerate when we don't want to draw the metter anymore
        if (gr > -.1f) {
            gr = 0;
        }
        if (volume != lastVolume || gr != lastGainReduction) {
            lastVolume = volume;
            lastGainReduction = gr;

            bool isCompressed = synthState_->mixerState.instrumentState_[currentTimbre_].compressorType > 0;
            tft_->drawLevelMetter(5, 150, 230, 3, 5, volume, isCompressed, gr);
        }
    }
}

void FMDisplayEditor::displayPreset() {

    tft_->fillArea(0, 0, 240, 21, COLOR_DARK_BLUE);

    tft_->setCharBackgroundColor(COLOR_DARK_BLUE);
    tft_->setCharColor(COLOR_YELLOW);
    tft_->setCursorInPixel(2, 2);
    if (synthState_->getIsPlayingNote()) {
        tft_->print('~');
    } else {
        tft_->print('I');
    }
    tft_->print((char) ('0' + currentTimbre_ + 1));
    tft_->print(' ');
    tft_->setCharColor(COLOR_WHITE);
    tft_->print(synthState_->params->presetName);
    tft_->setCharColor(COLOR_YELLOW);
    if (presetModifed_[currentTimbre_]) {
        tft_->print('*');
    }
    tft_->setCharBackgroundColor(COLOR_BLACK);
}

void FMDisplayEditor::resetAllPresetModified() {
    for (int k = 0; k < NUMBER_OF_TIMBRES; k++) {
        presetModifed_[k] = false;
    }
}

void FMDisplayEditor::setPresetModified(int timbre, bool state) {
    presetModifed_[timbre] = state;
}

void FMDisplayEditor::updateArpPattern(int currentRow, int encoder, int oldValue, int newValue) {

    const int index = (int) synthState_->params->engineArp2.pattern - ARPEGGIATOR_PRESET_PATTERN_COUNT;
    const arp_pattern_t user_pattern = synthState_->params->engineArpUserPatterns.patterns[index];

    if (synthState_->params->engineArp2.pattern < ARPEGGIATOR_PRESET_PATTERN_COUNT) {
        return;
    }

    if (encoder == 1) {
        // new value to display
        tft_->setCharColor(COLOR_YELLOW);
        tft_->setCursor(synthState_->patternSelect, 6);
        tft_->print((char) (127 + ((newValue >> (synthState_->patternSelect)) & 0x1) * 15));
    } else if (encoder == 0) {
        if ((oldValue % 4) == 0) {
            tft_->setCharColor(COLOR_WHITE);
        } else {
            tft_->setCharColor(COLOR_GRAY);
        }
        tft_->setCursor(oldValue, 6);
        tft_->print((char) (127 + ((user_pattern >> (oldValue)) & 0x1) * 15));
        tft_->setCharColor(COLOR_YELLOW);
        tft_->setCursor(newValue, 6);
        tft_->print((char) (127 + ((user_pattern >> (newValue)) & 0x1) * 15));
    }
}

void FMDisplayEditor::updateStepSequencer(int currentRow, int encoder, int oldValue, int newValue) {
    int whichStepSeq = currentRow - ROW_LFOSEQ1;

    StepSequencerSteps *seqSteps = &((StepSequencerSteps*) (&synthState_->params->lfoSteps1))[whichStepSeq];

    tft_->setCharBackgroundColor(COLOR_BLACK);

    if (encoder == 3) {
        // new value to display
        tft_->setCharColor(COLOR_YELLOW);
        tft_->setCursor(synthState_->stepSelect[whichStepSeq], 6);
        tft_->print((char) (127 + newValue));
    } else if (encoder == 2) {
        if ((oldValue % 4) == 0) {
            tft_->setCharColor(COLOR_WHITE);
        } else {
            tft_->setCharColor(COLOR_GRAY);
        }
        tft_->setCursor(oldValue, 6);
        tft_->print((char) (127 + seqSteps->steps[oldValue]));
        tft_->setCharColor(COLOR_YELLOW);
        tft_->setCursor(newValue, 6);
        tft_->print((char) (127 + seqSteps->steps[newValue]));
    }
}

void FMDisplayEditor::updateEncoderValueWithoutCursor(int row, int encoder, ParameterDisplay *param,
    float oldValue, float newFloatValue) {

    int newValue = (int) newFloatValue;

    switch (param->displayType) {
    case DISPLAY_TYPE_STRINGS:

    	// Special case for play mode (mono, poly, unis)
        if (likely(param->valueName != polyMonoNames)) {
        	tft_->print(param->valueName[newValue]);
        } else {
        	// Display color error information
        	if (synthState_->mixerState.MPE_inst1_ > 0 && newValue != 1) {
                tft_->setCharColor(COLOR_RED);
            }
            tft_->print(param->valueName[newValue]);
            int numberOfVoices = synthState_->mixerState.instrumentState_[currentTimbre_].numberOfVoices;
            if (numberOfVoices == 0 || (newValue == 1 && numberOfVoices == 1)
                || (newValue == 0 && numberOfVoices > 1) || (newValue == 2 && numberOfVoices == 1)) {
                tft_->setCharColor(COLOR_RED);
            } else {
                tft_->setCharColor(COLOR_GRAY);
            }
            tft_->print("(");
            tft_->print(numberOfVoices);
            tft_->print(')');
        }
        break;
    case DISPLAY_TYPE_FLOAT_LFO_FREQUENCY:
        if (newFloatValue * 10.0f > LFO_FREQ_MAX_TIMES_10) {

            int stringIndex = newFloatValue * 10.0f + .005f;
            tft_->print(' ');
            tft_->print(lfoOscMidiClock[stringIndex - LFO_FREQ_MAX_TIMES_10 - 1]);

            if (oldValue * 10.0f <= ((float)LFO_FREQ_MAX_TIMES_10) + .5f) {
                // Update Sync : Second button in the page
                displayParamValue(1, COLOR_WHITE);
            }
        } else {
            tft_->printFloatWithSpace(newFloatValue);
            if (oldValue * 10.0f > LFO_FREQ_MAX_TIMES_10) {
                // Update Sync : Second button in the page
                displayParamValue(1, COLOR_WHITE);
            }
        }
        break;
    case DISPLAY_TYPE_STEP_SEQ_BPM:
        if (newValue > 240.5f) {
            tft_->print(lfoSeqMidiClock[newValue - 241]);
            if (oldValue < 240.5f) {
                // Update Sync : Second button in the page
                displayParamValue(0, COLOR_WHITE);
            }
        } else {
            tft_->printValueWithSpace(newValue);
            if (oldValue > 240.5f) {
                // Update Sync : Second button in the page
                displayParamValue(0, COLOR_WHITE);
            }
        }
        break;
    case DISPLAY_TYPE_LFO_KSYN:
        if (unlikely(newFloatValue < 0.0f)) {
            tft_->print(" Off ");
            break;
        }
        tft_->printFloatWithSpace(newFloatValue);
        break;
    case DISPLAY_TYPE_FLOAT:
        tft_->printFloatWithSpace(newFloatValue);
        break;
        // else what follows
    case DISPLAY_TYPE_INT:
        tft_->printValueWithSpace(newValue);
        break;
    case DISPLAY_TYPE_FLOAT_OSC_FREQUENCY: {
        // Hack... to deal with the special case of the fixed frequency.....
        int oRow = row - ROW_OSC_FIRST;
        OscillatorParams *oParam = (OscillatorParams*) &synthState_->params->osc1;
        OscFrequencyType ft = (OscFrequencyType) oParam[oRow].frequencyType;

        if (ft == OSC_FT_FIXE) {
            newValue = oParam[oRow].frequencyMul * 1000.0 + oParam[oRow].detune * 100;
            if (newValue < 0) {
                newValue = 0;
            }
            tft_->print(newValue);
            if (newValue < 10000) {
                tft_->print(' ');
            }
            if (newValue < 1000) {
                tft_->print(' ');
            }
            if (newValue < 100) {
                tft_->print(' ');
            }
            if (newValue < 10) {
                tft_->print(' ');
            }
        } else {
            tft_->printFloatWithSpace(newFloatValue);
        }
        break;
    }
    case DISPLAY_TYPE_NONE:
        tft_->print("    ");
        break;
    case DISPLAY_TYPE_STEP_SEQ2:
    case DISPLAY_TYPE_STEP_SEQ1: {
        // Display the steps only once
        if (encoder == 2) {
            int whichStepSeq = row - ROW_LFOSEQ1;
            StepSequencerSteps *seqSteps = &((StepSequencerSteps*) (&synthState_->params->lfoSteps1))[whichStepSeq];

            tft_->setCharBackgroundColor(COLOR_BLACK);
            for (int k = 0; k < 16; k++) {
                if (synthState_->stepSelect[whichStepSeq] == k) {
                    tft_->setCharColor(COLOR_YELLOW);
                } else if ((k % 4) == 0) {
                    tft_->setCharColor(COLOR_WHITE);
                } else {
                    tft_->setCharColor(COLOR_GRAY);
                }
                tft_->print((char) (127 + seqSteps->steps[k]));
            }
        }
    }
        break;
    case DISPLAY_TYPE_ARP_PATTERN: {
        // Display the steps only once
        if (encoder == 0) {

            const int index = (int) synthState_->params->engineArp2.pattern;
            arp_pattern_t user_pattern;
            bool editable = false;

            if (synthState_->params->engineArp2.pattern >= ARPEGGIATOR_PRESET_PATTERN_COUNT) {
                user_pattern = synthState_->params->engineArpUserPatterns.patterns[index
                    - ARPEGGIATOR_PRESET_PATTERN_COUNT];
                editable = true;
            } else {
                user_pattern = lut_res_arpeggiator_patterns[index];
            }

            tft_->setCharBackgroundColor(COLOR_BLACK);
            for (int k = 0; k < 16; k++) {
                bool stepOn = ((user_pattern >> (k)) & 0x1) > 0;
                if (synthState_->patternSelect == k && editable) {
                    tft_->setCharColor(COLOR_YELLOW);
                } else if ((k % 4) == 0) {
                    tft_->setCharColor(COLOR_WHITE);
                } else {
                    tft_->setCharColor(COLOR_GRAY);
                }
                tft_->print((char) (127 + (stepOn ? 15 : 0)));
            }

        }
    }
        break;
    }

    tft_->setCharColor(COLOR_WHITE);

}

void FMDisplayEditor::encoderTurnedPfm3(int encoder6, int ticks) {
    struct FullState *fullState = &(synthState_->fullState);

    if (unlikely(fullState->mainPage == -1)) {
        return;
    }

    // Convert to legacy preenfm2 encoder and row
    const struct Pfm3EditMenu *editMenu = mainMenu.editMenu[synthState_->fullState.mainPage];
    const struct Pfm3OneButton *page = editMenu->pages[synthState_->fullState.editPage];
    const struct RowEncoder rowEncoder =
        page->states[synthState_->fullState.buttonState[page->buttonId]]->rowEncoder[encoder6];

    int encoder4 = rowEncoder.encoder;
    int row = rowEncoder.row;

    // Step sequencer special case
    if (unlikely(row == ROW_LFOSEQ1 || row == ROW_LFOSEQ2)) {
        if (encoder4 >= 2) {
            synthState_->encoderTurnedForStepSequencer(row, encoder4, encoder6, ticks);
            return;
        }
    };

    encoderTurnedPfm2(row, encoder4, ticks);
}

int FMDisplayEditor::getEditPageMultiplier() {
    const struct Pfm3EditMenu *editMenu = mainMenu.editMenu[synthState_->fullState.mainPage];
    const struct Pfm3OneButton *page = editMenu->pages[synthState_->fullState.editPage];
    uint8_t buttonState = synthState_->fullState.buttonState[page->buttonId];
    int multiplier = synthState_->fullState.editPage == 0 ? 1 : 2;
    if(synthState_->fullState.editPage == 1  && buttonState == 1) {
        // env curve page
        multiplier = 1;
    }
    return multiplier;
}

/*
 * In some case we want to shortcut the Operator row calculation case
 * so we need  specialOpCase = false
 */
void FMDisplayEditor::encoderTurnedPfm2(int row, int encoder4, int ticks, bool specialOpCase) {

    // SYNC_LFO & SYNC_STEPS are 2 special case
    if (unlikely(row == ROW_NONE && encoder4 < ENCODER_MODULATOR_SYNC_LFO)) {
        return;
    }
    if (unlikely(row == ROW_ARPEGGIATOR3)) {
        synthState_->encoderTurnedForArpPattern(row, encoder4, ticks);
        return;
    }

    //
    int num;
    struct ParameterDisplay *param;
    if (unlikely(synthState_->fullState.mainPage == 1) && specialOpCase) {
        // operator is a bit different with PFM3
        num = encoder4 + (row + synthState_->fullState.operatorNumber) * NUMBER_OF_ENCODERS_PFM2;
        param = &(allParameterRows.row[row + synthState_->fullState.operatorNumber]->params[encoder4]);
        row += synthState_->fullState.operatorNumber;
    } else if (unlikely(encoder4 == ENCODER_MODULATOR_SYNC_LFO)) {
        // Simulate we're Osc freq
        int lfoButtonState = synthState_->fullState.buttonState[BUTTONID_EDIT_LFOS];

        row =  ROW_LFOOSC1 + lfoButtonState;
        encoder4 = ENCODER_LFO_FREQ;
        num = encoder4 + row * NUMBER_OF_ENCODERS_PFM2;
        param = &(allParameterRows.row[row]->params[encoder4]);

        // Block if necessary
        if ((ticks > 0 && ((float*) synthState_->params)[num] > 99.95f)
            || (ticks < 0 && ((float*) synthState_->params)[num] < 99.95f)) {
            return;
        }

        float freqToSet;
        if (lfoFreqPreviousValue[lfoButtonState] == -1.0f) {
            freqToSet = ticks > 0 ? 100.4f : 2.0f;
        } else {
            freqToSet = lfoFreqPreviousValue[lfoButtonState];
            // User arrive in Ext/Int area with Freq encoder ?
            if (ticks < 0 && freqToSet > 99.95f) {
                freqToSet = 99.9f;
            } else if (ticks > 0 && freqToSet < 99.95f) {
                freqToSet = 100.0f;
            }
        }
        lfoFreqPreviousValue[lfoButtonState] = ((float*) synthState_->params)[num];

        if (ticks > 0) {
            ticks = 20;
            ((float*) synthState_->params)[num] = freqToSet - .1f * ticks;
        } else {
            ticks = - 1000;
            ((float*) synthState_->params)[num] = freqToSet - .1f * ticks;
        }
    } else  if (unlikely(encoder4 == ENCODER_MODULATOR_SYNC_STEPS)) {
        // Simulate we're Osc freq
        int stepButtonState = synthState_->fullState.buttonState[BUTTONID_EDIT_STEPS];

        row =  ROW_LFOSEQ1 + stepButtonState;
        encoder4 = ENCODER_STEPSEQ_BPM;
        num = encoder4 + row * NUMBER_OF_ENCODERS_PFM2;
        param = &(allParameterRows.row[row]->params[encoder4]);

        // Block if necessary
        if ((ticks > 0 && ((float*) synthState_->params)[num] > 240.5f)
            || (ticks < 0 && ((float*) synthState_->params)[num] < 240.5f)) {
            return;
        }

        float bpmToSet;
        if (lfoFreqPreviousValue[3 + stepButtonState] == -1.0f) {
            bpmToSet = ticks > 0 ? 243.0f : 120.0f;
        } else {
            bpmToSet = lfoFreqPreviousValue[3 + stepButtonState];
            // User arrive in Ext/Int area with BPM encoder ?
            if (ticks < 0 && bpmToSet > 240.5f) {
                bpmToSet = 240.0f;
            } else if (ticks > 0 && bpmToSet < 240.5f) {
                bpmToSet = 241.0f;
            }
        }
        lfoFreqPreviousValue[3 + stepButtonState] = ((float*) synthState_->params)[num];

        if (ticks > 0) {
            ticks = 50;
            ((float*) synthState_->params)[num] = bpmToSet -  ticks;
        } else {
            ticks = -240;
            ((float*) synthState_->params)[num] = bpmToSet -  ticks;
        }
    } else {
        num = encoder4 + row * NUMBER_OF_ENCODERS_PFM2;
        param = &(allParameterRows.row[row]->params[encoder4]);
    }
    float newValue;
    float oldValue;

    if (param->displayType == DISPLAY_TYPE_STRINGS) {
        // Do not use encoder acceleration
        ticks = ticks > 0 ? 1 : -1;
    }

    if (param->valueNameOrder == NULL) {
        // Not string parameters

        // floating point test to be sure numberOfValues is different from 1.
        // for voices when number of voices forced to 0
        if (param->numberOfValues < 1.5) {
            return;
        }

        float &value = ((float*) synthState_->params)[num];
        oldValue = value;

        float inc = param->incValue;

        // Slow down LFO frequency
        if (unlikely(param->displayType == DISPLAY_TYPE_FLOAT_LFO_FREQUENCY)) {
            if (oldValue < 1.0f) {
                inc = inc * .1f;
            }
        }

        int tickIndex = (value - param->minValue) / inc + .0005f + ticks;
        newValue = param->minValue + tickIndex * inc;

        if (newValue > param->maxValue) {
            newValue = param->maxValue;
        }
        if (newValue < param->minValue) {
            newValue = param->minValue;
        }
        value = newValue;
    } else {
        float *value = &((float*) synthState_->params)[num];
        newValue = oldValue = (*value);

        // Must use newValue (int) so that the minValue comparaison works
        // Is there any other order than the default one
        int pos = param->valueNameOrderReversed[(int) (*value)];

        if (ticks > 0 && pos < param->maxValue) {
            newValue = param->valueNameOrder[pos + 1];
        }
        if (ticks < 0 && pos > param->minValue) {
            newValue = param->valueNameOrder[pos - 1];
        }

        (*value) = (float) newValue;
    }
    if (newValue != oldValue) {
        synthState_->propagateNewParamValue(currentTimbre_, row, encoder4, param, oldValue, newValue);
    }

}

void FMDisplayEditor::encoderTurnedWhileButtonPressed(int encoder6, int ticks, int button) {

    // SYNTH_MODE_EDIT
    switch (button) {
    case BUTTON_PREVIOUS_INSTRUMENT: {
        // Convert to legacy preenfm2 encoder and row
        const struct Pfm3EditMenu *editMenu = mainMenu.editMenu[synthState_->fullState.mainPage];
        const struct Pfm3OneButton *page = editMenu->pages[synthState_->fullState.editPage];
        struct RowEncoder rowEncoder =
            page->states[synthState_->fullState.buttonState[page->buttonId]]->rowEncoder[encoder6];

        // Operator is a special case for row
        if (unlikely(synthState_->fullState.mainPage == 1)) {
            rowEncoder.row += synthState_->fullState.operatorNumber;
        }

        struct ParameterDisplay *param = &(allParameterRows.row[rowEncoder.row]->params[rowEncoder.encoder]);
        const struct OneSynthParams *defaultParams = &defaultPreset;
        int num = rowEncoder.encoder + rowEncoder.row * NUMBER_OF_ENCODERS_PFM2;

        float *value = &((float*) synthState_->params)[num];
        float oldValue = *value;
        float newValue = ((float*) defaultParams)[num];
        (*value) = newValue;

        synthState_->propagateNewParamValue(currentTimbre_, rowEncoder.row, rowEncoder.encoder, param, oldValue,
            newValue);
        break;
    }
    case BUTTON_PFM3_MENU:
    {

        // All update must be in green
        multipleEdition_ = true;

        // Convert to legacy preenfm2 encoder and row
        const struct Pfm3EditMenu *editMenu = mainMenu.editMenu[synthState_->fullState.mainPage];
        const struct Pfm3OneButton *page = editMenu->pages[synthState_->fullState.editPage];

        struct RowEncoder rowEncoder =
            page->states[synthState_->fullState.buttonState[page->buttonId]]->rowEncoder[encoder6];

        // Operator is a special case for row
        if (unlikely(synthState_->fullState.mainPage == 1)) {
            rowEncoder.row += synthState_->fullState.operatorNumber;
        }

        int row = rowEncoder.row;
        int encoder4 = rowEncoder.encoder;

        // Modify param of all operator of same types.
        if (row >= ROW_ENV_FIRST && row <= ROW_ENV_LAST) {
            int firstRow = ROW_ENV1_TIME;
            if (row >= ROW_ENV1_LEVEL) {
                firstRow = ROW_ENV1_LEVEL;
            }
            int currentAlgo = (int)synthState_->params->engine1.algo;
            int currentOpType = algoOpInformation[currentAlgo][(row - firstRow)];

            for (int op = 0; op < NUMBER_OF_OPERATORS; op++) {
                if (currentOpType == algoOpInformation[currentAlgo][op]) {
                    // Same operator type : carrier or modulation
                    encoderTurnedPfm2(firstRow + op, encoder4, ticks, false);
                }
            }
        } else if (row >= ROW_MODULATION1 && row <= ROW_MODULATION3) {
            int imMax = algoInformation[(int)synthState_->params->engine1.algo].im;
            // Im or v ?
            if ((encoder4 & 0x1) == 0) {
                for (int m = 0; m < imMax; m++) {
                    encoderTurnedPfm2(ROW_MODULATION1 + (m >> 1), ENCODER_ENGINE_IM1 + (m & 0x1) * 2, ticks);
                }
            } else {
                for (int m = 0; m < imMax; m++) {
                    encoderTurnedPfm2(ROW_MODULATION1 + (m >> 1), ENCODER_ENGINE_IM1_VELOCITY + (m & 0x1) * 2, ticks);
                }
            }
        } else if (row >= ROW_OSC_MIX1 && row <= ROW_OSC_MIX3) {
            // Mix or Pan ?
            int algoNumber = (int)synthState_->params->engine1.algo;
            if ((encoder4 & 0x1) == 0) {
                for (int m = 0; m < NUMBER_OF_OPERATORS; m++) {
                    if (algoOpInformation[algoNumber][m] == 1) {
                        encoderTurnedPfm2(ROW_OSC_MIX1 + (m >> 1), ENCODER_ENGINE_MIX1 + (m & 0x1) * 2, ticks);
                    }
                }
            } else {
                for (int m = 0; m < NUMBER_OF_OPERATORS; m++) {
                    if (algoOpInformation[algoNumber][m] == 1) {
                        encoderTurnedPfm2(ROW_OSC_MIX1 + (m >> 1), ENCODER_ENGINE_PAN1 + (m & 0x1) * 2, ticks);
                    }
                }
            }
        }

        // End of multiple edition
        multipleEdition_ = false;

        break;
    }
    }

}

void FMDisplayEditor::buttonPressed(int button) {
    if (synthState_->fullState.mainPage == -1) {
        if (button >= BUTTON_PFM3_1 && button <= BUTTON_PFM3_6) {
            synthState_->fullState.mainPage = button;
            synthState_->fullState.editPage = editPageSelected_[synthState_->fullState.mainPage];
         }
    } else {
        switch (button) {
        case BUTTON_PFM3_EDIT:
        case BUTTON_PFM3_MENU:
            synthState_->fullState.mainPage = -1;
            break;
        case BUTTON_PFM3_1:
        case BUTTON_PFM3_2:
        case BUTTON_PFM3_3:
        case BUTTON_PFM3_4:
        case BUTTON_PFM3_5:
        case BUTTON_PFM3_6:
            const struct Pfm3EditMenu *editMenu = mainMenu.editMenu[synthState_->fullState.mainPage];
            const struct Pfm3OneButton *page = editMenu->pages[synthState_->fullState.editPage];
            if (button >= editMenu->numberOfButtons) {
                break;
            }
            if (unlikely(isInOperatorPage(synthState_->fullState.mainPage) && button >= BUTTON_PFM3_4 && button <= BUTTON_PFM3_6)) {
                // Operator page : button 4 to 6 change the current operator
                uint8_t buttonSelected = (button - BUTTON_PFM3_4);
                uint8_t currentButton = synthState_->fullState.operatorNumber >> 1;
                int buttonId = BUTTONID_OPERATOR_1_2 + buttonSelected;

                uint8_t newButtonState = synthState_->fullState.buttonState[buttonId];
                if (buttonSelected == currentButton) {
                    newButtonState = (newButtonState + 1) & 0x1;
                }
                uint8_t numberOfOsc = algoInformation[(int)synthState_->params->engine1.algo].osc - 1;
                uint8_t newOperatorSelect = buttonSelected * 2 + newButtonState;
                if (newOperatorSelect <= numberOfOsc) {
                    synthState_->fullState.operatorNumber =  newOperatorSelect;
                    synthState_->fullState.buttonState[buttonId] = newButtonState;
                } else {
                    return;
                }
            } else if (synthState_->fullState.editPage == button) {
                if (page->numberOfStates > 0) {
                    synthState_->fullState.buttonState[page->buttonId] =
                        (synthState_->fullState.buttonState[page->buttonId] + 1) % page->numberOfStates;
                }
            } else {
                // If new page has no state.. then we don't activate it
                if (editMenu->pages[button]->numberOfStates > 0) {
                    // save what editPage is selected in current mainPage
                    editPageSelected_[synthState_->fullState.mainPage] = button;

                    synthState_->fullState.editPage = button;
                }
            }
            break;
        }
    }

    synthState_->propagateNewPfm3Page();
}


void FMDisplayEditor::displayPopup(TFT_COLOR color, char* text, uint8_t length) {
    tft_->fillArea(60, 66, 120, 36, color);
    tft_->fillArea(62, 68, 116, 32, COLOR_BLACK);
    tft_->setCharBackgroundColor(COLOR_BLACK);
    tft_->setCharColor(color);
    tft_->setCursorInPixel(119 - ((length * 11) / 2), 75);
    tft_->print(text);
    tft_->waitCycle(500);
    synthState_->propagateNewPfm3Page();
}

void FMDisplayEditor::buttonLongPressed(int instrument, int button) {
    if (button == BUTTON_PREVIOUS_INSTRUMENT) {
        // Can be copied ?
        bool canBeCopied = isInMatrixPage(synthState_->fullState.mainPage) || isInOperatorPage(synthState_->fullState.mainPage) || (isInModulatorPage(synthState_->fullState.mainPage) && synthState_->fullState.editPage == 0);

        if (canBeCopied) {
            bufferPageNumber = synthState_->fullState.mainPage;
            bufferEditNumber = synthState_->fullState.editPage;

            const struct Pfm3EditMenu *editMenu = mainMenu.editMenu[synthState_->fullState.mainPage];
            const struct Pfm3OneButton *page = editMenu->pages[synthState_->fullState.editPage];
            if (isInOperatorPage(synthState_->fullState.mainPage) && synthState_->fullState.editPage != 0) {
                // Env : we only store the op number.
                // We'll copy time, level and shape
                bufferParam[0] =  synthState_->fullState.operatorNumber;
                displayPopup(COLOR_GREEN, "Copy Env", 8);
            } else {
                for (int e = 0; e < 6; e++) {
                    const struct RowEncoder rowEncoder =
                            page->states[synthState_->fullState.buttonState[page->buttonId]]->rowEncoder[e];
                    int row = rowEncoder.row;
                    if (row != ROW_NONE) {
                        int encoder4 = rowEncoder.encoder;
                        if (isInOperatorPage(synthState_->fullState.mainPage)) {
                            row += synthState_->fullState.operatorNumber;
                        }
                        int num = encoder4 + row * NUMBER_OF_ENCODERS_PFM2;
                        bufferParam[e] = ((float*) synthState_->params)[num];
                    }
                }
                if (isInMatrixPage(synthState_->fullState.mainPage)) {
                    displayPopup(COLOR_GREEN, "Copy Mtx", 8);
                } else if (isInOperatorPage(synthState_->fullState.mainPage)) {
                    displayPopup(COLOR_GREEN, "Copy Osc", 8);
                } else {
                    // LFO
                    displayPopup(COLOR_GREEN, "Copy LFO", 8);
                }
            }
        }
    } else if (button == BUTTON_NEXT_INSTRUMENT) {
        // Can be pasted ?
        bool canBePasted = isInMatrixPage(synthState_->fullState.mainPage) && isInMatrixPage(bufferPageNumber);
        // Operator Osc
        canBePasted |= isInOperatorPage(synthState_->fullState.mainPage) && isInOperatorPage(bufferPageNumber) && bufferEditNumber == 0 && synthState_->fullState.editPage == 0;
        // Operator Env
        canBePasted |= isInOperatorPage(synthState_->fullState.mainPage) && isInOperatorPage(bufferPageNumber) && bufferEditNumber != 0 && synthState_->fullState.editPage != 0;
        // LFO
        canBePasted |= isInModulatorPage(synthState_->fullState.mainPage) && isInModulatorPage(bufferPageNumber) && synthState_->fullState.editPage == 0;

        if (canBePasted) {
            const struct Pfm3EditMenu *editMenu = mainMenu.editMenu[synthState_->fullState.mainPage];
            const struct Pfm3OneButton *page = editMenu->pages[synthState_->fullState.editPage];
            if (isInOperatorPage(synthState_->fullState.mainPage) && synthState_->fullState.editPage != 0) {
                if (bufferParam[0] != synthState_->fullState.operatorNumber) {
                    uint8_t opNum = bufferParam[0];
                    float* timeSource = (float*) (((EnvelopeTimeMemory *)&synthState_->params->env1Time) + opNum);
                    float* timeDest =  (float*) (((EnvelopeTimeMemory *)&synthState_->params->env1Time) + synthState_->fullState.operatorNumber);
                    for (int i = 0; i < 4; i++) {
                        timeDest[i] = timeSource[i];
                    }
                    float* levelSource = (float*) (((EnvelopeLevelMemory *)&synthState_->params->env1Level) + opNum);
                    float* levelDest =  (float*) (((EnvelopeLevelMemory *)&synthState_->params->env1Level) + synthState_->fullState.operatorNumber);
                    for (int i = 0; i < 4; i++) {
                        levelDest[i] = levelSource[i];
                    }
                    float* curveSource = (float*) (((EnvelopeCurveParams *)&synthState_->params->env1Curve) + opNum);
                    float* curveDest =  (float*) (((EnvelopeCurveParams *)&synthState_->params->env1Curve) + synthState_->fullState.operatorNumber);
                    for (int i = 0; i < 4; i++) {
                        curveDest[i] = curveSource[i];
                    }
                }
                displayPopup(COLOR_GREEN, "Paste Env", 9);
            } else {
                for (int e = 0; e < 6; e++) {
                    const struct RowEncoder rowEncoder =
                            page->states[synthState_->fullState.buttonState[page->buttonId]]->rowEncoder[e];
                    int row = rowEncoder.row;
                    if (row != ROW_NONE) {
                        int encoder4 = rowEncoder.encoder;
                        if (isInOperatorPage(synthState_->fullState.mainPage)) {
                            row += synthState_->fullState.operatorNumber;
                        }
                        int num = encoder4 + row * NUMBER_OF_ENCODERS_PFM2;
                        ((float*) synthState_->params)[num] = bufferParam[e];
                    }
                }
                if (isInMatrixPage(synthState_->fullState.mainPage)) {
                    displayPopup(COLOR_GREEN, "Paste Mtx", 9);
                } else if (isInOperatorPage(synthState_->fullState.mainPage)) {
                    displayPopup(COLOR_GREEN, "Paste Osc", 9);
                } else {
                    // LFO
                    displayPopup(COLOR_GREEN, "Paste LFO", 9);
                }
            }
        } else {
            displayPopup(COLOR_RED, "Cannot", 6);
        }
    }
}


bool FMDisplayEditor::isInOperatorPage(uint8_t pageNumber) {
    return pageNumber == 1;
}

bool FMDisplayEditor::isInMatrixPage(uint8_t pageNumber) {
    return pageNumber == 2;
}

bool FMDisplayEditor::isInModulatorPage(uint8_t pageNumber) {
    return pageNumber == 3;
}

void FMDisplayEditor::refreshOscillatorOperatorShape() {
    int op = synthState_->fullState.operatorNumber;
    OscillatorParams *oscillatorParams = &synthState_->params->osc1;

    tft_->oscilloBgActionOperatorShape((int) oscillatorParams[op].shape);
}

void FMDisplayEditor::refreshOscillatorOperatorEnvelope() {
    int op = synthState_->fullState.operatorNumber;
    EnvelopeTimeMemory *envTime = &synthState_->params->env1Time;
    EnvelopeLevelMemory *envLevel = &synthState_->params->env1Level;
    EnvelopeCurveParams *envCurve = &synthState_->params->env1Curve;
    tft_->oscilloBgSetEnvelope(envTime[op].attackTime, envTime[op].decayTime, envTime[op].sustainTime, envTime[op].releaseTime,
            envLevel[op].attackLevel, envLevel[op].decayLevel, envLevel[op].sustainLevel, envLevel[op].releaseLevel,
            envCurve[op].attackCurve, envCurve[op].decayCurve, envCurve[op].sustainCurve, envCurve[op].releaseCurve);
    tft_->oscilloBgActionEnvelope();
}

void FMDisplayEditor::refreshLfoOscillator() {
    const struct Pfm3EditMenu *editMenu = mainMenu.editMenu[synthState_->fullState.mainPage];
    const struct Pfm3OneButton *page = editMenu->pages[synthState_->fullState.editPage];

    if (page != &pfm3ButtonLfos) {
        return;
    }
    uint8_t lfoNumber = synthState_->fullState.buttonState[page->buttonId];

    LfoParams *lfoParam = &synthState_->params->lfoOsc1;
    float *lfoPhase = (float*) &synthState_->params->lfoPhases;

    tft_->oscilloBgSetLfo(lfoParam[lfoNumber].shape, lfoParam[lfoNumber].freq, lfoParam[lfoNumber].keybRamp,
        lfoParam[lfoNumber].bias, lfoPhase[lfoNumber]);
    tft_->oscilloBgActionLfo();
}

void FMDisplayEditor::refreshLfoEnv() {
    const struct Pfm3EditMenu *editMenu = mainMenu.editMenu[synthState_->fullState.mainPage];
    const struct Pfm3OneButton *page = editMenu->pages[synthState_->fullState.editPage];

    if (page != &pfm3ButtonEnvs) {
        return;
    }
    uint8_t envNumber = synthState_->fullState.buttonState[page->buttonId];

    if (envNumber == 0) {
        EnvelopeLfoParams *envParam = &synthState_->params->lfoEnv1;
        tft_->oscilloBgSetLfoEnvelope(envParam->attack, envParam->decay, 1.0f, envParam->release, 1.0f,
            envParam->sustain, envParam->sustain, 0.0f);
        tft_->oscilloBgActionEnvelope();
    } else if (envNumber == 1) {
        Envelope2LfoParams *envParam = &synthState_->params->lfoEnv2;
        tft_->oscilloBgSetLfoEnvelope(envParam->silence, envParam->attack, envParam->decay, 0.0f, 0.0f, 1.0f, 0.0f,
            0.0f);
        tft_->oscilloBgActionEnvelope();
    }

}

void FMDisplayEditor::checkOperatorNumber() {
    int numberOfOsc = algoInformation[(int)synthState_->params->engine1.algo].osc;

    if (unlikely(numberOfOsc == 3)) {
        // Special case for 3 operators
        // We don't want button 4 to be selected
        synthState_->fullState.buttonState[BUTTONID_OPERATOR_3_4] = 0;
    }

    // If lower number of Osc, adjust current selected one so that it shows up on screen
    // when going to operator page
    if (synthState_->fullState.operatorNumber > (numberOfOsc - 1)) {
        synthState_->fullState.operatorNumber = (numberOfOsc - 1);
    }
}
