Ixox/preenfm3/firmware/Src/synth/Voice.cpp

/*
 * Copyright 2013 Xavier Hosxe
 *
 * Author: Xavier Hosxe (xavier . hosxe (at) gmail . com)
 *
 * This program is free software: you can redistribute it and/or modify
 * it under the terms of the GNU General Public License as published by
 * the Free Software Foundation, either version 3 of the License, or
 * (at your option) any later version.
 * This program is distributed in the hope that it will be useful,
 * but WITHOUT ANY WARRANTY; without even the implied warranty of
 * MERCHANTABILITY or FITNESS FOR A PARTICULAR PURPOSE.  See the
 * GNU General Public License for more details.
 * You should have received a copy of the GNU General Public License
 * along with this program.  If not, see <http://www.gnu.org/licenses/>.
 */

#include <math.h>

#include "Voice.h"
#include "Timbre.h"


float Voice::glidePhaseInc[13];
float Voice::mpeBitchBend[6];

//for bitwise manipulations
#define FLOAT2SHORT 32768.f
#define SHORT2FLOAT 1./32768.f

#define RATIOINV 1./131072.f

#define SVFRANGE 1.23f
#define SVFOFFSET 0.151f
#define SVFGAINOFFSET 0.3f

#define LP2OFFSET -0.045f
#define min(a,b)                ((a)<(b)?(a):(b))

extern float noise[32];

#define filterWindowMin 0.01f
#define filterWindowMax 0.99f

inline
float expf_fast(float a) {
  //https://github.com/ekmett/approximate/blob/master/cbits/fast.c
  union { float f; int x; } u;
  u.x = (int) (12102203 * a + 1064866805);
  return u.f;
}
inline
float sqrt3(const float x)
{
  union
  {
    int i;
    float x;
  } u;

  u.x = x;
  u.i = (1 << 29) + (u.i >> 1) - (1 << 22);
  return u.x;
}
inline
float tanh3(float x)
{
    //return x / (0.7f + fabsf(0.8f * x));
    return 1.5f * x / (1.7f + fabsf(0.34f * x * x));
}
inline
float tanh4(float x)
{
    return x / sqrt3(x * x + 1);
}
inline
float sat25(float x)
{
    if (unlikely(fabsf(x) > 4))
        return 0;
    return x * (1.f - fabsf(x * 0.25f));
}
inline
float sat66(float x)
{
    return x * (1 - (x * x * 0.055f));
}
inline
float sat33(float x)
{
    if (unlikely(fabsf(x) > 2.58f))
        return 0;
    return x * (1 - x * x * 0.15f);
}
inline
float clamp(float d, float min, float max) {
  const float t = unlikely(d < min) ? min : d;
  return unlikely(t > max) ? max : t;
}
inline
float satSin(float x, float drive, uint_fast16_t pos) {
    //https://www.desmos.com/calculator/pdsqpi5lp6
    return x + clamp(x, -0.5f * drive, drive) * sinTable[((uint_fast16_t)(fabsf(x) * 360) + pos) & 0x3FF];
}
//https://www.musicdsp.org/en/latest/Other/120-saturation.html
inline
float sigmoid(float x)
{
    return x * (1.5f - 0.5f * x * x);
}
inline
float sigmoidPos(float x)
{
    //x : 0 -> 1
    return (sigmoid((x * 2) - 1) + 1) * 0.5f;
}
float fold(float x4) {
    // https://www.desmos.com/calculator/ge2wvg2wgj
    // x4 = x / 4
    return (fabsf(x4 + 0.25f - roundf(x4 + 0.25f)) - 0.25f);
}
inline
float wrap(float x) {
    return x - floorf(x);
}
enum NewNoteType {
    NEW_NOTE_FREE = 0,
    NEW_NOTE_RELEASE,
    NEW_NOTE_OLD,
    NEW_NOTE_NONE
};
//TB303 filter emulation ------
const float filterpoles[10][64] = {
    {-1.42475857e-02, -1.10558351e-02, -9.58097367e-03,
     -8.63568249e-03, -7.94942757e-03, -7.41570560e-03,
     -6.98187179e-03, -6.61819537e-03, -6.30631927e-03,
     -6.03415378e-03, -5.79333654e-03, -5.57785533e-03,
     -5.38325013e-03, -5.20612558e-03, -5.04383985e-03,
     -4.89429884e-03, -4.75581571e-03, -4.62701254e-03,
     -4.50674977e-03, -4.39407460e-03, -4.28818259e-03,
     -4.18838855e-03, -4.09410427e-03, -4.00482112e-03,
     -3.92009643e-03, -3.83954259e-03, -3.76281836e-03,
     -3.68962181e-03, -3.61968451e-03, -3.55276681e-03,
     -3.48865386e-03, -3.42715236e-03, -3.36808777e-03,
     -3.31130196e-03, -3.25665127e-03, -3.20400476e-03,
     -3.15324279e-03, -3.10425577e-03, -3.05694308e-03,
     -3.01121207e-03, -2.96697733e-03, -2.92415989e-03,
     -2.88268665e-03, -2.84248977e-03, -2.80350622e-03,
     -2.76567732e-03, -2.72894836e-03, -2.69326825e-03,
     -2.65858922e-03, -2.62486654e-03, -2.59205824e-03,
     -2.56012496e-03, -2.52902967e-03, -2.49873752e-03,
     -2.46921570e-03, -2.44043324e-03, -2.41236091e-03,
     -2.38497108e-03, -2.35823762e-03, -2.33213577e-03,
     -2.30664208e-03, -2.28173430e-03, -2.25739130e-03,
     -2.23359302e-03},
    {1.63323670e-16, -1.61447133e-02, -1.99932070e-02,
     -2.09872000e-02, -2.09377795e-02, -2.04470150e-02,
     -1.97637613e-02, -1.90036975e-02, -1.82242987e-02,
     -1.74550383e-02, -1.67110053e-02, -1.59995606e-02,
     -1.53237941e-02, -1.46844019e-02, -1.40807436e-02,
     -1.35114504e-02, -1.29747831e-02, -1.24688429e-02,
     -1.19916965e-02, -1.15414484e-02, -1.11162818e-02,
     -1.07144801e-02, -1.03344362e-02, -9.97465446e-03,
     -9.63374867e-03, -9.31043725e-03, -9.00353710e-03,
     -8.71195702e-03, -8.43469084e-03, -8.17081077e-03,
     -7.91946102e-03, -7.67985179e-03, -7.45125367e-03,
     -7.23299254e-03, -7.02444481e-03, -6.82503313e-03,
     -6.63422244e-03, -6.45151640e-03, -6.27645413e-03,
     -6.10860728e-03, -5.94757730e-03, -5.79299303e-03,
     -5.64450848e-03, -5.50180082e-03, -5.36456851e-03,
     -5.23252970e-03, -5.10542063e-03, -4.98299431e-03,
     -4.86501921e-03, -4.75127814e-03, -4.64156716e-03,
     -4.53569463e-03, -4.43348032e-03, -4.33475462e-03,
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



Voice::Voice(void) {

    if (glidePhaseInc[0] != .2f) {
        float tmp[] = { 2.0f, 5.0f, 9.0f, 15.0f, 22.0f, 35.0f, 50.0f, 90.0f, 140.0f, 200.0f, 500.0f, 1200.0f, 2700.0f };
        for (int k = 0; k < 13; k++) {
            glidePhaseInc[k] = 1.0f / tmp[k];
        }
    }


    // We multiply by 10 the number of semitone to have the direct index in exp2_harm
    if (mpeBitchBend[1] != 480.0f) {
        float tmp[] = { 0.0f, 480.0f, 360.0f, 240.0f, 120.0, 0.0f };
        for (int k = 0; k < 6; k++) {
            mpeBitchBend[k] = tmp[k];
        }
    }

    freqAi = freqAo = 0.0f;
    freqBi = freqBo = 0.0f;
    freqHarm = 1.0f;
    targetFreqHarm = 0.0f;
    index = 0;

    // Init FX variables
    v0L = v1L = v2L = v3L = v4L = v5L = v6L = v7L = v8L = v0R = v1R = v2R = v3R = v4R = v5R = v6R = v7R = v8R = v8R = 0.0f;
    fxParam1PlusMatrix = -1.0;

}

Voice::~Voice(void) {
}

void Voice::init() {
    this->currentTimbre = 0;
    this->playing = false;
    this->isFullOfZero = false;
    this->newNotePending = false;
    this->note = 0;
    this->midiVelocity = 0;
    this->holdedByPedal = false;
    this->newNotePlayed = false;
    this->nextMainFrequency = 0.0f;
}

void Voice::glideToNote(short newNote, float newNoteFrequency) {
    // Must glide...
    this->gliding = true;
    this->glidePhase = 0.0f;
    this->nextGlidingNote = newNote;
    this->nextGlidingNoteFrequency = newNoteFrequency;
    if (this->holdedByPedal) {
        glideFirstNoteOff();
    }

    currentTimbre->osc1_.glideToNote(&oscState1_, newNoteFrequency);
    currentTimbre->osc2_.glideToNote(&oscState2_, newNoteFrequency);
    currentTimbre->osc3_.glideToNote(&oscState3_, newNoteFrequency);
    currentTimbre->osc4_.glideToNote(&oscState4_, newNoteFrequency);
    currentTimbre->osc5_.glideToNote(&oscState5_, newNoteFrequency);
    currentTimbre->osc6_.glideToNote(&oscState6_, newNoteFrequency);
}

void Voice::noteOnWithoutPop(short newNote, float newNoteFrequency, short velocity, uint32_t index, float phase) {
    // Update index : so that few chance to be chosen again during the quick dying
    this->index = index;
    // We can glide in mono and unison
    if (!this->released &&  currentTimbre->params_.engine1.playMode != PLAY_MODE_POLY && currentTimbre->params_.engine2.glideType != GLIDE_TYPE_OFF) {
        glideToNote(newNote, newNoteFrequency);
        this->holdedByPedal = false;
        newGlide=false;
    } else {
        // update note now so that the noteOff is triggered by the new note
        this->note = newNote;
        this->midiVelocity = velocity;
        this->noteFrequency = newNoteFrequency;
        // Quick dead !
        this->newNotePending = true;
        this->pendingNoteVelocity = velocity;
        this->pendingNote = newNote;
        this->pendingNoteFrequency = newNoteFrequency;
        this->phase_ = phase;

        // Not release anymore... not available for new notes...
        this->released = false;

        this->currentTimbre->env1_.noteOffQuick(&envState1_);
        this->currentTimbre->env2_.noteOffQuick(&envState2_);
        this->currentTimbre->env3_.noteOffQuick(&envState3_);
        this->currentTimbre->env4_.noteOffQuick(&envState4_);
        this->currentTimbre->env5_.noteOffQuick(&envState5_);
        this->currentTimbre->env6_.noteOffQuick(&envState6_);
        // We don't want noteOnAfterMatrixCompute to restart the env or => Hanging note !!!
        this->newNotePlayed = false;
    }
}

void Voice::glide() {
    this->glidePhase += glidePhaseInc[(int) (currentTimbre->params_.engine1.glideSpeed + .05f)];
    if (glidePhase < 1.0f) {

        currentTimbre->osc1_.glideStep(&oscState1_, this->glidePhase);
        currentTimbre->osc2_.glideStep(&oscState2_, this->glidePhase);
        currentTimbre->osc3_.glideStep(&oscState3_, this->glidePhase);
        currentTimbre->osc4_.glideStep(&oscState4_, this->glidePhase);
        currentTimbre->osc5_.glideStep(&oscState5_, this->glidePhase);
        currentTimbre->osc6_.glideStep(&oscState6_, this->glidePhase);

    } else {
        // last with phase set to 1 to have exact frequencry
        currentTimbre->osc1_.glideStep(&oscState1_, 1);
        currentTimbre->osc2_.glideStep(&oscState2_, 1);
        currentTimbre->osc3_.glideStep(&oscState3_, 1);
        currentTimbre->osc4_.glideStep(&oscState4_, 1);
        currentTimbre->osc5_.glideStep(&oscState5_, 1);
        currentTimbre->osc6_.glideStep(&oscState6_, 1);
        this->gliding = false;
    }
}

// This is the frequency used for oscilloscope sync
// It's based on oscState1_ characteristics

float Voice::getNoteRealFrequencyEstimation(float newNoteFrequency) {
    return currentTimbre->osc1_.getNoteRealFrequencyEstimation(&oscState1_, newNoteFrequency);
}

void Voice::noteOn(short newNote, float newNoteFrequency, short velocity, uint32_t index, float phase) {


    // On noteOn we can only glide in mono and unison with glideType ALWAYS
    if (unlikely(currentTimbre->params_.engine1.playMode != PLAY_MODE_POLY
        && currentTimbre->params_.engine2.glideType == GLIDE_TYPE_ALWAYS)) {
        if (unlikely(this->nextMainFrequency != 0.0f)) {
            this->noteFrequency = this->nextMainFrequency;
        } else {
            this->noteFrequency = newNoteFrequency;
        }
        glideToNote(newNote, newNoteFrequency);
        newGlide=true;
        this->note = newNote;
        this->nextMainFrequency = newNoteFrequency;
    } else {
        this->note = newNote;
        this->noteFrequency = newNoteFrequency;

        if (unlikely(currentTimbre->params_.engine2.unisonDetune < 0.0f)) {
            phase = 0.25f;
        }

        currentTimbre->osc1_.newNote(&oscState1_, newNoteFrequency, phase);
        currentTimbre->osc1_.newNote(&oscState1_, newNoteFrequency, phase);
        currentTimbre->osc2_.newNote(&oscState2_, newNoteFrequency, phase);
        currentTimbre->osc3_.newNote(&oscState3_, newNoteFrequency, phase);
        currentTimbre->osc4_.newNote(&oscState4_, newNoteFrequency, phase);
        currentTimbre->osc5_.newNote(&oscState5_, newNoteFrequency, phase);
        currentTimbre->osc6_.newNote(&oscState6_, newNoteFrequency, phase);
    }

    this->midiVelocity = velocity;
    this->released = false;
    this->playing = true;
    this->isFullOfZero = false;
    this->pendingNote = 0;
    this->newNotePending = false;
    this->holdedByPedal = false;
    this->index = index;
    this->fdbLastValue[0] = 0.0f;
    this->fdbLastValue[1] = 0.0f;
    this->fdbLastValue[2] = 0.0f;

    this->velIm1 = currentTimbre->params_.engineIm1.modulationIndexVelo1 * (float) velocity * .0078125f;
    this->velIm2 = currentTimbre->params_.engineIm1.modulationIndexVelo2 * (float) velocity * .0078125f;
    this->velIm3 = currentTimbre->params_.engineIm2.modulationIndexVelo3 * (float) velocity * .0078125f;
    this->velIm4 = currentTimbre->params_.engineIm2.modulationIndexVelo4 * (float) velocity * .0078125f;
    this->velIm5 = currentTimbre->params_.engineIm3.modulationIndexVelo5 * (float) velocity * .0078125f;
    this->velIm6 = currentTimbre->params_.engineIm3.modulationIndexVelo6 * (float) velocity * .0078125f;

    int zeroVelo = (16 - currentTimbre->params_.engine1.velocity) * 8;
    int newVelocity = zeroVelo + ((velocity * (128 - zeroVelo)) >> 7);
    this->velocity = newVelocity * .0078125f; // divide by 127


    // Tell nextBlock() to init Env...
    this->newNotePlayed = true;

    lfoNoteOn();
}

void Voice::endNoteOrBeginNextOne() {
    if (this->newNotePending) {
        // pendingNote can be 255 : see Voice:noteOff
        if (pendingNote <= 127) {
            noteOn(pendingNote, pendingNoteFrequency, pendingNoteVelocity, index, phase_);
        } else {
            noteOn(pendingNote - 128, pendingNoteFrequency, pendingNoteVelocity, index, phase_);
            this->noteAlreadyFinished = 1;
        }
    } else {
        this->playing = false;
        this->released = false;
    }
    this->freqAi = 0.0f;
    this->freqAo = 0.0f;
    this->freqBi = 0.0f;
    this->freqBo = 0.0f;
}

void Voice::glideFirstNoteOff() {
    // while gliding the first note was released
    this->note = this->nextGlidingNote;
    this->noteFrequency = this->nextGlidingNoteFrequency;
    this->nextGlidingNote = 0;
}

void Voice::noteOff() {

    if (unlikely(!this->playing)) {
        return;
    }
    if (likely(!this->newNotePending)) {
        if (this->newNotePlayed) {
            // Note hasn't played
            // Let's give it a chance to create one block then noteOff
            this->noteAlreadyFinished = 1;
            return;
        }
        this->released = true;
        this->gliding = false;
        this->holdedByPedal = false;

        currentTimbre->env1_.noteOff(&envState1_, &matrix);
        currentTimbre->env2_.noteOff(&envState2_, &matrix);
        currentTimbre->env3_.noteOff(&envState3_, &matrix);
        currentTimbre->env4_.noteOff(&envState4_, &matrix);
        currentTimbre->env5_.noteOff(&envState5_, &matrix);
        currentTimbre->env6_.noteOff(&envState6_, &matrix);

        lfoNoteOff();
    } else {
        // We receive a note off before the note actually started, let's flag it
        this->pendingNote += 128;
    }
}

// Called when loading new preset
void Voice::noteOffQuick() {

    if (unlikely(!this->playing)) {
        return;
    }

    if (this->newNotePlayed) {
        // Note hasn't played
        killNow();
        return;
    }
    this->released = true;
    this->gliding = false;
    this->holdedByPedal = false;

    currentTimbre->env1_.noteOffQuick(&envState1_);
    currentTimbre->env2_.noteOffQuick(&envState2_);
    currentTimbre->env3_.noteOffQuick(&envState3_);
    currentTimbre->env4_.noteOffQuick(&envState4_);
    currentTimbre->env5_.noteOffQuick(&envState5_);
    currentTimbre->env6_.noteOffQuick(&envState6_);

    lfoNoteOff();
}

void Voice::killNow() {
    this->newNotePlayed = false;
    this->playing = false;
    this->newNotePending = false;
    this->pendingNote = 0;
    this->nextGlidingNote = 0;
    this->gliding = false;
    this->released = false;
    this->env1ValueMem = 0;
    this->env2ValueMem = 0;
    this->env3ValueMem = 0;
    this->env4ValueMem = 0;
    this->env5ValueMem = 0;
    this->env6ValueMem = 0;
}

void Voice::emptyBuffer() {
    if (!isFullOfZero) {
        isFullOfZero = true;
        float *sample = sampleBlock;

        for (int k = 0; k < BLOCK_SIZE; k++) {
            *sample++ = 0.0f;
            *sample++ = 0.0f;
        }
    }
}
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
