Ixox/preenfm3/firmware/Src/synth/Synth.cpp

/*
 * Copyright 2013 Xavier Hosxe
 *
 * Author: Xavier Hosxe (xavier . hosxe (at) gmail . com)
 *
 * This program is free software: you can redistribute it and/or modify
 * it under the terms of the GNU General Public License as published by
 * the Free Software Foundation, either version 3 of the License, or
 * (at your option) any later version.
 * This program is distributed in the hope that it will be useful,
 * but WITHOUT ANY WARRANTY; without even the implied warranty of
 * MERCHANTABILITY or FITNESS FOR A PARTICULAR PURPOSE.  See the
 * GNU General Public License for more details.
 * You should have received a copy of the GNU General Public License
 * along with this program.  If not, see <http://www.gnu.org/licenses/>.
 */

#include "stm32h7xx_hal.h"
#include "Synth.h"
#include "Menu.h"
#include "Sequencer.h"

extern RNG_HandleTypeDef hrng;
extern float noise[32];

Synth::Synth(void) {
}

Synth::~Synth(void) {
}

inline
float sqrt3(const float x)
{
  union
  {
    int i;
    float x;
  } u;

  u.x = x;
  u.i = (1 << 29) + (u.i >> 1) - (1 << 22);
  return u.x;
}

void Synth::init(SynthState *synthState) {
    for (int t = 0; t < NUMBER_OF_TIMBRES; t++) {
        for (uint16_t k = 0; k < (sizeof(struct OneSynthParams) / sizeof(float)); k++) {
            ((float*) &timbres_[t].params_)[k] = ((float*) &preenMainPreset)[k];
        }
        timbres_[t].init(synthState, t);
        for (int v = 0; v < MAX_NUMBER_OF_VOICES; v++) {
            timbres_[t].initVoicePointer(v, &voices_[v]);
        }
    }

    newTimbre(0);
    for (int k = 0; k < MAX_NUMBER_OF_VOICES; k++) {
        voices_[k].init();
    }
    rebuidVoiceAllTimbre();
    // Here synthState is already initialized
    for (int t = 0; t < NUMBER_OF_TIMBRES; t++) {
        timbres_[t].numberOfVoicesChanged(this->synthState_->mixerState.instrumentState_[t].numberOfVoices);
        smoothVolume_[t] = 0.0f;
        smoothPan_[t] = 0.0f;

        // Default is No compressor
        // We set the sample rate /32 because we update the env only once per BLOCK
        instrumentCompressor_[t].setSampleRate(PREENFM_FREQUENCY / 32.0f);
        instrumentCompressor_[t].setRatio(1.0f);
        instrumentCompressor_[t].setThresh(1000.0f);
        instrumentCompressor_[t].setAttack(10.0);
        instrumentCompressor_[t].setRelease(100.0);
    }

    // Cpu usage
    cptCpuUsage_ = 0;
    totalCyclesUsedInSynth_ = 0;
    numberOfPlayingVoices_ = 0;
    cpuUsage_ = 0.0f;
    totalNumberofCyclesInv_ = 1 / (SystemCoreClock * 32.0f * PREENFM_FREQUENCY_INVERSED);

}

void Synth::noteOn(int timbre, char note, char velocity) {
    if (synthState_->fullState.synthMode == SYNTH_MODE_SEQUENCER) {
        sequencer_->insertNote(timbre, note, velocity);
    }
    timbres_[timbre].noteOn(note, velocity);

}

void Synth::noteOff(int timbre, char note) {
    if (synthState_->fullState.synthMode == SYNTH_MODE_SEQUENCER) {
        sequencer_->insertNote(timbre, note, 0);
    }
    timbres_[timbre].noteOff(note);
}

void Synth::noteOnFromSequencer(uint8_t timbre, int16_t note, uint8_t velocity) {
    if (likely(note > 0 & note < 127)) {
        timbres_[timbre].noteOn(note, velocity);
    }
}

void Synth::noteOffFromSequencer(uint8_t timbre, int16_t note) {
    if (likely(note > 0 & note < 127)) {
        timbres_[timbre].noteOff(note);
    }
}

void Synth::midiClockContinue(int songPosition, bool tellSequencer) {
    for (int t = 0; t < NUMBER_OF_TIMBRES; t++) {
        timbres_[t].midiClockContinue(songPosition);
    }
    if (tellSequencer) {
        sequencer_->onMidiContinue(songPosition);
    }
}

void Synth::midiClockStart(bool tellSequencer) {
    for (int t = 0; t < NUMBER_OF_TIMBRES; t++) {
        timbres_[t].midiClockStart();
    }
    if (tellSequencer) {
        sequencer_->onMidiStart();
    }
}

void Synth::midiClockStop(bool tellSequencer) {
    for (int t = 0; t < NUMBER_OF_TIMBRES; t++) {
        timbres_[t].midiClockStop();
    }
    if (tellSequencer) {
        sequencer_->onMidiStop();
    }
}

void Synth::midiTick(bool tellSequencer) {
    for (int t = 0; t < NUMBER_OF_TIMBRES; t++) {
        timbres_[t].OnMidiClock();
    }
    if (tellSequencer) {
        sequencer_->onMidiClock();
    }
}

void Synth::midiClockSetSongPosition(int songPosition, bool tellSequencer) {
    if (tellSequencer) {
        sequencer_->midiClockSetSongPosition(songPosition);
    }
}

void Synth::setHoldPedal(int timbre, int value) {
    timbres_[timbre].setHoldPedal(value);
}

void Synth::allNoteOffQuick(int timbre) {
    int numberOfVoices = this->synthState_->mixerState.instrumentState_[timbre].numberOfVoices;
    for (int k = 0; k < numberOfVoices; k++) {
        // voice number k of timbre
        int n = timbres_[timbre].voiceNumber_[k];
        if (voices_[n].isPlaying()) {
            voices_[n].noteOffQuick();
        }
    }
}

void Synth::stopArpegiator(int timbre) {
    timbres_[timbre].resetArpeggiator();
}


void Synth::allNoteOff(int timbre) {
    int numberOfVoices = this->synthState_->mixerState.instrumentState_[timbre].numberOfVoices;
    for (int k = 0; k < numberOfVoices; k++) {
        // voice number k of timbre
        int n = timbres_[timbre].voiceNumber_[k];
        if (voices_[n].isPlaying() && !voices_[n].isReleased()) {
            voices_[n].noteOff();
        }
    }
}

void Synth::allSoundOff(int timbre) {
    int numberOfVoices = this->synthState_->mixerState.instrumentState_[timbre].numberOfVoices;
    for (int k = 0; k < numberOfVoices; k++) {
        // voice number k of timbre
        int n = timbres_[timbre].voiceNumber_[k];
        voices_[n].killNow();
    }
}

void Synth::allSoundOff() {
    for (int k = 0; k < MAX_NUMBER_OF_VOICES; k++) {
        voices_[k].killNow();
    }
}

bool Synth::isPlaying() {
    for (int k = 0; k < MAX_NUMBER_OF_VOICES; k++) {
        if (voices_[k].isPlaying()) {
            return true;
        }
    }
    return false;
}

void Synth::mixAndPan(int32_t *dest, float *source, float &pan, float sampleMultipler) {
    float sampleR, sampleL;
    if (likely(pan == 0)) {
        for (int s = 0; s < BLOCK_SIZE; s++) {
            sampleL = *(source++);
            sampleR = *(source++);

            *dest++ += sampleR * sampleMultipler;
            *dest++ += sampleL * sampleMultipler;
        }
        // No need for final calcul
        return;
    } else if (likely(pan > 0)) {
        float oneMinusPan = 1 - pan;
        for (int s = 0; s < BLOCK_SIZE; s++) {
            sampleL = *(source++);
            sampleR = *(source++);

            *dest++ += (sampleR + sampleL * pan) * sampleMultipler;
            *dest++ += sampleL * oneMinusPan * sampleMultipler;
        }
    } else if (pan < 0) {
        float onePlusPan = 1 + pan;
        float minusPan = -pan;
        for (int s = 0; s < BLOCK_SIZE; s++) {
            sampleL = *(source++);
            sampleR = *(source++);
            *dest++ += sampleR * onePlusPan * sampleMultipler;
            *dest++ += (sampleL + sampleR * minusPan) * sampleMultipler;
        }
    }
    //     final calcul
    //     pan never become null because of smoothing
    int closeToZero = pan * 100000;
    if (closeToZero == 0) {
        pan = 0.0f;
    }
}

/**
 * return : outputSaturated bit field
 */
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
