Ixox/preenfm3/(commit log)

2020-09-10 First public commit
    [ConfigurationFile.h, Upload and Debug Bootloader.cfg]
2020-09-12 Update headers + fix save preset and create preset bank
    [ConfigurationFile.h]
2020-09-22 Control board PCB added
    [pfm3_ctrl.dsn, pfm3_ctrl.kicad_pcb, pfm3_ctrl.sch]
2020-09-27 Menu : don't crash when empty button are pressed
    [FMDisplayMenu.cpp, Menu.cpp, SynthState.cpp]
2020-09-28 Silently load preset / DMA access to SD card
2020-09-28 Fix voice allocation problem while browsing preset
    [Synth.cpp, Timbre.cpp, Voice.h]
2020-09-30 3D case added
    [pfm3Bottom.stl, pfm3FrontPanel.f3d, pfm3Top.stl]
2020-09-30 Enhance Feedback algo with better low cut filter in phase modulation
2020-10-05 Fix feedback + fix problem with output number
    [Osc.h, Synth.cpp, Voice.cpp, Voice.h]
2020-10-07 Bootloader fixed : SD access don't use DMA
    [main.c]
2020-10-13 3DCaseB added
    [Rear.stl, Top.stl, bottom.stl, front.stl, pfm3EnclosureV2.f3d]
2020-10-21 Faster encoder polling
2020-10-21 Sequencer V2 + many small fixes
    [FMDisplayMenu.cpp, FMDisplaySequencer.cpp, FMDisplaySequencer.h, Menu.h, PreenFMFileType.h]
2020-10-23 Sequence V2 bug fix
    [FMDisplayEditor.cpp, FMDisplayMenu.cpp, FMDisplayMixer.cpp, FMDisplaySequencer.cpp, Sequencer.cpp]
2020-10-25 Fix seq cursor refresh bug
    [FMDisplaySequencer.cpp, FMDisplaySequencer.h]
2020-10-25 Bootloader 1.02 : use button 1,2,3
2020-10-27 Limit SD SPI to 12.5Mhz (will use actually 7.5Mhz)
2020-11-04 Bootlader 1.03 TFT fixed
    [bootloader.cpp, main.c]
2020-11-08 Control board v1.1
    [pfm3_ctrl.kicad_pcb, pfm3_ctrl.sch]
2020-11-08 Multiple param edition : EDIT + encoder turn
2020-11-08 Fix buton state bug (Crash)
    [Common.h]
2020-11-10 Put back to fast 40mbit/s SPI TFT communication
2020-11-10 Fix the voice problem when browsing the preset or randomize
    [Presets.cpp, Synth.cpp, SynthState.cpp]
2020-11-10 PCB 1.3 : encoder 2 moved 1mm
    [pfm3_ctrl.kicad_pcb, pfm3_ctrl.sch]
2020-11-14 Fix active timbre detection and voice realocation after preset change
    [Synth.cpp, main.c]
2020-11-19 PCB controlboard 1.2 proto
    [pfm3_ctrl.kicad_pcb, pfm3_ctrl.sch]
2020-11-21 Fix sequencer step problem when recording while swaping between normal and step mode.
    [Sequencer.cpp, Sequencer.h]
2020-11-21 Bootloader 1.06 : fix SD card access under windows when capacity > 4GB
2020-11-21 Start refactoring member variables '_' + sequencer bug fix + meter level global option
    [FMDisplay3.cpp, FMDisplay3.h, FMDisplayEditor.cpp, FMDisplayEditor.h, FMDisplayMenu.cpp, FMDisplayMenu.h, FMDisplayMixer.cpp, FMDisplayMixer.h]
2020-11-21 Nicer colors + fix 0.100 insead of 1.00 in mixer
    [FMDisplayMixer.cpp, FMDisplaySequencer.cpp]
2020-11-22 Scala scale Instr 0 Fix + Sala scale better display
    [FMDisplayMixer.cpp]
2020-11-22 Fix new preset loading + clean
    [FMDisplayMenu.cpp, PreenFMFileType.h]
2020-11-25 v0.97b : fix freeze when reubuilding timbre/voice association
    [Synth.cpp, Synth.h]
2020-11-26 Mixer>Voices : RED if problem with instrument poly/mono/unison mode
    [FMDisplay.h, FMDisplay3.cpp, FMDisplayMixer.cpp, FMDisplayMixer.h, FMDisplaySequencer.h, SynthState.cpp, SynthState.h]
2020-11-26 Fix MULTI-edit in operator envs
    [FMDisplayEditor.cpp, FMDisplaySequencer.cpp]
2020-11-28 TFT stability (slower, higher priority, smaller chunks for DMA push)
    [FMDisplay3.cpp, Menu.h, SynthState.cpp, TftAlgo.cpp, main.c]
2020-11-28 Clean up and decrease noise (slower GPIO, OLD PCB pinout, TFT backlight removed, MDMA)
    [FMDisplayMenu.cpp, Menu.cpp, Menu.h, SynthState.cpp, main.c, preenfm3.cpp]
2020-11-30 v0.98b : fix NRPN & preset save
    [Common.h, FMDisplayEditor.cpp, PreenFMFileType.h, Presets.cpp]
2020-12-02 TFT SPI Back to 40Mbits as it seems super stable with long test
2020-12-04 Add 6 buttons for encoder switches
2020-12-05 Fixed UNISON, which was totally broken in v0.98
    [FMDisplayEditor.cpp]
2020-12-05 Add option for futur Encoder Switch and cleaning
2020-12-08 Fixed possible freeze when loading Mixer with 0 voices
    [Synth.cpp]
2020-12-08 Scala loading based on scale name fixed
    [SynthState.cpp, Timbre.h]
2020-12-13 Don't crash when select clickable encoder with NO clicabke encoder
2020-12-13 User CC + Poly AfterTouch (channel pressure) + sequencer drives MidiClocked LFO
2020-12-16 Seqencer : fixe some cases where the Arpegiator continue after we stop playing
    [Sequencer.cpp]
2020-12-17 Fixed USB midi problem by limiting stm32h7xx_ll_usb.c to O2 gcc optimization
2020-12-18 Usb midi was filtering out PolyAfter touch data
2020-12-19 Decrease a little (40 to 32Mhz) the TFT SPI freq allow more consistant buffer reading
2020-12-20 Fix 2 mixer state problems in new created Mixer Bank
    [MixerState.cpp]
2020-12-24 Arp in preset is now On by default + add a button to move forward when enering new name
2020-12-25 Voice index bug fixed + Instr +&- now realyy stop all sounds
    [SynthState.cpp, Timbre.cpp, Timbre.h, Voice.cpp, Voice.h]
2020-12-25 Fix wrong test that make note=255 and cannot be stoped
    [Voice.cpp]
2020-12-31 UsbMidi flush fixed + different buffer for In and Out
    [FMDisplayMenu.cpp, MidiDecoder.cpp, Timbre.cpp, preenfm3.cpp]
2021-01-02 Better Encoder scan timing
2021-01-02 Small fix in Polyphonic voice choser
    [Timbre.cpp]
2021-01-02 QuickRelease is ALWAYS 6 blocks (Used to depend on current env value)
2021-01-02 Fixed typo in constant name
    [Synth.cpp, Synth.h]
2021-01-02 Play notes even when noteOff is received during QuickRelease of previous note + fix variable initialization problem when playing note the very first time
    [Voice.cpp, Voice.h]
2021-01-10 V0.103 : Ready for the editor
    * Ready for the Editor (USB & UI fixed)
    * Rename CHANNEL_PRESSURE to POLYPHONIC_AFTERTOUCH
    [Common.h, FMDisplay3.cpp, FMDisplayEditor.cpp, FMDisplayMixer.h, FMDisplaySequencer.h, MidiDecoder.cpp, MidiDecoder.h, Synth.cpp]
2021-01-17 Case B information updated
    [Rear_slim.stl, front_slim.stl]
2021-01-17 Swap encoder button 5 & 6
2021-01-26 Sequencer load fix + first notes fixed
    [FMDisplayMenu.cpp, Menu.cpp, Sequencer.cpp, Sequencer.h, main.c]
2021-04-06 v107 beta2 : renaming + pitch bend MPE fixed
    [Common.h, FMDisplayEditor.cpp, FMDisplayMenu.cpp, MidiDecoder.cpp]
2021-04-17 New enclosure added (3D printed + PCB)
    [3DPrint-Case.stl, 3DPrint-Rear.stl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]
2021-04-18 3DCasePCB add spacers/screws/nuts list
2021-10-15 Read PCB ID to adjust HC165 connection pins
2021-10-17 bug fix & reverb param order
    [FMDisplayMixer.cpp, FxBus.cpp]
2021-10-17 Firmware 1.08b : reverb fix
    [FxBus.h]
2021-10-24 Filter param 2 in the matrix (#22)
    * filter param2 in matrix
    * wip
    * some fix
    * bass & pan fix
    * param2 for crusher
    * cleaning
    * filter amp in modmatrix
    [Common.h, FMDisplayEditor.cpp, Voice.cpp]
2022-04-18 Menu+Seq switches between pfm3 and controller mode
2022-04-18 Encoder clean state function
2022-04-18 Letter shortcut with button
    [FMDisplayMidiController.cpp]
2022-07-09 Fix Possible noise when modifying MIX param
    [Voice.h]
2022-11-12 Fix Crash in Oscilloscope with very low frequency + negative fine tune (THANKS PATRICE git add firmware/Src/synth/Osc.cpp! :)
    [Osc.cpp]
2022-11-27 ControlBoard : Move files into v1 folder
    [pfm3_ctrl.dsn, pfm3_ctrl.kicad_pcb, pfm3_ctrl.sch]
2022-11-27 Control board v2
    [pfm3_ctrl-BOM-v2.0.csv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]
2022-11-27 TopSurface v2.0 added
    [pfm3_topsurface-B_Cu.gbr, pfm3_topsurface-B_Mask.gbr, pfm3_topsurface-B_SilkS.gbr, pfm3_topsurface-Edge_Cuts.gbr, pfm3_topsurface-F_Cu.gbr, pfm3_topsurface-F_Mask.gbr, pfm3_topsurface-F_SilkS.gbr, pfm3_topsurface-NPTH.drl]
2022-11-28 v2.0 JLCPCB ordered for test
    [pfm3_topsurface-B_Cu.gbr, pfm3_topsurface-B_Mask.gbr, pfm3_topsurface-B_SilkS.gbr, pfm3_topsurface-Edge_Cuts.gbr, pfm3_topsurface-F_Cu.gbr, pfm3_topsurface-F_Mask.gbr, pfm3_topsurface-F_SilkS.gbr, pfm3_topsurface-NPTH.drl]
2022-11-30 v1.2 encpder and switch positions with v2.0 connector
    [pfm3_ctrl.dsn, pfm3_ctrl.kicad_pcb, pfm3_ctrl.sch]
2023-02-13 Fix bug after Env refactor (Midi and Menu+enc) / Version set to 0.990
    [FMDisplayEditor.cpp, MidiDecoder.cpp]
2023-02-13 Fix Env midi NRPN
    [MidiDecoder.cpp, MidiDecoder.h]
2023-02-13 Fix NRPN from editor + bug fix + drawing optimization
    [FMDisplayEditor.cpp, FirmwareTftDisplay.cpp, FirmwareTftDisplay.h, MidiDecoder.cpp]
2023-02-13 Fix CC problem after env refactoring
    [MidiDecoder.cpp, MidiDecoder.h]
2023-02-13 Note + Encoder can create note when cursor over silence
2023-05-13 Filters: optimisation and bug fix
    Optimisation : less cpu for Wide, Dblr, 3Voi
    Bug fix : avoid explode of filters in some extreme case
    Enhancement : EQ on some filters, to get bass back
    Change filters order
    [FMDisplayEditor.cpp, SynthState.h, Timbre.cpp]
2023-05-13 hann window + 12khz noise
    [Timbre.cpp, Timbre.h]
2023-05-15 Small control board PCB modification: wider clearance around placement holes
    [pfm3_ctrl.kicad_pcb]
2023-05-22 Fix Copy and Paste
    [FMDisplayEditor.cpp, FMDisplayEditor.h]
2023-05-24 Fix crash when copying empty params
    [FMDisplayEditor.cpp]
2023-05-27 ping & diff extra lp, doubler level fix
    [Timbre.cpp, Timbre.h]
2023-06-18 v1.01 fix preset name problem with the VST editor
    [Common.h, MidiDecoder.cpp]
2023-10-22 Mixer volume : ENCODER + MENU => modify volumes of all instruments on same DAC
2023-10-22 Fix vtable compilation problem with STM32CubeIDE 1.10
    [SynthParamListener.h]
2023-10-22 Patrice Vigouroux effects improvement (Granul2) (#43)
    * ok
    * more delay feedback
    * delay f square control
    * hp optimization...
    * grain : quartic spread
    * cleanup, bug fix & grain2 tuning
    * grain onset
    * grain tweak
    * grain hold mode trig
    * ram optim
    * lock fix
    * delay hp, grains, dim
    * delay hp, grain2 lp
    * code cleaning & ram optimisation
    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
    [FMDisplay3.cpp, FMDisplayEditor.cpp, FMDisplayMenu.cpp, SynthState.h, Timbre.cpp, Timbre.h, Voice.cpp]
2024-03-17 Toltekradiation/pvig : "vosim" algos + midi CC for filter 2 + filter fixes
    Toltekradiation (pvig) :
    * Voisim algos (29->32)
    * midi CC for filter 2
    * adjustement for Filter2 Bode and Filter1 Sigma
    [Common.cpp, Common.h, FMDisplayEditor.cpp, MidiDecoder.cpp, MidiDecoder.h, Osc.cpp, Osc.h, TftAlgo.cpp]
